Ding-Jeremy/Self-Balancing-Bot/A_Documentation/Rapport/acronyms.tex

\newacronym{pid}{PID}{Proportionnal Integral Derivative}
\newacronym{imu}{IMU}{Inertial Measurement Unit}
\newacronym{foc}{FOC}{Field Oriented Control}
\newacronym{pcb}{PCB}{Printed Circuit Board}
\newacronym{gpio}{GPIO}{General Purpose Input/Output}
\newacronym{ldo}{LDO}{Low Drop Out Regulator}
\newacronym{lipo}{LiPo}{Lithium Polymer}
\newacronym{http}{HTTP}{Hypertext Transfer Protocol}
\newacronym{https}{HTTPS}{Hypertext Transfer Protocol Secure}
\newacronym{ws}{WS}{WebSocket}
\newacronym{html}{HTML}{HyperText Markup Language}
\newacronym{css}{CSS}{Cascading Style Sheets}
\newacronym{js}{JS}{JavaScript}
\newacronym{json}{JSON}{JavaScript Object Notation}
\newacronym{api}{API}{Application Programming Interface}
\newacronym{pwa}{PWA}{Progressive Web App}
\newacronym{uri}{URI}{Uniform Resource Identifier}
\newacronym{url}{URL}{Uniform Resource Locator}
\newacronym{spa}{SPA}{Singe Page Application}
\newacronym{fdm}{FDM}{Fused Filament Fabrication}
\newacronym{lqr}{LQR}{Linear Quadratic Regulator}
