Ding-Jeremy/Self-Balancing-Bot/A_Documentation/Rapport/report.tex

\documentclass[
    iai, % Saisir le nom de l'institut rattaché
    eem, % Saisir le  nom de l'orientation
    %confidential, % Décommentez si le travail est confidentiel
]{heig-tb} 

\usepackage[nooldvoltagedirection,european,americaninductors]{circuitikz}
%% \signature{jding.svg} % Remplacer par votre propre signature vectorielle.
\usepackage{pdflscape}
\usepackage{pdfpages}
\usepackage{listings}
\usepackage{xcolor}
\usepackage{subcaption}
\raggedbottom

\lstset{
    language=C++,
    basicstyle=\ttfamily\small,
    keywordstyle=\color{blue},
    commentstyle=\color{gray},
    stringstyle=\color{red},
    numbers=left,
    breaklines=true,
    showstringspaces=false,
    inputencoding=utf8,
    extendedchars=true,
    literate=
        {é}{{\'e}}1
        {è}{{\`e}}1
        {ê}{{\^e}}1
        {à}{{\`a}}1
        {â}{{\^a}}1
        {ç}{{\c{c}}}1
        {°}{{\textdegree}}1
}
\makenomenclature
\makeglossaries
\makeindex
\addbibresource{bibliography.bib}   
  
\input{acronyms.tex}
\input{glossary.tex}
\input{meta.tex} 

\surroundwithmdframed{minted} 
 
%% Début du document
\begin{document}
\selectlanguage{french}
\maketitle
\frontmatter

%% Requis par les dispositions générales des travaux de Bachelor
\preamble
\authentification
%% Résumé / Résumé publiable / Version abrégée

%% Sommaire et tables
\tableofcontents
\listoffigures
\listoftables
\listoflistings

\input{nomenclature.tex}

\printglossary[type=\acronymtype]

\pagenumbering{arabic}

%% Contenu
\mainmatter
\chapter{Introduction}
\input{content/introduction.tex}
%\input{content/examples.tex}
\chapter{Principe physique}
\input{content/principe_physique.tex}
\label{chap:principe_physique}
\chapter{Choix composants}
\label{chap:choix_composants}
\input{content/choix_composants.tex}

\chapter{Mécanique}
\label{chap:mecanique}
\input{content/mecanique.tex}
\chapter{Modélisation}
\label{chap:modelisation}
\input{content/modelisation.tex}
\chapter{Electronique}
\label{chap:electronique}
\input{content/electronique.tex}
\chapter{Développement embarqué}
\label{chap:developpement_embarque}
\input{content/developpement_embarque.tex}
\chapter{Interface WEB}
\label{chap:interface_web}
\input{content/interface_web}
\chapter{Validation expérimentale} 
\input{content/validation.tex}
\chapter{Conclusion} 
\input{content/conclusion.tex}

\clearpage
\printbibliography
 
\appendix
\appendixpage
\addappheadtotoc
\chapter{Entretiens}
\input{content/entretiens.tex}

\chapter{Schéma, PCB}
\label{annexe:schema_electrique}

\includepdf[
    pages=-,
    fitpaper=true,
    pagecommand={\thispagestyle{plain}}
]{assets/annexes/Self_Balancing_Bot_V0.pdf}

\includepdf[
    pages=-,
    fitpaper=true,
    pagecommand={\thispagestyle{plain}}
]{assets/annexes/kicad_pcb_fcu.pdf}
\includepdf[
    pages=-,
    fitpaper=true,
    pagecommand={\thispagestyle{plain}}
]{assets/annexes/kicad_pcb_in1cu.pdf}
\includepdf[
    pages=-,
    fitpaper=true,
    pagecommand={\thispagestyle{plain}}
]{assets/annexes/kicad_pcb_in2cu.pdf}
\includepdf[
    pages=-,
    fitpaper=true,
    pagecommand={\thispagestyle{plain}}
]{assets/annexes/kicad_pcb_bcu.pdf}

\chapter{Bill Of Material}

\label{annexe:bom}
\includepdf[
    pages=-,
    fitpaper=true,
    pagecommand={\thispagestyle{plain}}
]{assets/annexes/bom.pdf}

\chapter{Dépôt Git}
\label{annexe:git}
L'ensemble du projet est versionné avec \textit{Git}. Le dépôt regroupe le firmware embarqué, l'interface Web, les schémas électroniques, le présent rapport ainsi que les différents documents administratifs relatifs au projet.

Le dépôt GitHub est accessible à l'adresse suivante :

\begin{center}
\href{https://github.com/Ding-Jeremy/Self-Balancing-Bot}{github.com/Ding-Jeremy/Self-Balancing-Bot}
\end{center}

\let\cleardoublepage\clearpage
\backmatter

\label{glossaire}
\glsaddall[types=main]
\printglossary
\label{index}
\printindex

\end{document}
