Ding-Jeremy/Self-Balancing-Bot/A_Documentation/Rapport/glossary.tex

\newglossaryentry{heig-vd}{
    name=HEIG-VD,
    description={Haute École d'Ingénierie et de Gestion du canton de Vaud}
}
\newglossaryentry{hes-so}{
    name=HES-SO,
    description={Haute École Supérieure de Suisse Occidentale}
}

\newglossaryentry{eth}{
    name=ETH,
    description={Haute École Supérieure de Suisse Occidentale}
}

\newglossaryentry{uart}{
    name=UART,
    description={Universal Asynchroneous Receive Transmit, serial protocol}
}
