Ding-Jeremy/Self-Balancing-Bot/A_Documentation/Rapport/content/electronique.tex

Cette partie présente la conception et la réalisation de l'architecture électronique développée pour le système. Elle décrit les différents choix effectués afin de répondre aux contraintes liées à l'alimentation, au traitement des informations, au pilotage des actionneurs et à l'intégration des différents composants électroniques.

Dans un premier temps, la méthode de conception ainsi que les outils utilisés sont introduits. L'architecture générale du système est ensuite présentée au travers d'un schéma bloc permettant d'identifier les principaux sous-ensembles électroniques et leurs interactions. Les solutions retenues pour l'alimentation sont détaillées, notamment le dimensionnement de la source d'énergie, les dispositifs de conversion de tension et la distribution des différentes alimentations nécessaires aux composants.

La conception de l'électronique de commande est ensuite abordée avec la présentation du microcontrôleur ESP32, des circuits de pilotage des moteurs pas à pas ainsi que du module de mesure inertielle. Les choix de composants sont justifiés en fonction des besoins du système et des contraintes de fonctionnement.

Enfin, cette partie décrit la réalisation du schéma électrique complet, l'assemblage des premiers prototypes sur breadboard ainsi que la conception du circuit imprimé \gls{pcb}
\section{Méthode et outils}

Dans un premier temps, il est important de présenter les différents outils utilisés dans la conception et la réalisation de la partie électronique du projet.

\begin{table}[H]
\centering
\begin{tabular}{|l|l|}
\hline
\textbf{Tâche} & \textbf{Outil utilisé} \\
\hline
Conception des schémas électriques et architecture bloc & draw.io (diagrams.net) \\
\hline
Conception et routage du PCB & KiCad 9.0 \\
\hline
\end{tabular}
\caption{Outils utilisés dans la réalisation de la partie électronique du projet}
\label{tab:outils_utilises_electronique}
\end{table}

\section{Alimentation}
\label{section:alimentation}
Afin de designer correctement le système électrique, il est important de définir les prérequis en terme d'alimentation. Plus précisemment, le but est ici de déterminer les tensions et courants de fonctionnement nécessaires pour les
différents modules.
\subsection{ESP32}
L'ESP32 Devkit V1 \cite{ESP32-Devkit-V1} peut être alimenté de deux manière différentes. Soit alimenté en 5 V soit en 3.3 V. En effet ce dernier possède un réglateur linéaire,  \gls{ldo} offrant une tension de 3.3 V.
Ce régulateur sert à générer la tension nécessaire au fonctionnement du chip ESP32 présent sur la carte de développement mais peut également être utilisé pour alimenter des modules externes pour autant que ces derniers ne consomment pas trop d'énérgie.
Le \acrshort{ldo} est de type \cite{AMS1117} et offre un courant de 1 A pour une chute de tension de 1.2 V.
Comme indiqué dans le chapitre \ref{chap:choix_composants}, le courant consommé par l'ESP32 dépend de son utilisation, dans le pire cas de figure, ce dernier consomme un courant maximale de:
$$I_{ESP,max} = 0.4 \si\ampere$$
Cela veut dire que le LDO présent sur la carte de développement peut fournir un courant aux autres modules valant:
$$I_{LDO,max} = 0.6 \si\ampere$$

\subsection{TMC2226}
Le driver moteur nécessite deux alimentations distinctes, une alimentation pour la logique, $V_{IO}$, ainsi qu'une alimentation pour les moteurs, $V_{mot}$. Les valeurs de tensions nécessaires ont déjà étées indiquées dans le chapitre \ref{chap:choix_composants}. 
\begin{itemize}
    \item Tension moteur : $V_{\mathrm{mot}} \in [5.5, 29]\,\mathrm{V}$
    \item Tension logique : $V_{\mathrm{DD}} \in [3.3, 5]\,\mathrm{V}$
\end{itemize}

En ce qui concerne le courant consommé par le module sur son entrée \SI{3.3}{V}, la valeur indiquée dans le datasheet \cite{TMC2226_datasheet} est présentée à la figure \ref{fig:tmc_2226_consumption}.

\begin{figure}[H]
    \centering
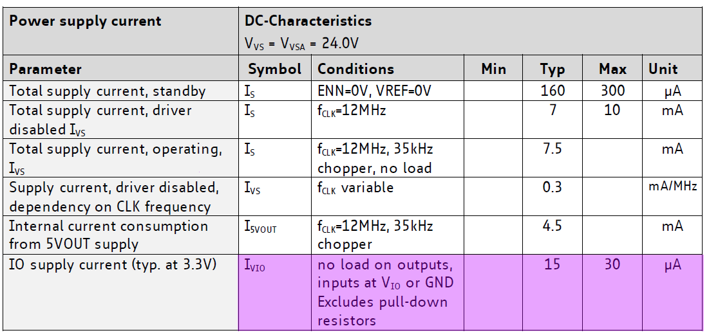
[picture p11: A_Documentation/Rapport/assets/figures/tmc2226_consumption.png]
    
    \caption{Consommation du TMC2226}
    \label{fig:tmc_2226_consumption}
\end{figure}

Le datasheet précise que cette valeur correspond au courant consommé lorsque les sorties ne fournissent aucune charge (\textit{no loads on output}). Aucune autre information concernant la consommation propre de la logique interne du composant n'est fournie.

Afin de conserver une marge de sécurité lors du dimensionnement de l'alimentation et d'éviter tout sous-dimensionnement, un courant de \SI{10}{mA} est retenu pour l'alimentation logique du module.

\subsection{MPU6050}
Le datasheet du module \acrshort{imu} \cite{MPU6050_Datasheet} indique les informations suivantes concernant la consommation d'énergie.
\begin{figure}[H]
    \centering
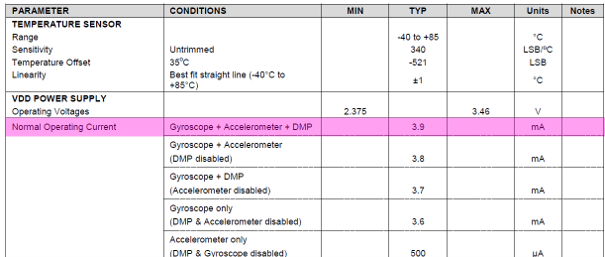
[picture p12: A_Documentation/Rapport/assets/figures/mpu_6050_consumption.png]
    
    \caption{Consommation MPU6050}
    \label{fig:mpu_6050_consumption}
\end{figure}

\subsection{Moteurs}
La puissance consommée par le moteur dépend de son point de fonctionnement.
À l'arrêt, l'énergie électrique est essentiellement dissipée sous forme de
pertes Joule dans les enroulements. En revanche, lorsque le moteur fournit un
couple et entraîne une charge, une partie de cette énergie est convertie en
puissance mécanique.
\subsubsection{Courant max}
\label{subsubsection:courant_max}
Le courant efficace fourni par le driver est réglé via un potentiomètre qui fixe la tension de référence $V_{\mathrm{ref}}$. Il est donné par :

\begin{equation}
    \begin{split}
        I_{\mathrm{RMS}} =
        \frac{0.325\,\mathrm{V}}{R_{\mathrm{sense}} + 0.02\,\Omega}
        \cdot \frac{1}{\sqrt{2}}
        \cdot \frac{V_{\mathrm{ref}}}{2.5\,\mathrm{V}}
    \end{split}
\end{equation}

La résistance de mesure $R_{\mathrm{sense}}$ est donnée par le constructeur du module \cite{BigTechTree_TMC2226}. Elle est également vérifiable physiquement sur le PCB et vaut :
\begin{equation}
R_{\mathrm{sense}} = 150\,\mathrm{m\Omega} = 0.150\,\Omega.
\end{equation}

Le moteur \cite{42SHD0217_datasheet} supporte un courant maximal de
$1.5\,\mathrm{A_{RMS}}$, ce qui conduit à

\begin{equation}
V_{\mathrm{ref,max}}
\approx
\frac{1.5}{0.540}
\approx
2.8\,\mathrm{V}.
\end{equation}

La plage théorique de fonctionnement est donc

\begin{equation}
0 \leq V_{\mathrm{ref}} \leq 2.8\,\mathrm{V}.
\end{equation}

Cependant, après essais du module BigTechTree \cite{BigTechTree_TMC2226}, il a été constaté que le potentiomètre ne permet de régler la tension
$V_{\mathrm{ref}}$ que dans une plage comprise entre environ
$0\,\mathrm{V}$ et $1.75\,\mathrm{V}$, bien que cette limitation ne soit pas explicitement mentionnée dans la documentation.

Une tension de référence de

\begin{equation}
V_{\mathrm{ref}} = 1.5\,\mathrm{V}
\end{equation}

est donc retenue. Elle correspond à un courant efficace dans les enroulements de

\begin{equation}
I_{\mathrm{RMS}}
\approx
0.540 \times 1.5
=
0.81\,\mathrm{A}.
\end{equation}

\begin{figure}[H]
    \centering
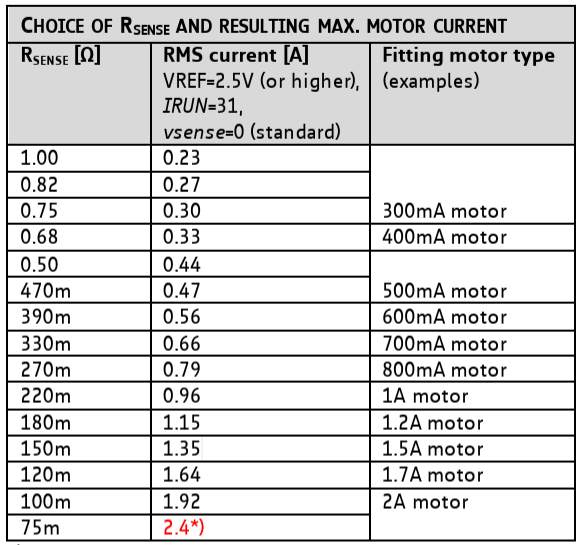
[picture p13: A_Documentation/Rapport/assets/figures/tmc_datasheet_rsense.png]
    
    \caption{Extrait de la documentation du TMC2226 présentant les différentes valeurs de résistance de mesure ($R_{\mathrm{sense}}$).}
    \label{fig:tmc2226_datasheet_rsense}
\end{figure}

La figure~\ref{fig:tmc2226_datasheet_rsense} présente les valeurs recommandées de $R_{\mathrm{sense}}$ en fonction du courant nominal du moteur. Dans le cas présent, le moteur possède un courant nominal de $1.5\,\mathrm{A}$, ce qui correspond bien à la résistance de mesure retenue \cite{42SHD0217_datasheet}.

\subsubsection{Puissance électrique}

La puissance électrique absorbée par le moteur peut être estimée par

\begin{equation}
P_{\mathrm{elec}}
\approx
2I_{\mathrm{RMS}}^{2}R_c
+
T_m\omega,
\end{equation}

où $I_{\mathrm{RMS}}$ est le courant efficace dans chaque enroulement,
$R_c$ la résistance d'une bobine,
$T_m$ le couple développé par le moteur et
$\omega$ sa vitesse angulaire.

Afin d'obtenir un ordre de grandeur, on considère un couple correspondant à la moitié du couple maximal du moteur ainsi qu'une vitesse de rotation de
1 tour/s.

La vitesse angulaire vaut alors

\begin{equation}
\omega
=
2\pi\times1
=
6.28\,\si{\radian\per\second}.
\end{equation}

La puissance mécanique développée est donc

\begin{equation}
P_{\mathrm{meca}}
=
T_m\omega
=
0.2\times6.28
=
1.26\,\si{\watt}.
\end{equation}

En prenant la valeur de résistance donnée par le datasheet du moteur pas à pas, 
$R_c=2.2\,\Omega$ et le courant efficace précédemment calculé, les pertes Joule valent

\begin{equation}
P_{\mathrm{Joule}}
=
2I_{\mathrm{RMS}}^2R_c
=
2\times0.81^2\times2.2
\approx
2.9\,\si{\watt}.
\end{equation}

La puissance électrique totale est alors estimée à

\begin{equation}
P_{\mathrm{elec}}
=
P_{\mathrm{Joule}}
+
P_{\mathrm{meca}}
=
2.9
+
1.26
\approx
4.16\,\si{\watt}.
\end{equation}

Afin de conserver une marge de sécurité pour le dimensionnement de la batterie, la puissance maximale consommée par un moteur est fixée à

\begin{equation}
P_{\mathrm{max}} = 5\,\si{\watt}.
\end{equation}
\subsection{Ensemble}
Voici ci-dessous un récapitulatif des différents modules ainsi que leurs caractéristiques électriques.

\begin{table}[H]
\centering
\begin{tabular}{|c|p{4.2cm}|c|c|c|}
\hline
\textbf{Module} & \textbf{Description} & \textbf{Tension} & \textbf{Courant} & \textbf{Puissance} \\
\hline
ESP32 DevKit V1 & Microcontrôleur & $5\,\si{\volt}$ & $400\,\si{\milli\ampere}$ (max.) & $2.0\,\si{\watt}$ \\
\hline
TMC2226 & Driver moteur (logique) & $3.3\,\si{\volt}$ & $\approx 30\,\si{\micro\ampere}$ & $\approx 99\,\si{\micro\watt}$ \\
\hline
MPU6050 & IMU (accéléromètre + gyroscope) & $3.3\,\si{\volt}$ & $\approx 4\,\si{\milli\ampere}$ & $\approx 13.2\,\si{\milli\watt}$ \\
\hline
42SHD0217 & Moteurs pas à pas & - & - & $\approx 10\,\si{\watt}$ \\
\hline
\end{tabular}
\caption{Caractéristiques électriques des différents modules.}
\label{tab:tensions_alimentations}
\end{table}
\subsection{Convertisseur / Régulateur}

Les modules alimentés en \SI{3.3}{\volt}, à savoir le MPU6050 et les entrées logiques des drivers TMC2226, présentent une consommation très faible. Leur courant total est inférieur à \SI{10}{\milli\ampere}. Cette consommation reste largement inférieure au courant maximal pouvant être fourni par le régulateur linéaire intégré à la carte ESP32 DevKit V1.

Il est donc possible d'utiliser directement la sortie \SI{3.3}{\volt} de la carte de développement pour alimenter l'ensemble de la partie logique du système, sans qu'un régulateur supplémentaire ne soit nécessaire. Cette solution permet de réduire le nombre de composants, de simplifier le schéma électrique et de limiter les coûts.

En revanche, le système est alimenté par une batterie dont la tension est supérieure à \SI{5}{\volt}. Une conversion de tension est donc nécessaire afin d'alimenter correctement la carte ESP32 DevKit V1. Pour cette fonction, un convertisseur DC/DC abaisseur (\emph{buck converter}) est retenu plutôt qu'un régulateur linéaire. En effet, un convertisseur à découpage présente un rendement élevé, généralement supérieur à 90\,\%, ce qui limite les pertes d'énergie et l'échauffement du système.

Le convertisseur retenu est le module TSR~1-2450E \cite{TSR1-2450E}. Celui-ci est disponible chez Distrelec et présente les caractéristiques principales suivantes :

\begin{itemize}
    \item tension d'entrée : $V_{\mathrm{in}} \in [7,36]\,\si{\volt}$ ;
    \item tension de sortie : $V_{\mathrm{out}} = \SI{5.0}{\volt}$ ;
    \item courant de sortie maximal : $I_{\mathrm{out,max}} = \SI{1}{\ampere}$ ;
    \item rendement typique : supérieur à 90\,\%.
\end{itemize}

Le courant maximal consommé par l'ensemble de l'électronique alimentée en \SI{5}{\volt} est estimé à environ \SI{0.4}{\ampere}. Le convertisseur dispose donc d'une marge de fonctionnement confortable, garantissant un fonctionnement fiable tout en laissant la possibilité d'ajouter de futurs périphériques.

\subsection{Batterie}
\subsubsection{Technologie}
\label{subsubsection:technologie}

Au regard des besoins du système, une batterie \gls{lipo} constitue la solution la plus adaptée. Ce type de batterie offre une densité énergétique élevée, un poids réduit ainsi qu'une capacité à fournir des courants importants, outre l'important courant, ces caractéristiques sont intéressantes pour ce cas d'application.

Par ailleurs, la documentation du driver moteur TMC2226 indique que les performances du moteur, notamment à vitesse élevée, sont améliorées lorsque la tension d'alimentation $V_{\mathrm{mot}}$ est importante. Une tension élevée permet en effet au courant de s'établir plus rapidement dans les enroulements malgré leur inductance, ce qui améliore le maintien du couple à vitesse élevée.

Pour cette raison, une batterie LiPo à quatre cellules (4S) est retenue. Une telle batterie présente une tension nominale de $\SI{14.8}{\volt}$, une tension maximale de $\SI{16.8}{\volt}$ lorsqu'elle est entièrement chargée et une tension minimale d'environ $\SI{12}{\volt}$ avant recharge. Cette plage de fonctionnement est compatible avec la tension d'alimentation admissible du TMC2226.

Le cahier des charges impose une autonomie minimale de

\begin{equation}
t_{\mathrm{life}}=\SI{30}{\minute}=0.5\,\si{\hour}.
\end{equation}
À partir de la consommation électrique estimée de l'ensemble du système, il est alors possible de déterminer la capacité énergétique minimale de la batterie.

\subsubsection{Capacité}

La capacité de la batterie est déterminée à partir de la puissance maximale consommée par le système ainsi que de l'autonomie imposée par le cahier des charges.

En notant $P_{\mathrm{tot}}$ la puissance totale consommée par le système, l'énergie minimale à fournir est donnée par

\begin{equation}
E_{\mathrm{bat}}
=
P_{\mathrm{tot}}\times t_{\mathrm{life}}
=
15\,\si{\watt}
\times
0.5\,\si{\hour}
=
7.5\,\si{\watt\hour}.
\end{equation}

La batterie devra donc être capable de fournir au minimum une énergie de
$\SI{7.5}{\watt\hour}$.

\subsubsection{Choix}

Parmi les batteries disponibles répondant aux critères précédents, le modèle
SWAY FPV LiPo 4S \cite{SWAY-FPV_LiPo-4S} a été retenu. Ses principales caractéristiques sont résumées dans le tableau~\ref{tab:batterie}.

\begin{table}[H]
\centering
\begin{tabular}{|l|c|}
\hline
\textbf{Caractéristique} & \textbf{Valeur} \\
\hline
Technologie & LiPo 4S \\
\hline
Tension nominale & $\SI{14.8}{\volt}$ \\
\hline
Capacité & $\SI{1.3}{\ampere\hour}$ \\
\hline
Énergie stockée & $\SI{19.24}{\watt\hour}$ \\
\hline
Courant de décharge maximal & $60C$ ($\SI{78}{\ampere}$) \\
\hline
Connecteur & XT60 \\
\hline
\end{tabular}
\caption{Caractéristiques de la batterie retenue.}
\label{tab:batterie}
\end{table}

L'énergie disponible dans cette batterie est donnée par

\begin{equation}
E_{\mathrm{bat}}
=
V_{\mathrm{nom}}
\times
C
=
14.8\times1.3
=
19.24\,\si{\watt\hour}.
\end{equation}

En supposant une consommation moyenne de
$P_{\mathrm{tot}}=\SI{15}{\watt}$, l'autonomie théorique vaut

\begin{equation}
t_{\mathrm{autonomie}}
=
\frac{E_{\mathrm{bat}}}{P_{\mathrm{tot}}}
=
\frac{19.24}{15}
=
1.28\,\si{\hour}
\approx
77\,\si{\minute}.
\end{equation}

Cette autonomie est largement supérieure à l'exigence minimale de
30 minutes définie dans le cahier des charges. La batterie retenue offre ainsi une marge confortable permettant de compenser les pertes du convertisseur DC/DC, les variations de consommation des moteurs ainsi que le vieillissement naturel de la batterie.

\section{Schéma Bloc}
Une fois les informations relatives aux composants, à la batterie et à l'architecture générale d'alimentation établies, il est possible d'esquisser un schéma bloc permettant de représenter de manière synthétique les différents modules du système ainsi que leurs interconnexions fonctionnelles.

\begin{figure}[H]
    \centering
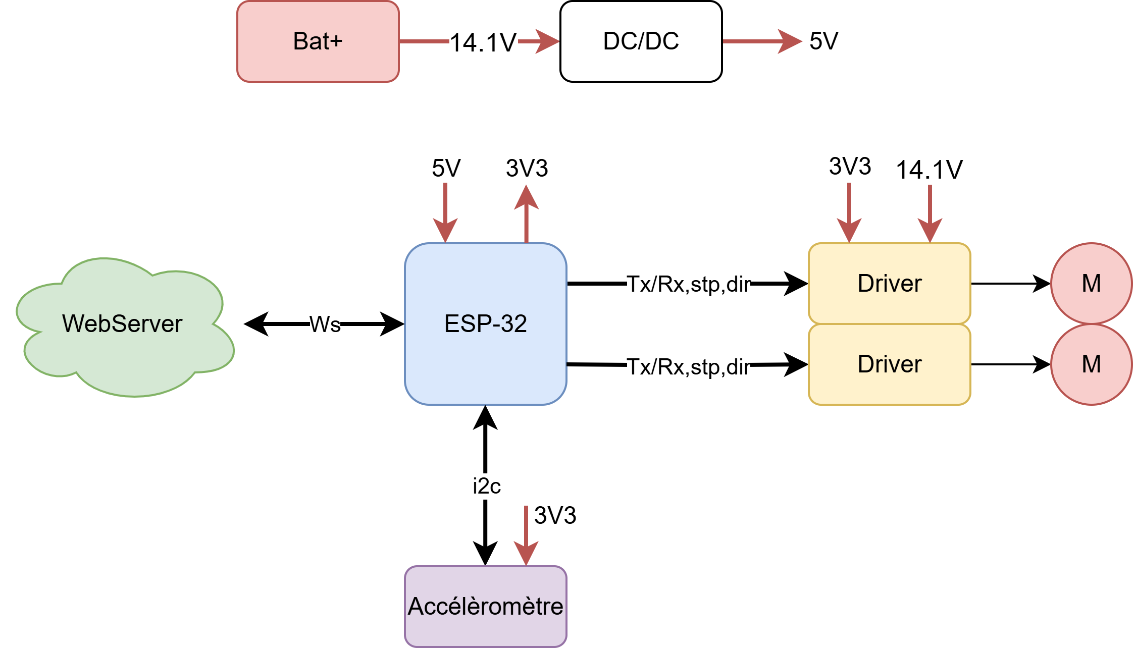
[picture p14: A_Documentation/Rapport/assets/schemas/Schema_electronique.drawio.png]
    
    \caption{Schéma bloc électrique du système}
    \label{fig:schema_bloc_electrique}
\end{figure}

Comme illustré sur la figure~\ref{fig:schema_bloc_electrique}, l'ESP32 constitue l'élément central du système. Il assure à la fois les fonctions de calcul, de communication et de supervision globale. L'ensemble de l'architecture logicielle, incluant l'algorithme de contrôle et le serveur web embarqué, s'exécute directement sur ce microcontrôleur.

L'ESP32 interagit avec les différents sous-systèmes selon plusieurs protocoles de communication adaptés à leurs contraintes respectives.

\paragraph{Commande des moteurs}
Les moteurs pas à pas sont pilotés via des drivers TMC2226. La communication entre l'ESP32 et ces derniers repose sur une interface UART, utilisée principalement pour la configuration dynamique des registres internes du driver.

En complément, deux lignes \acrshort{gpio} sont utilisées pour la génération des signaux de commande temporelle (notamment STEP et DIR). Ces signaux déterminent respectivement l'avancement des pas moteurs et le sens de rotation.

\paragraph{Acquisition inertielle}
L'unité de mesure inertielle (IMU) MPU6050 est connectée à l'ESP32 via le bus I2C, un protocole série synchrone particulièrement adapté aux capteurs embarqués à faible débit. Ce choix permet une communication avec câblage réduit (deux lignes de données uniquement : SDA et SCL).

L'IMU fournit des mesures d'accélération et de vitesse angulaire utilisées pour l'estimation de l'état du système (orientation, stabilité et dynamique du mouvement). Ces données sont ensuite exploitées par l'algorithme de contrôle exécuté sur l'ESP32.

\paragraph{Supervision et interface utilisateur}
Le système est supervisé par un serveur web embarqué directement sur l'ESP32. Ce serveur permet la visualisation des données en temps réel ainsi que l'envoi de commandes utilisateur. Cette solution présente l'avantage de ne nécessiter aucun matériel externe dédié à l'interface homme-machine, tout en permettant une interaction sans fil avec le système via Wi-Fi.

\paragraph{Actionnement}
Les moteurs (représentés en rouge sur le schéma) constituent les éléments d'action du système. Ils sont contrôlés par les drivers TMC2226.

\section{Schéma Electrique}
Le schéma électrique complet ainsi que le circuit imprimé se trouvent en annexe \ref{annexe:schema_electrique}. Ici, les différentes parties du schéma sont décomposées afin d'êtres décrites.
De plus, la liste de pièce complète est également disponible en annexe \ref{annexe:bom}.

\subsection{ESP32 Devkit V1}

\begin{figure}[H]
    \centering
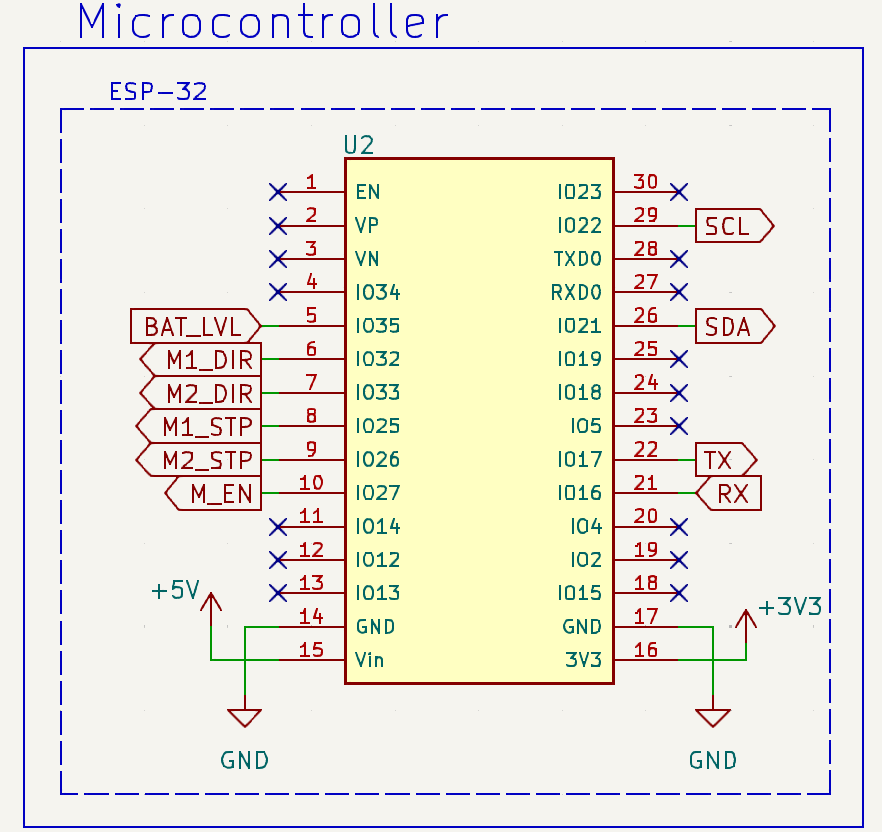
[picture p15: A_Documentation/Rapport/assets/figures/schema_ESP32.png]
    
    \caption{Schema: ESP32}
    \label{fig:ESP32}
\end{figure}

\begin{figure}[H] 
    \centering 
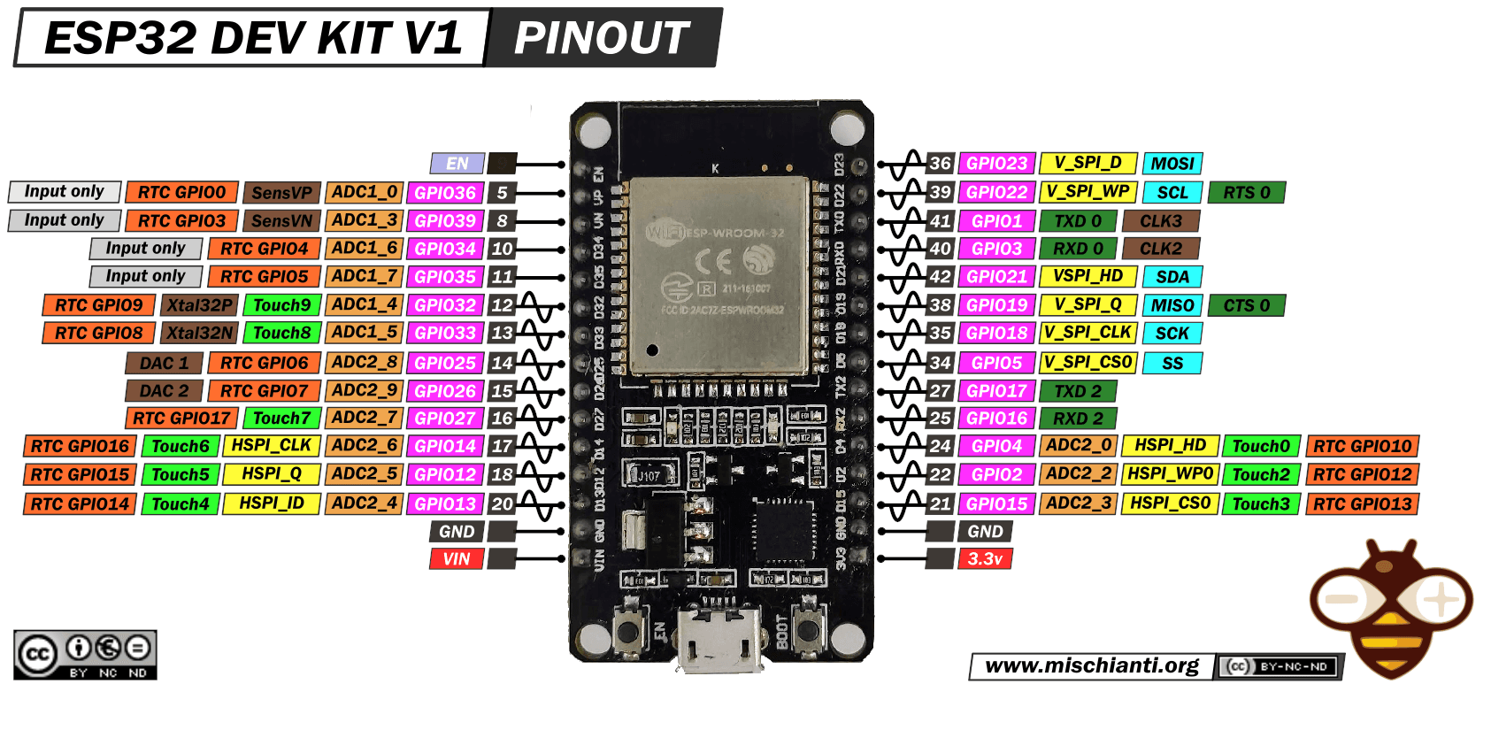
[picture p16: A_Documentation/Rapport/assets/figures/esp32_pinout.png]
     
    \caption{Pinout ESP32} 
    \label{fig:pinout ESP32} 
\end{figure}

Le choix des pins utilisées repose principalement sur le Pinout présenté à la figure \ref{fig:pinout ESP32}. Celui-ci permet d'identifier les différentes fonctionnalités disponibles sur chaque broche ainsi que leurs éventuelles limitations.

Cette carte de développement ne nécessite aucun composant externe supplémentaire indispensable à son fonctionnement. En effet, elle intègre déjà les éléments nécessaires tels que le régulateur de tension, le convertisseur USB-UART ainsi que les circuits permettant sa programmation.

Les pins utilisées afin de contrôler l'ensemble des modules sont des broches \acrshort{gpio} ainsi que des broches séries I2C, UART. 

La pin n°35 constitue une exception. Celle-ci est une broche dite "Input Only", c'est-à-dire qu'elle ne peut être utilisée qu'en entrée. Cependant, elle possède également une entrée analogique reliée au convertisseur analogique-numérique (ADC) de l'ESP32.

Elle est donc utilisée pour effectuer la mesure de la tension de la batterie comme décrit plus bas.

Les broches utilisées pour RX et TX correspondent à l'interface UART2, l'ESP32 possède en effet plusieurs interfaces UART.

Les broches utilsées pour SCL et SDA (protocle I2C) sont les broches indiquées par le pinout.

\subsection{TMC2226}

\begin{figure}[H]
    \centering
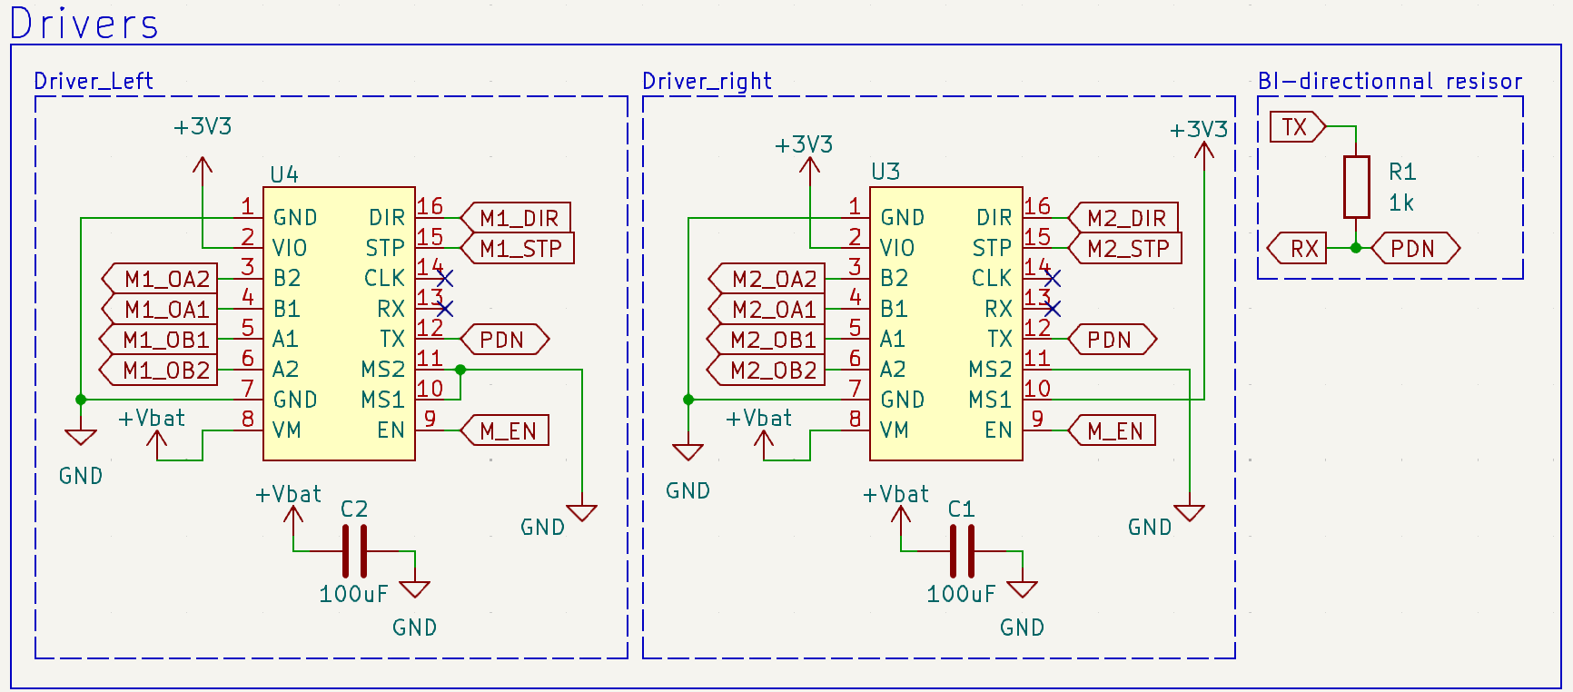
[picture p17: A_Documentation/Rapport/assets/figures/schema_drivers.png]
    
    \caption{Schema: TMC2226}
    \label{fig:tmc_2226}
\end{figure}

Le câblage des modules TMC2226 est réalisé conformément aux recommandations fournies dans le datasheet du composant \cite{TMC2226_datasheet}. Ce driver permet de commander des moteurs pas à pas tout en offrant des fonctionnalités avancées telles que la configuration du courant moteur, la sélection du mode de microstepping ainsi que la communication avec un microcontrôleur via une interface UART.

Afin de permettre l'utilisation d'une communication UART bidirectionnelle, une résistance doit être ajoutée entre les lignes RX et TX du microcontrôleur. Cette résistance permet de réaliser une communication sur une seule ligne de données en partageant le même canal pour l'émission et la réception.

fLes pins MS1 et MS2 permettent normalement de sélectionner le mode de microstepping du moteur. Cependant, dans le cas d'une communication UART bidirectionnelle, ces mêmes broches permettent également de définir l'adresse du driver. Cette adresse est nécessaire afin d'identifier individuellement chaque module lorsqu'ils sont connectés sur un même bus de communication.

Le réglage du microstepping est donc réalisé directement par logiciel via l'écriture des registres internes du TMC2226. Cette méthode offre davantage de flexibilité puisqu'il est possible de modifier la résolution du mouvement sans modifier le câblage électrique.

La broche M EN (\textit{Motor Enable}) permet l'activation ou la désactivation du moteur. Plus précisément, elle contrôle l'alimentation des bobines du moteur. Lorsque cette entrée est désactivée, le courant dans les bobines est coupé, ce qui permet de réduire la consommation électrique et l'échauffement du moteur lorsque celui-ci n'a pas besoin de maintenir sa position.

Les quatre sorties de puissance OA1, OA2, OB1 et OB2 sont connectées aux deux bobines du moteur pas à pas. Les sorties OA commandent une première bobine tandis que les sorties OB commandent la seconde. Le driver génère ensuite automatiquement les signaux de courant nécessaires au déplacement du moteur en fonction des signaux de commande reçus.

Le datasheet recommande également l'ajout d'une capacité de découplage de valeur $100 \si{\micro\farad}$ à l'entrée de l'alimentation de moteurs $V_{mot}$.
\subsection{IMU}

\begin{figure}[H]
    \centering
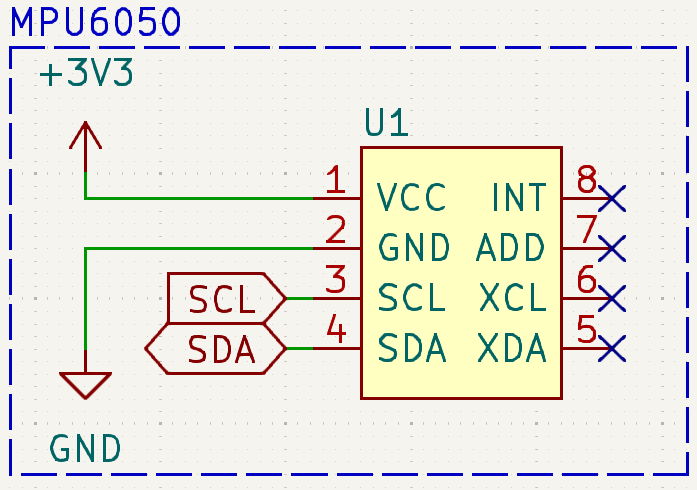
[picture p18: A_Documentation/Rapport/assets/figures/schema_imu.png]
    
    \caption{Schema: IMU}
    \label{fig:imu}
\end{figure}

Le câblage de l'\acrshort{imu} dépend du pinout présenté à la figure \ref{fig:pinout MPU6050}.

\begin{figure}[H]
    \centering
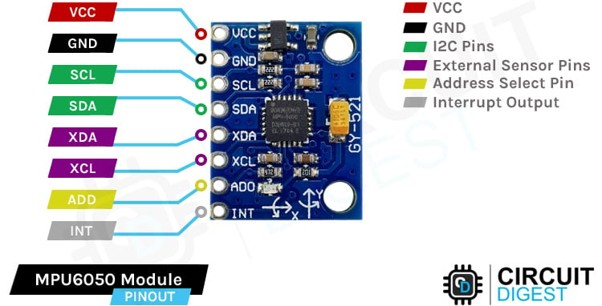
[picture p19: A_Documentation/Rapport/assets/figures/mpu6050_pinout.jpg]
    
    \caption{Pinout MPU6050}
    \label{fig:pinout MPU6050}
\end{figure}

Seules les pins SCL et SDA sont connectées étant donné qu'elles sont les seules nécessaires à la communication avec le capteur. Ces deux lignes permettent l'échange de données entre l'ESP32 et le MPU6050 via le protocole de communication I2C.

Les autres broches disponibles sur le module, telles que INT, XDA ou XCL, ne sont pas utilisées dans cette application car leurs fonctionnalités ne sont pas nécessaires.

Le protocole I2C nécessite la présence de résistances de type \textit{pull-up} sur les lignes SDA et SCL afin de garantir un fonctionnement correct du bus. Le module MPU6050 utilisé intégrant déjà ces résistances directement sur son circuit imprimé, il n'est donc pas nécessaire d'en ajouter dans le schéma électrique.

\subsection{Pont diviseur}
\label{subsectin:pont_diviseur}
\begin{figure}[H]
    \centering
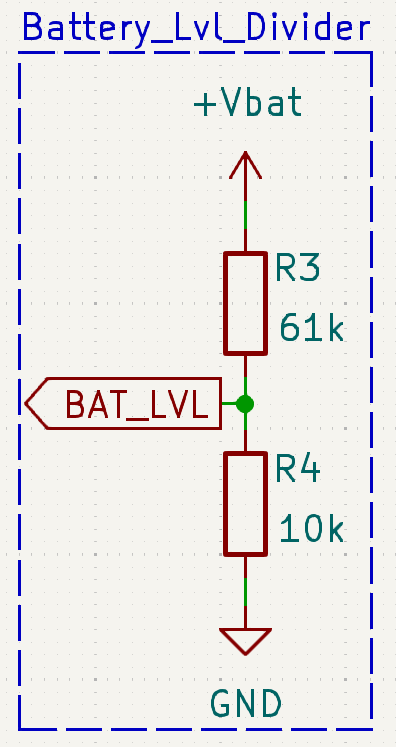
[picture p20: A_Documentation/Rapport/assets/figures/pont_diviseur.png]
    
    \caption{Schema: Pont diviseur}
    \label{fig:pont_diviseur}
\end{figure}
Afin de pouvoir mesurer le niveau de charge de la batterie avec l'ESP32, un pont diviseur de tension est utilisé. Celui-ci permet de ramener la tension de la batterie dans la plage de mesure admissible par l'entrée analogique (ADC) du microcontrôleur.

Il faut d'abord déterminer la tension maximale susceptible d'être appliquée au pont diviseur. Une batterie LiPo 4S possède une tension nominale de 14,8 V et une tension maximale de 16,8 V lorsqu'elle est complètement chargée \cite{SWAY-FPV_LiPo-4S}. Comme indiqué à la section \ref{subsubsection:technologie} sa tension varie généralement entre 12 V et 16,8 V.

Par mesure de sécurité, une tension maximale de 20 V est retenue pour le dimensionnement du pont diviseur.

Le pont diviseur est constitué des résistances suivantes :

$$
R_4 = 10~\mathrm{k}\Omega
$$

$$
R_3 = 51~\mathrm{k}\Omega
$$

La tension appliquée à l'entrée de l'ESP32 est donnée par :

\begin{equation}
    V_{ESP}=V_{BAT}\times\frac{R_4}{R_3+R_4}  
\end{equation}

En remplaçant par les valeurs choisies :

$$
V_{ESP}=V_{BAT}\times\frac{10}{51+10}
$$

$$
V_{ESP}=V_{BAT}\times\frac{10}{61}
$$

$$
V_{ESP}=V_{BAT}\times0.1639
$$

Pour la tension nominale de la batterie (\SI{14.8}{V}), la tension mesurée par l'entrée analogique de l'ESP32 est donnée par le pont diviseur de tension :

\[
V_{ESP}=V_{BAT}\times\frac{R_4}{R_3+R_4}
\]

avec \(R_3=\SI{51}{k\Omega}\) et \(R_4=\SI{10}{k\Omega}\).

Ainsi, pour la tension nominale de la batterie :

\[
V_{ESP}=14.8\times\frac{10\,000}{51\,000+10\,000}
\]

\[
V_{ESP}=14.8\times0.1639
\]

\[
V_{ESP}=2.43~\mathrm{V}
\]

Cette valeur est compatible avec la plage d'entrée analogique de l'ESP32. À la tension maximale considérée de la batterie (\SI{20}{V}), la tension appliquée à l'entrée ADC vaut :

\[
V_{ESP,max}=20\times0.1639
\]

\[
V_{ESP,max}=3.28~\mathrm{V}
\]

Cette valeur reste inférieure à la tension maximale admissible sur l'entrée analogique de l'ESP32 (\SI{3.3}{V}), ce qui garantit un fonctionnement sûr tout en exploitant une grande partie de la plage de mesure de l'ADC.

Le courant circulant dans le pont diviseur est donné par :

\[
I=\frac{V_{BAT}}{R_3+R_4}
\]

À la tension nominale de la batterie (\SI{14.8}{V}), le courant circulant dans le pont diviseur est donné par :

\[
I=\frac{V_{BAT}}{R_3+R_4}
\]

\[
I=\frac{14.8}{51\,000+10\,000}
\]

\[
I=2.43\times10^{-4}~\mathrm{A}
\]

\[
I=0.243~\mathrm{mA}
\]

La puissance totale dissipée par le pont diviseur est alors :

\[
P_{tot}=V_{BAT}\times I
\]

\[
P_{tot}=14.8\times0.243~\mathrm{mA}
\]

\[
P_{tot}=3.60~\mathrm{mW}
\]

Cette puissance reste très faible devant la capacité énergétique de la batterie et n'a donc qu'un impact négligeable sur l'autonomie du système.
\section{Connecteurs}

Les connecteurs utilisés sur la carte sont principalement des pin headers au pas de 2,54~mm. Ce choix est motivé par leur faible coût et leur grande disponibilité.

Les connecteurs destinés aux moteurs peuvent être branchés dans les deux sens. Une inversion ne modifie que le sens de rotation du moteur, lequel peut également être corrigé par logiciel. Il n'est donc pas nécessaire d'utiliser un connecteur détrompé.

Le raccordement de la batterie est réalisé à l'aide d'un bornier à vis. Ce type de connecteur offre une bonne tenue mécanique et permet de connecter ou déconnecter facilement l'alimentation tout en garantissant un bon contact électrique. 
\begin{figure}[H]
    \centering
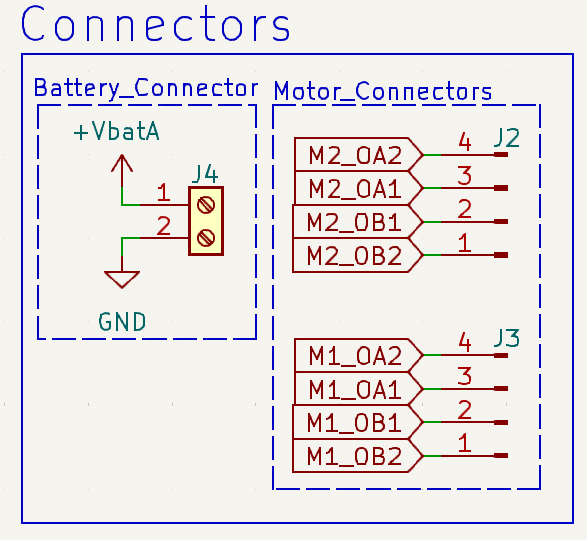
[picture p21: A_Documentation/Rapport/assets/figures/schema_connecteurs.png]
    
    \caption{Schema: Connecteurs}
    \label{fig:connecteurs}
\end{figure}

\section{Alimentation et interrupteur}

L'alimentation des composants fonctionnant sous $5~V$ est assurée par un convertisseur abaisseur TSR1-2450E \cite{TSR1-2450E}. Ce convertisseur accepte directement la tension fournie par la batterie et délivre une tension régulée de $5~V$.

Conformément aux recommandations du constructeur, ce convertisseur ne nécessite aucun composant externe pour fonctionner, ce qui simplifie le schéma électrique et réduit le nombre de composants.

La mise sous tension du système est assurée par un interrupteur coulissant (\textit{slider switch}) placé directement sur la carte électronique. Celui-ci permet de connecter ou de couper l'alimentation principale du système.
\section{Validation sur breadboard}

Avant la réalisation du circuit imprimé, l'ensemble du système est assemblé sur une breadboard afin de valider le schéma électrique ainsi que les différents branchements.

Cette étape permet de vérifier le bon fonctionnement des communications entre les modules, la commande des moteurs ainsi que la mesure des différents capteurs. Elle permet également d'identifier et de corriger d'éventuelles erreurs de câblage avant la fabrication du PCB.

Les essais réalisés montrent que le système fonctionne conformément aux attentes. Le schéma électrique est donc validé et la conception du circuit imprimé peut être entreprise.
\section{PCB}
\begin{figure}[H]
    \centering
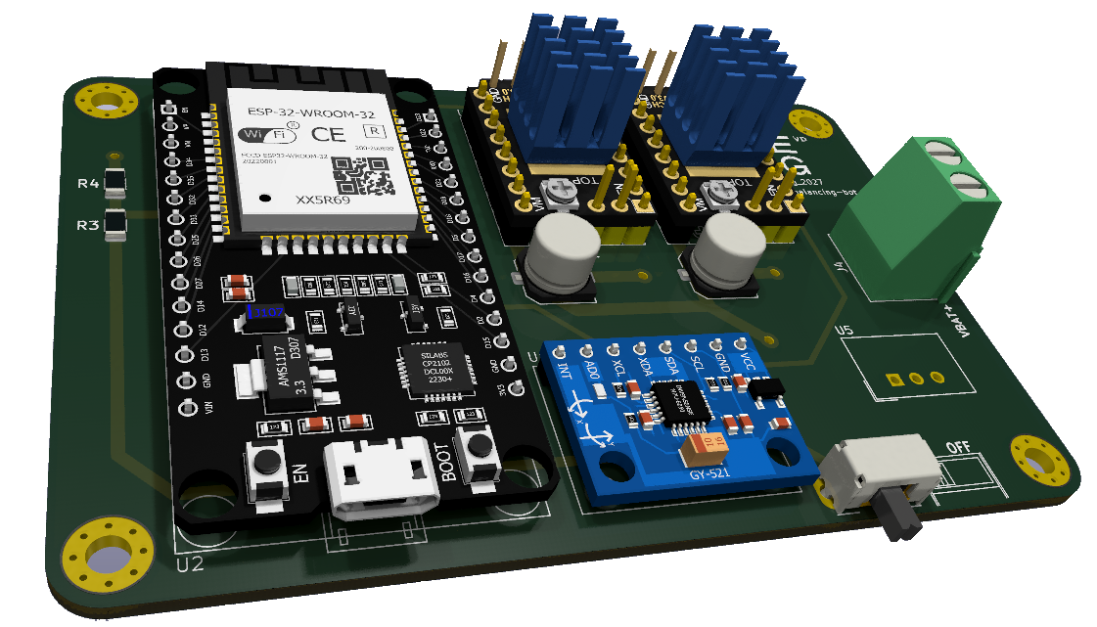
[picture p22: A_Documentation/Rapport/assets/figures/pcb.png]
    
    \caption{Circuit imprimé}
    \label{fig:pcb}
\end{figure}

Le circuit imprimé (\acrshort{pcb}) a été conçu avec KiCad 9.0. Il s'agit d'un PCB 4 couches dont voici la constitution:
\begin{itemize}
    \item F: Signaux
    \item IN1: Masse
    \item IN2: Alim
    \item B: Signaux
\end{itemize}

Les différents modules sont disposés de manière à limiter les longueurs de pistes tout en facilitant le routage. Une attention particulière est portée à la séparation des pistes de puissance et des pistes de communication afin de limiter les perturbations électromagnétiques.

Certains symboles et empreintes n'étant pas disponibles dans les bibliothèques standard de KiCad, ils ont été créés manuellement afin de correspondre aux composants utilisés.
\begin{table}[H]
\centering
\begin{tabular}{|l|l|}
\hline
\textbf{N° Référence} & \textbf{Module} \\
\hline
U2 & ESP32 Devkit V1\\
\hline
U3 & BigTechTree TMC2226\\
\hline 
U1 & GY521 (MPU6055 devboard)\\
\hline
\end{tabular}
\caption{Symboles et empreintes manuellement designées}
\label{tab:symbole_empreinte}
\end{table}

Les caractéristiques du PCB, telles que les différentes couches, les dimensions ainsi que les règles de conception retenues, sont détaillées en annexe \ref{annexe:schema_electrique}.
