Ding-Jeremy/Self-Balancing-Bot/A_Documentation/Rapport/content/mesures.tex

\section{Conditions de mesures}
Pour les mesures de tension et de courants, les roues ont été retirées de la maquette. De cette manière, le \Gls{pcb} était facilement accessible.

\subsection{Appareils de mesure}

\begin{table}[H]
    \centering
    \begin{tabular}{|l|l|l|}
        \hline
        \textbf{Type} & \textbf{Marque} & \textbf{Modèle} \\
        \hline
        Multimètre numérique & UNI-T & UT61E \\
        \hline
    \end{tabular}
    \caption{Appareils de mesure}
    \label{tab:appareils_mesure}
\end{table}

\section{Modèle physique}
\subsubsection{Régulation}
\subsubsection{Déplacement trapezoïdal}

\section{Electriques}
\subsection{Batterie}
Afin de mesurer correctement le niveau de la batterie, un pont diviseur est utilisé, comme expliqué dans le chapitre consacré à la maquette.

Il est important de s'assurer que les résistances utilisées dans le pont diviseur sont correctement reportées dans le code afin de garantir une lecture fidèle de la tension de la batterie.

\begin{table}[H]
    \centering
    \begin{tabular}{|l|c|c|}
        \hline
        \textbf{Symbole} & \textbf{Valeur théorique} & \textbf{Valeur mesurée} \\
        \hline
        R4 & 10 k$\Omega$ & 10.12 k$\Omega$ \\
        \hline
        R3 & 51 k$\Omega$ & 49.50 k$\Omega$ \\
        \hline
    \end{tabular}
    \caption{Mesure du pont diviseur}
    \label{tab:mesure_pont_diviseur}
\end{table}

 À l'aide des valeurs mesurées, le nouveau rapport du pont diviseur peut être calculé puis introduit dans le code afin d'affiner la mesure de la tension de la batterie.

Le rapport théorique du pont diviseur est donné par :

$$
\frac{R_3+R_4}{R_4}
$$

En utilisant les valeurs mesurées, on obtient :

$$
\frac{50.82 + 10.12}{10.12}=6.022
$$

Le rapport théorique valait :

$$
\frac{51+10}{10}=6.10
$$

On constate donc un écart d'environ (1\%) entre le rapport théorique et le rapport réel.

Il est alors possible de corriger les constantes utilisées dans le programme en remplaçant les valeurs nominales des résistances par les valeurs mesurées :

Le facteur de conversion utilisé pour reconstruire la tension de la batterie devient alors :

$$
\frac{50820+10120}{10120}=6.022
$$

Cette correction permet d'améliorer la précision de la mesure de la tension et de réduire l'erreur introduite par les tolérances des résistances du pont diviseur.

\subsection{Tensions, Courants}
Afin de mesurer la consommation énergétique de la maquette, l'idée est de réaliser une mesure du courant total dans le système.
Pour ce faire, le multimètre est placé en mode ampèremètre entre le connecteur de la batterie et celui du PCB.
La notion de moteurs "allumées" indiquent qu'ils tournent à vitesse maximale. (Référence à la partie programmation traitant des micropas...)

\begin{table}[H]
    \centering
    \begin{tabular}{|l|c|c|}
        \hline
        \textbf{Grandeur mesurée} & \textbf{Valeur théorique} & \textbf{Valeur mesurée} \\
        \hline
        $V_{bat}$ & - & 16.20 V \\
        \hline
        $V_{5V}$ & 5.0 V & 5.00 V \\
        \hline
        $V_{IO}$ & 3.3 V & 3.28 V \\
        \hline
        $I_{tot}$ & - & 0.065 A \\
        \hline
    \end{tabular}
    \caption{Mesures électriques - Moteurs éteints}
    \label{tab:moteurs_eteints}
\end{table}

\begin{table}[H]
    \centering
    \begin{tabular}{|l|c|c|}
        \hline
        \textbf{Grandeur mesurée} & \textbf{Valeur théorique} & \textbf{Valeur mesurée} \\
        \hline
        $V_{bat}$ & - & 16.17 V \\
        \hline
        $V_{5V}$ & 5.0 V & 5.00 V \\
        \hline
        $V_{IO}$ & 3.3 V & 3.28 V \\
        \hline
        $I_{tot}$ & - & 0.195 A \\
        \hline
    \end{tabular}
    \caption{Mesures électriques - Moteurs allumés, vitesse nulle}
    \label{tab:moteurs_allumes}
\end{table}

\begin{table}[H]
    \centering
    \begin{tabular}{|l|c|c|}
        \hline
        \textbf{Grandeur mesurée} & \textbf{Valeur théorique} & \textbf{Valeur mesurée} \\
        \hline
        $V_{bat}$ & - & 16.14 V \\
        \hline
        $V_{5V}$ & 5.0 V & 5.00 V \\
        \hline
        $V_{IO}$ & 3.3 V & 3.28 V \\
        \hline
        $I_{tot}$ & - & 0.551 A \\
        \hline
    \end{tabular}
    \caption{Mesures électriques - Moteurs allumés vitesse max}
    \label{tab:moteurs_allumes_maxspeed}
\end{table}

\subsection{Autonomie}
Afin de réaliser cette mesure d'autonomie, la maquette est enclenchée puis laissée en situation de régulation d'angle $\theta$ jusqu'à ce que la batterie atteigne un seuil critique de 5\%.

Le niveau de la batterie est mesuré toute les 5 min en utilisant l'interface Web.
