Ding-Jeremy/Self-Balancing-Bot/A_Documentation/Defense.pptx

## Self-Balancing-Bot

Travail de Bachelor 2026
GE TIN EEM
Ding Jérémy

## Sommaire

Introduction
Cahier des charges
Principe physique
Régulation

Simulation
Mesures
Conclusion

1

Mécanique
Electronique
Programmation
Interface de contrôle

2

3

## Introduction

- Application notions théoriques
- Multiple domaines
- Projet complet
- Validation modèle théorique

## Cahier des charges

- Conception
- Analyse Théorique
- Réalisation
- Programmation
- 30’ d’autonomie
- Hauteur maximale de 30 cm

## Principe physique

- Pendule inverse
- Naturellement instable
- Equations différentielles ETH

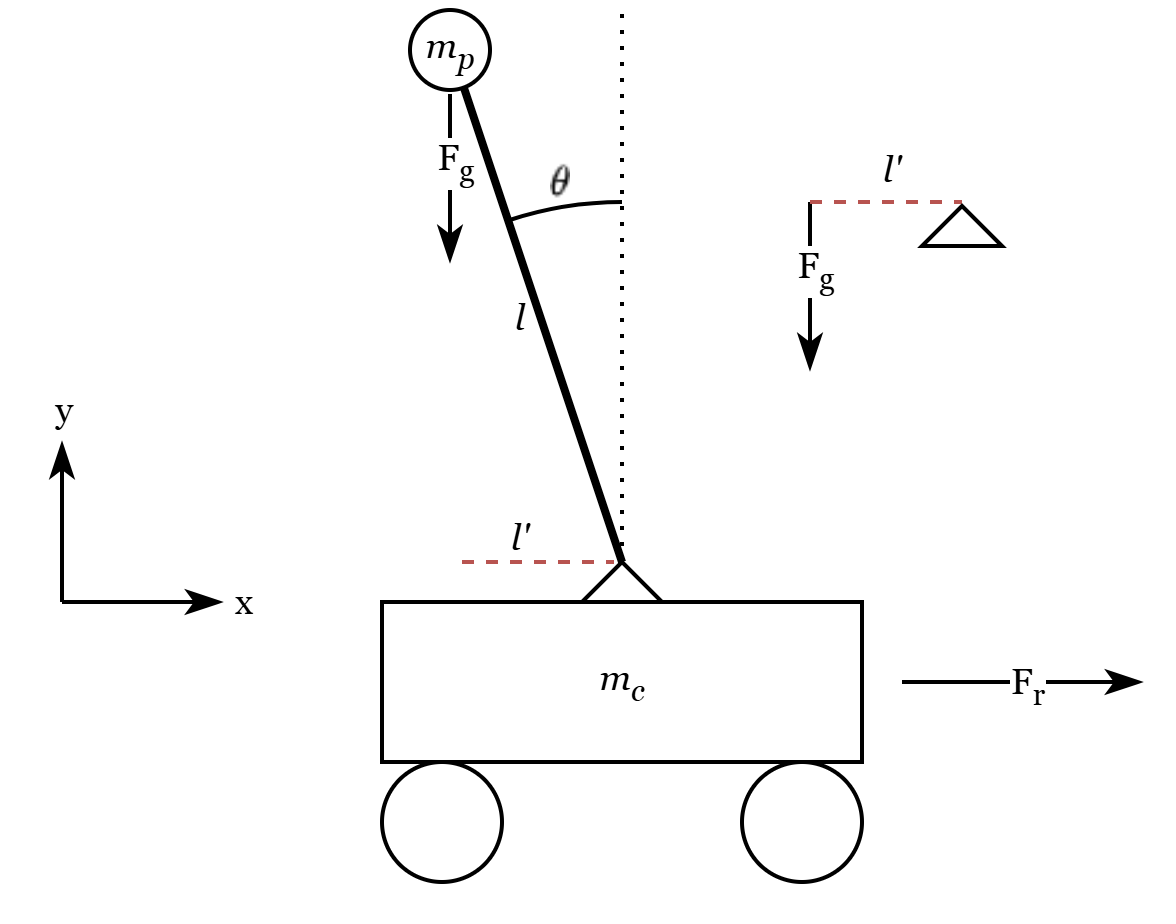
[picture p23: figure]

## Régulation

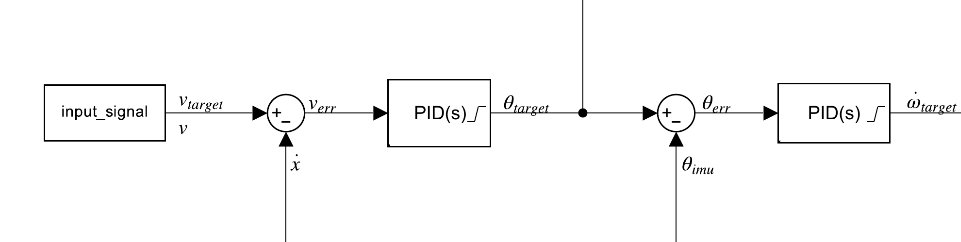
[picture p24: figure]

## Mécanique

- Fusion360
- FDM, CNC Laser
- PLA, TPU

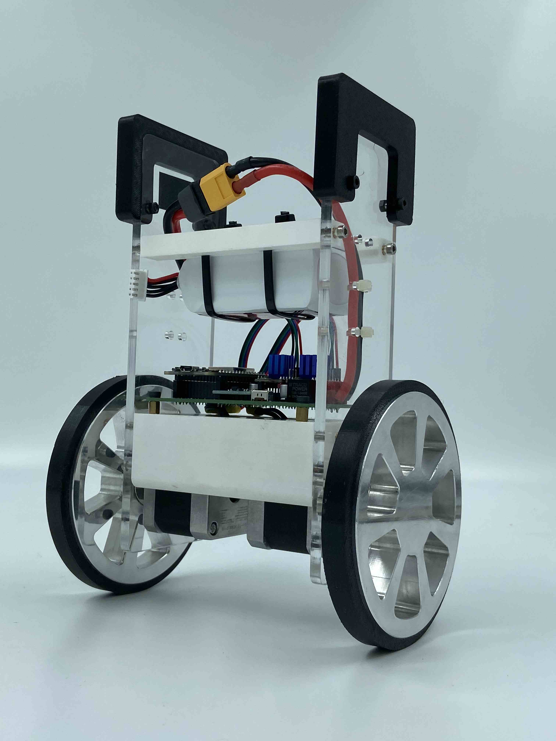
[picture p25: figure]

## Electronique Schéma bloc


## Electronique PCB

- KiCad 9.0
- JLCPCB
- 4 Couches


## Programmation

- Librairie TMC2226
- main.cpp
- + 1000 lignes

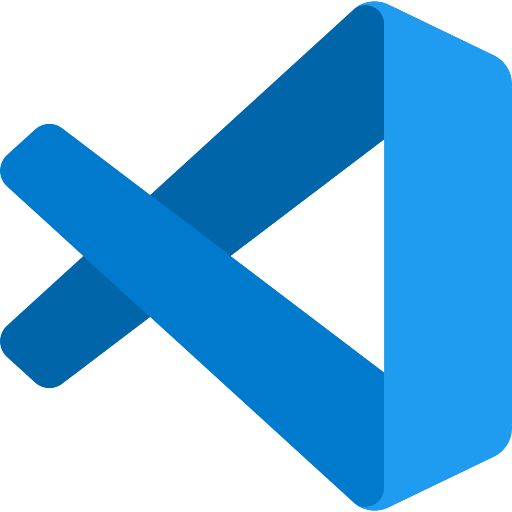
[picture p26: figure]
Visual Studio Code Icon SVG Vector & PNG Free Download | UXWing
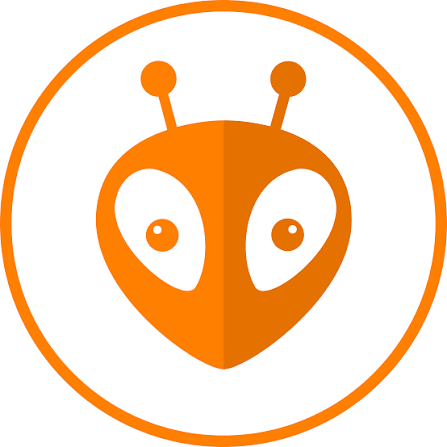
[picture p27: figure]
File:PlatformIO logo.svg - Wikimedia Commons
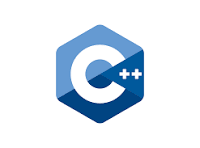
[picture p28: figure]
Download C++ Logo in SVG Vector or PNG File Format - Logo.wine
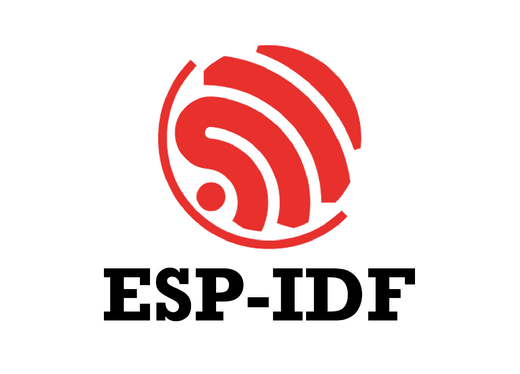
[picture p29: figure]
Getting Started With ESP-IDF | Set Up Espressif IDE – RoboticWorx

## Programmation Ordinogramme

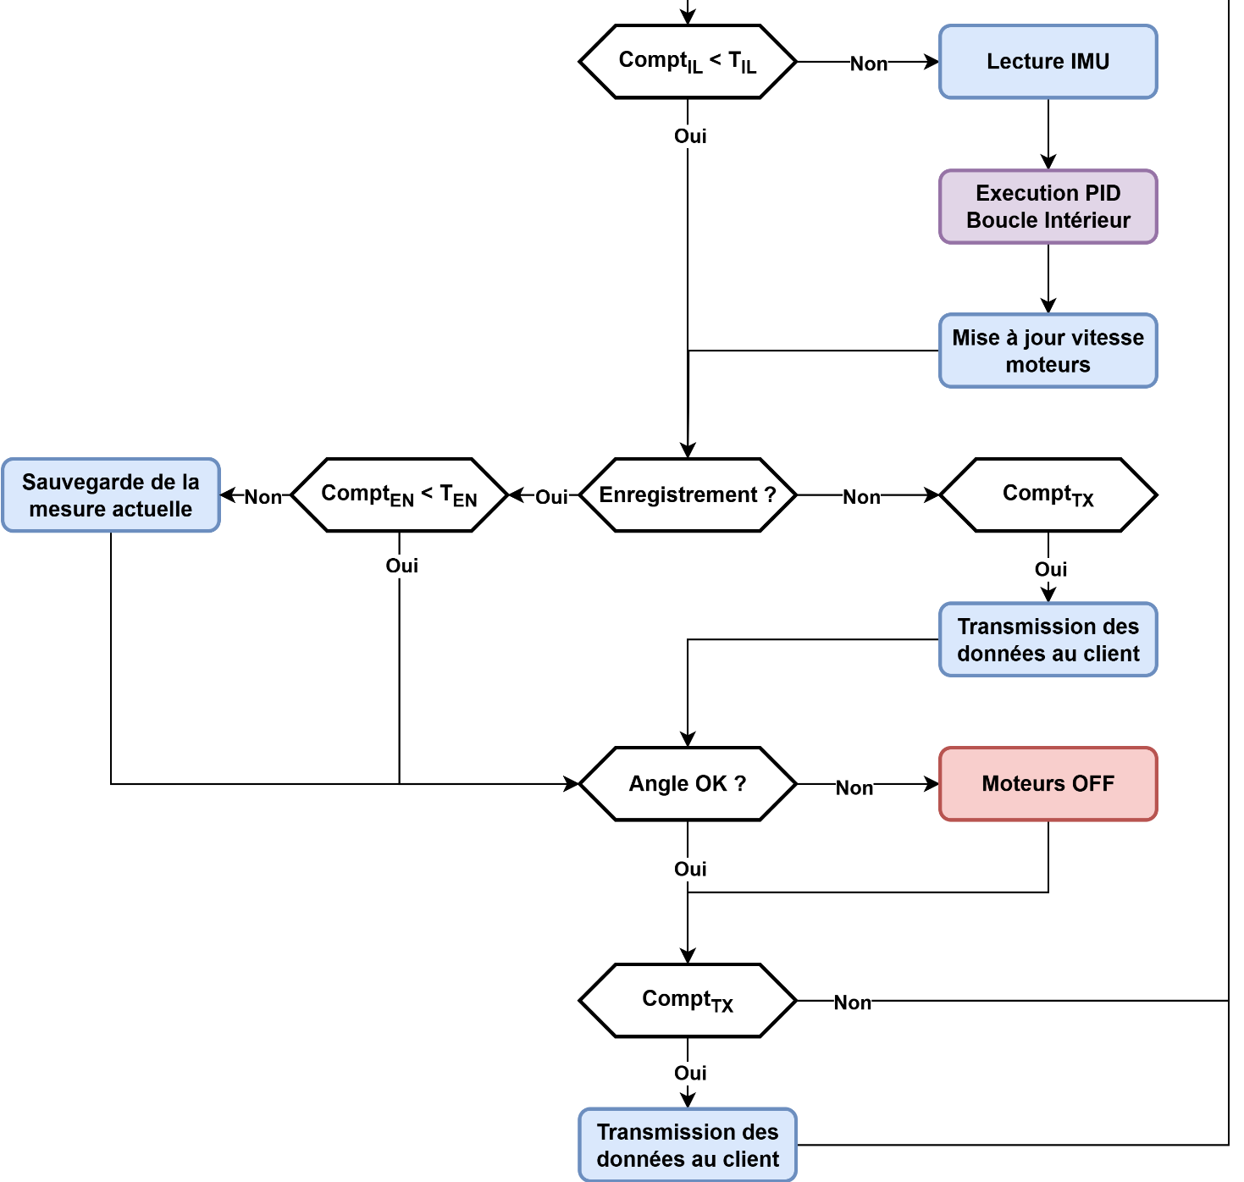
[picture p30: figure]
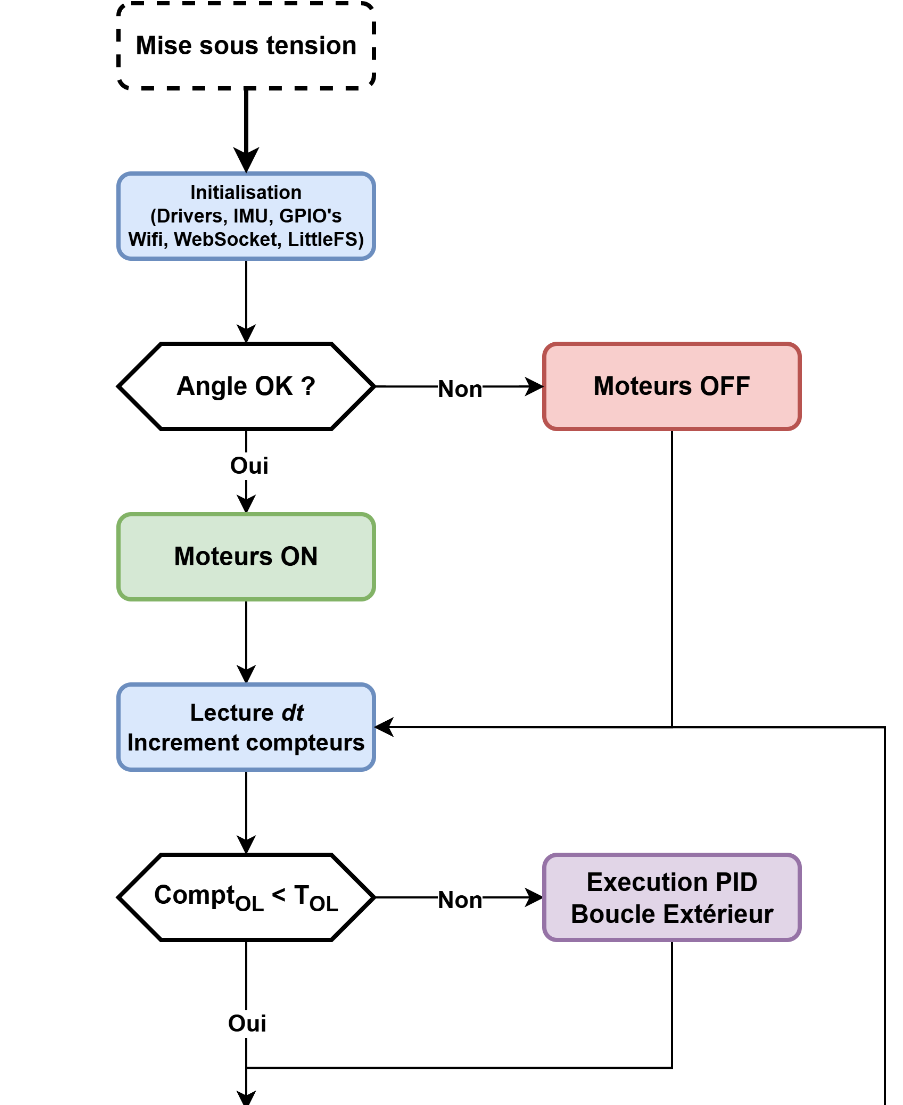
[picture p31: figure]

## Programmation Commandes

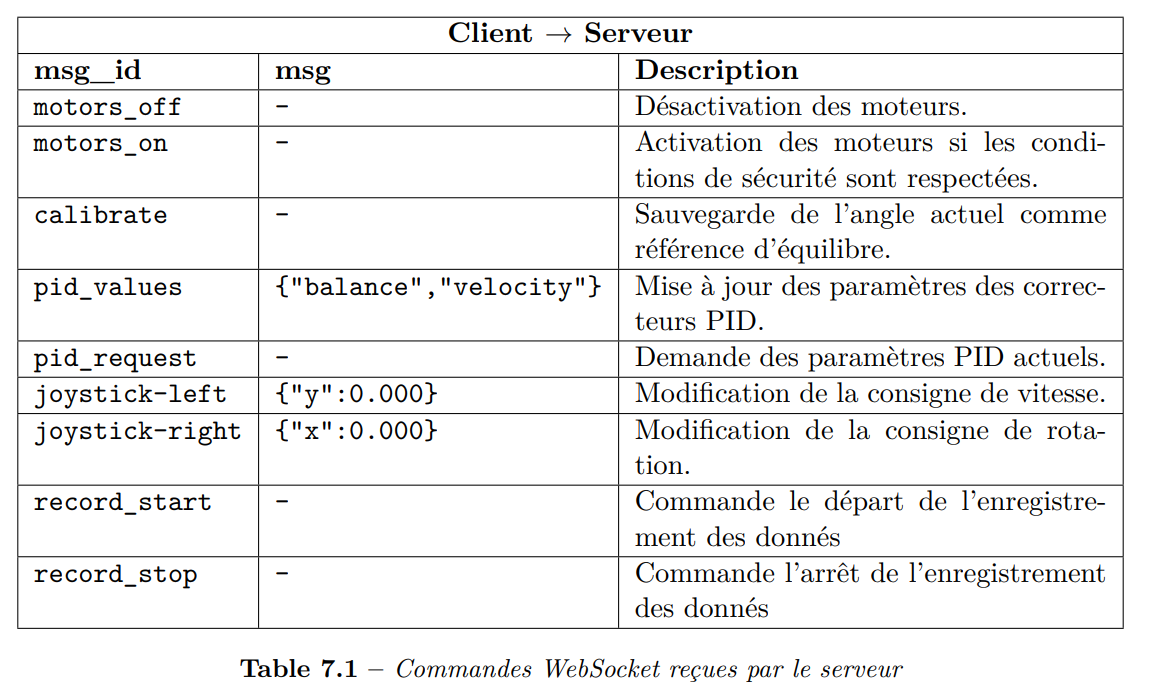
[picture p32: figure]

## Programmation Commandes

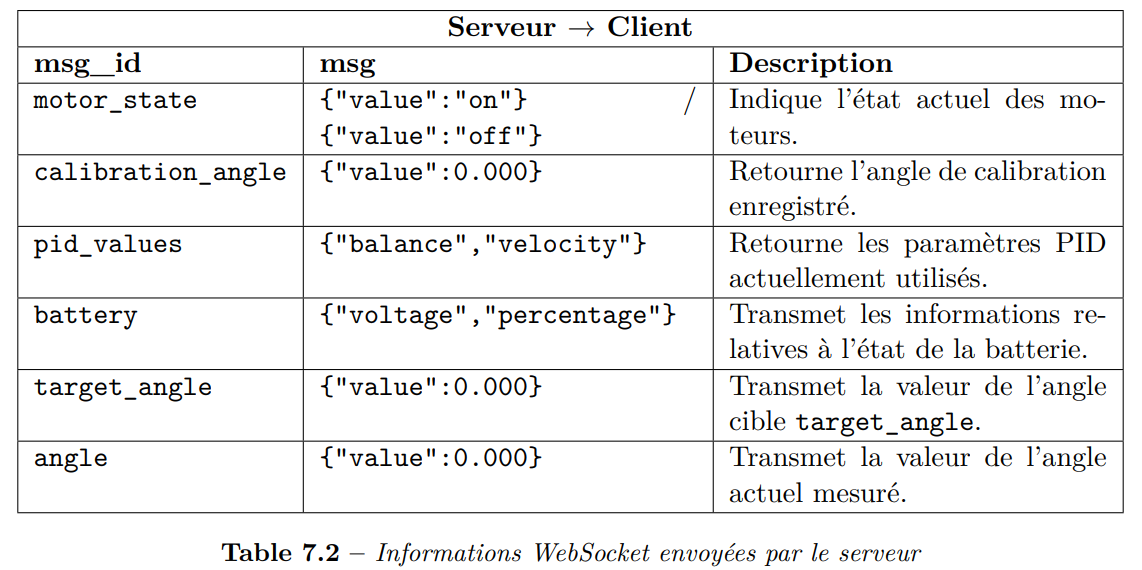
[picture p33: figure]

## Interface de contrôle

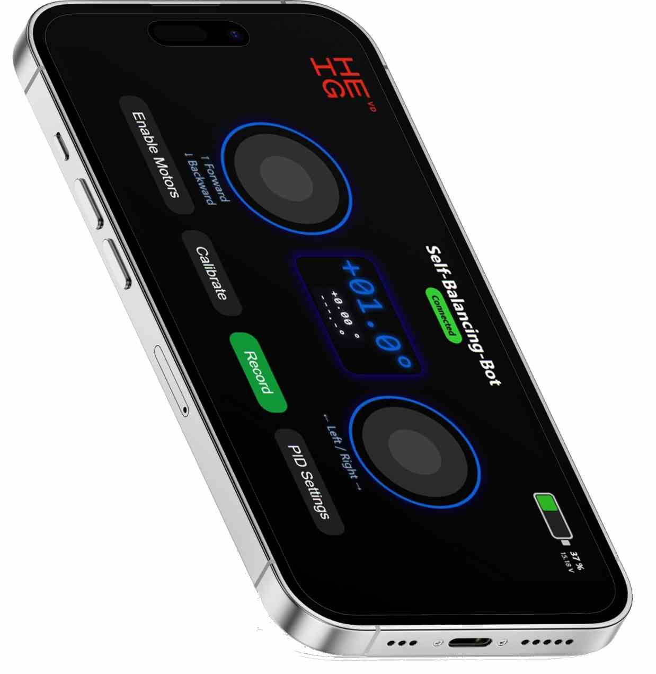
[picture p34: figure]

Progressive Web App
JS, HTML, CSS
WebSocket

## Interface de contrôle Joysticks

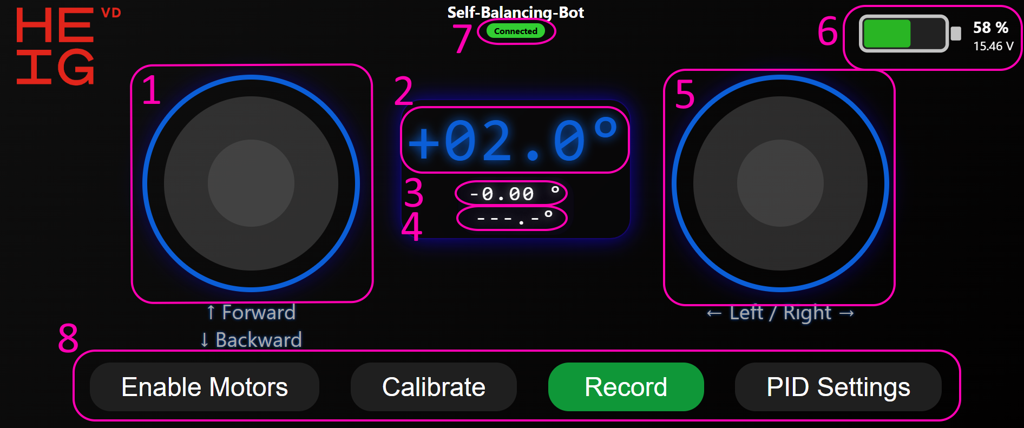
[picture p35: figure]

## Interface de contrôle Réglages PID

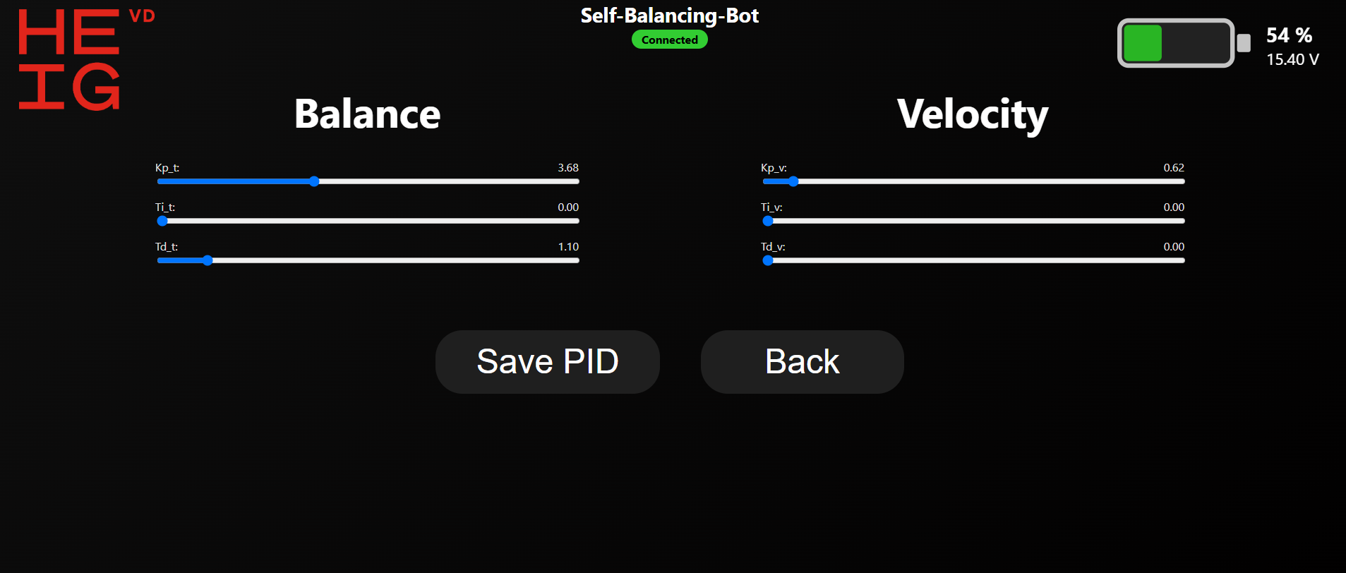
[picture p36: figure]

## Simulation Hypothèses

- Couple continu
- Aucun frottement
- Rigidité parfaite du chassis
- Adhérence parfaite au sol

## Simulation Complet

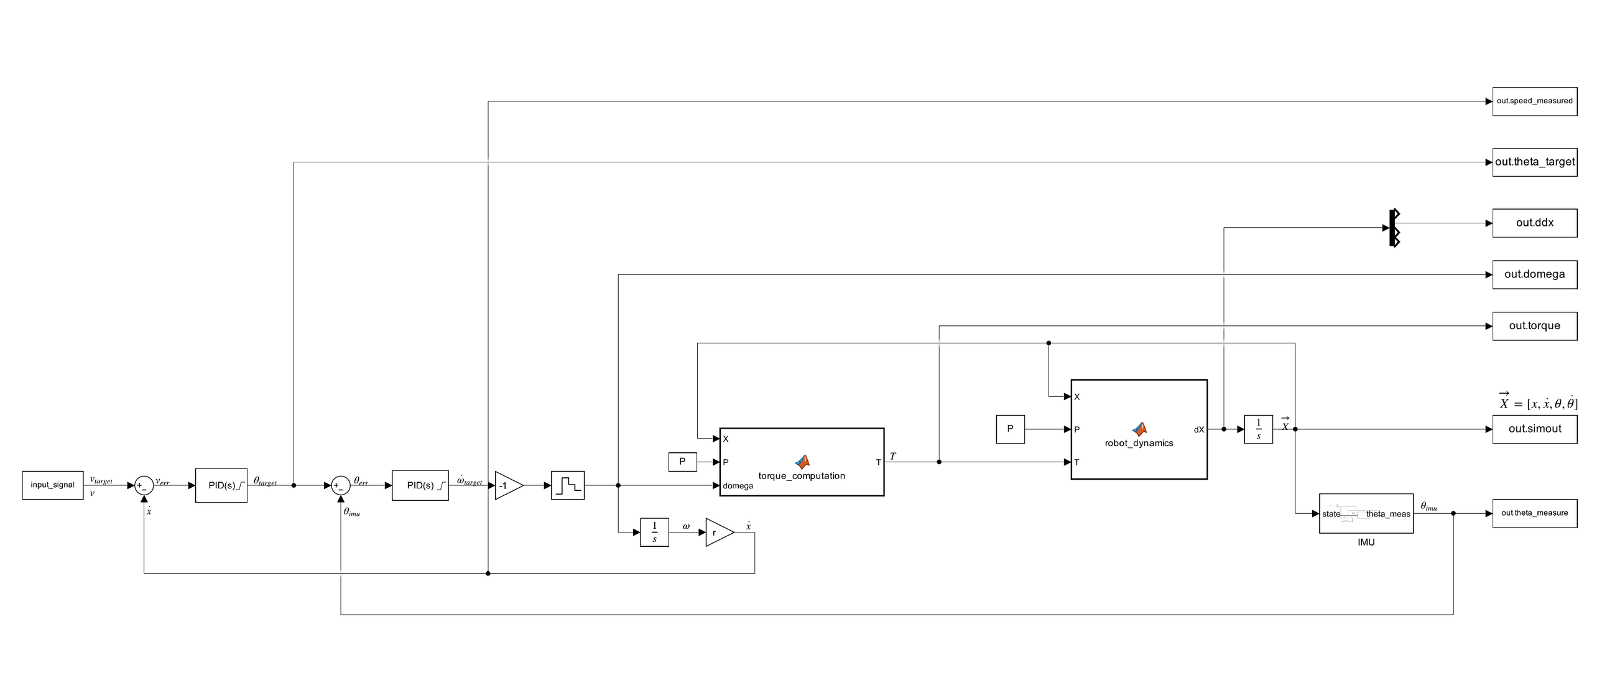
[picture p37: figure]

## Simulation Consigne

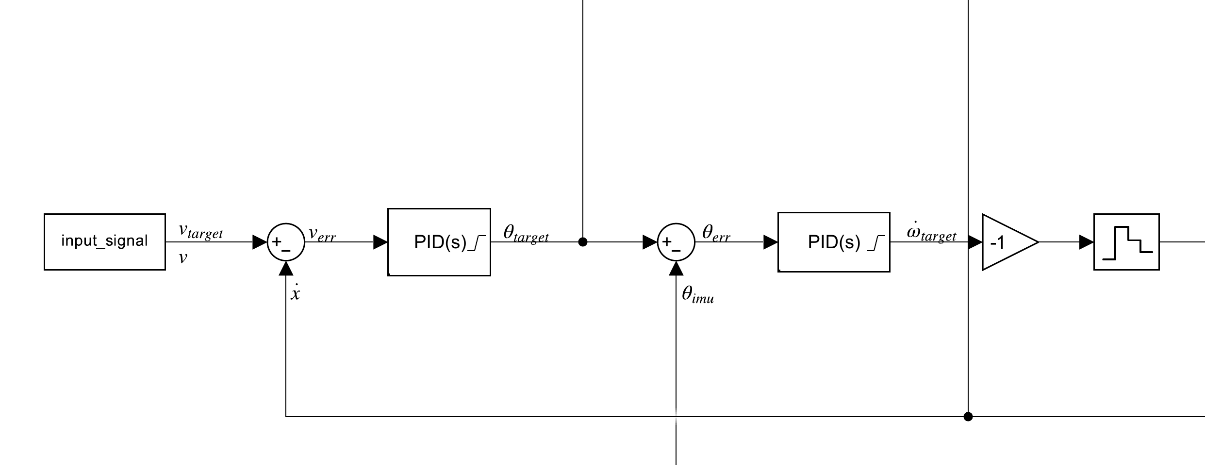
[picture p38: figure]

## Simulation Complet

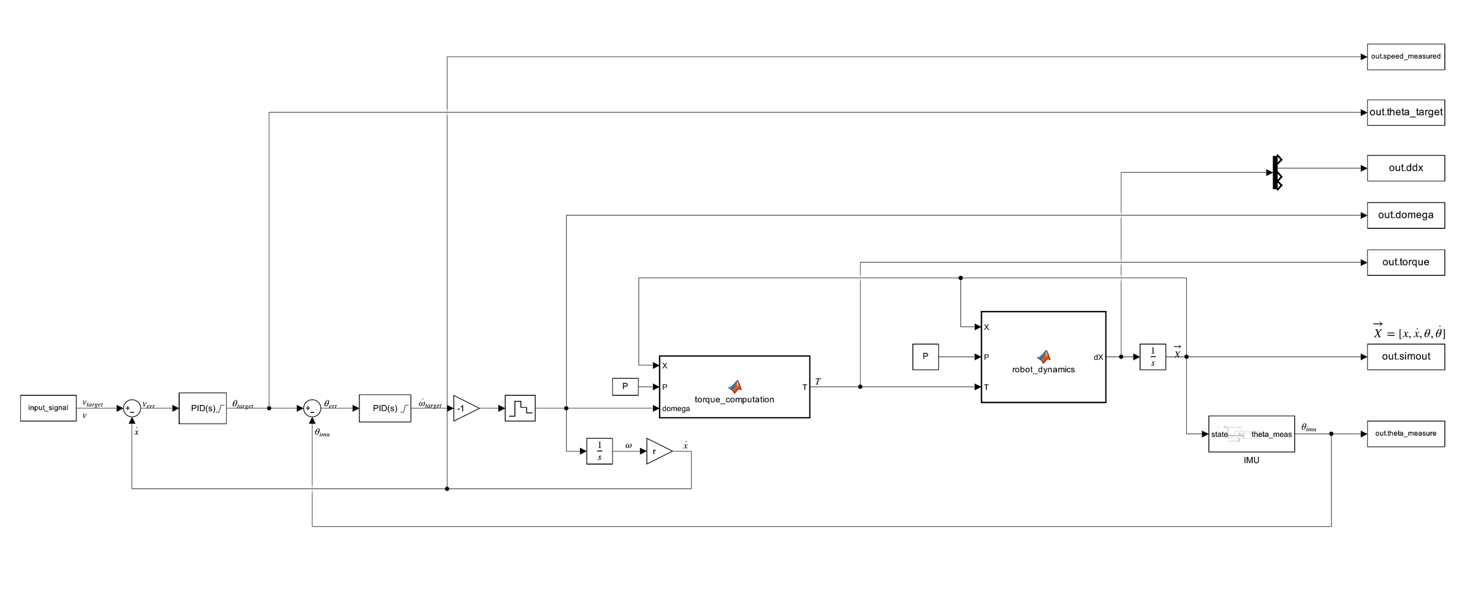
[picture p39: figure]

## Simulation Couple + Système à régler

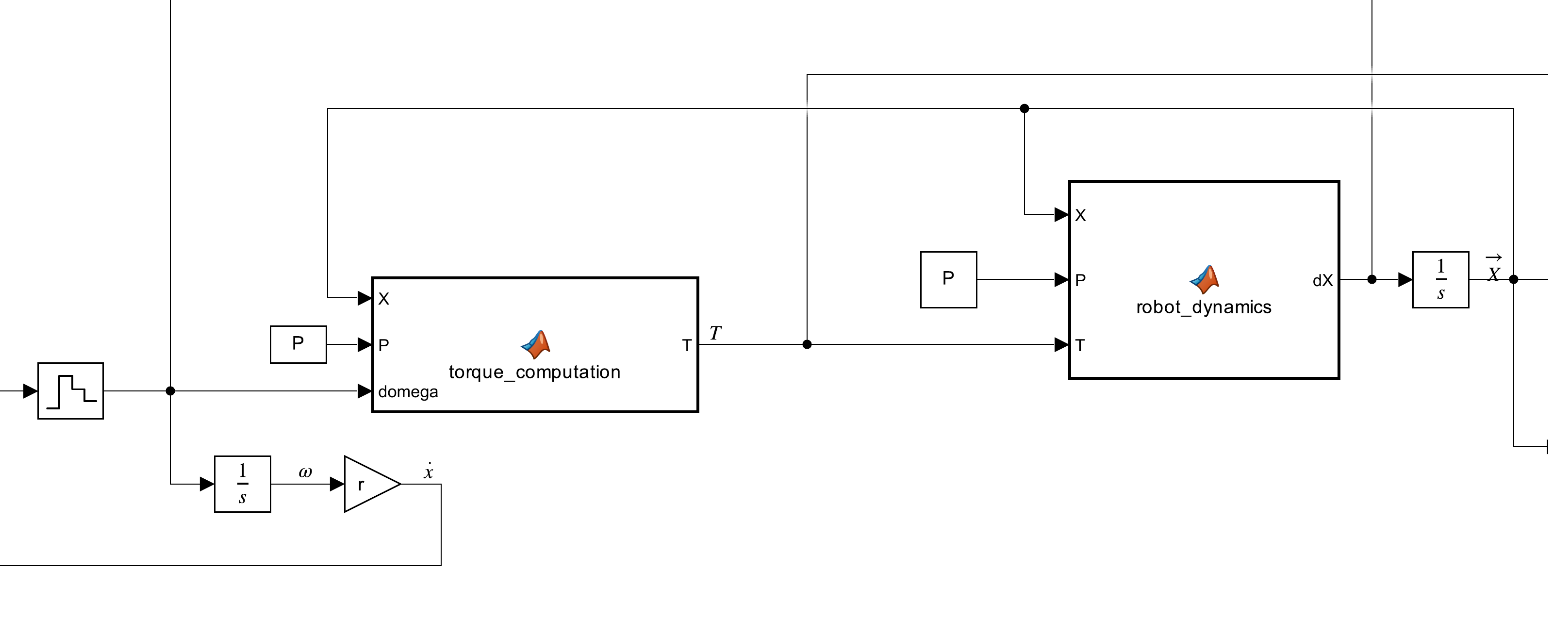
[picture p40: figure]

## Simulation Complet

## Simulation Modélisation IMU

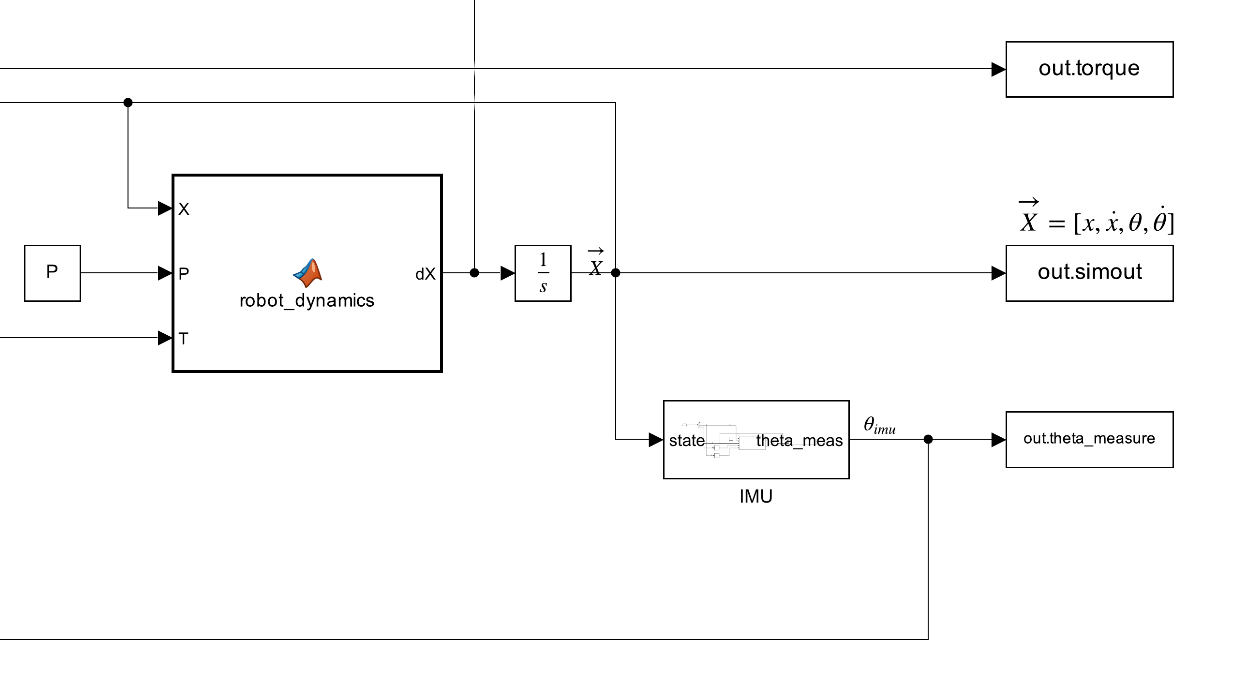
[picture p41: figure]

## Simulation Modélisation IMU

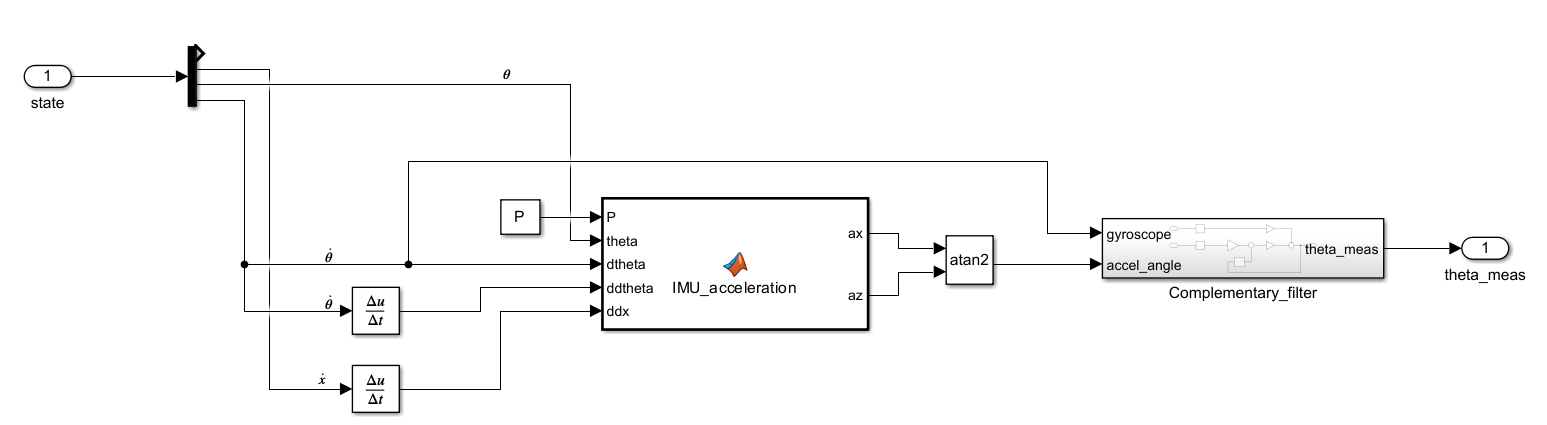
[picture p42: figure]

## Mesures Maintient

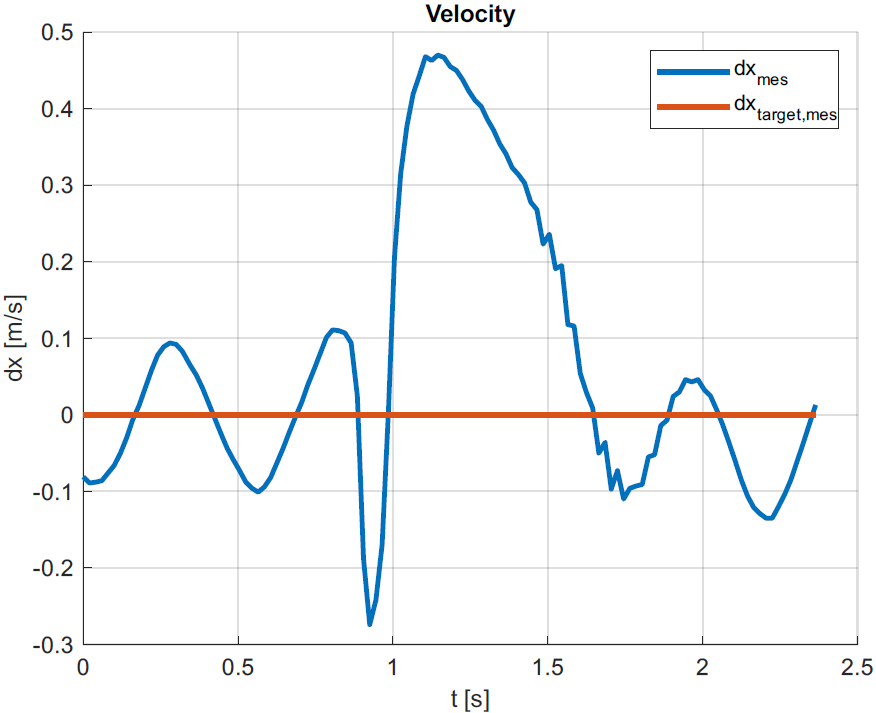
[picture p43: figure]
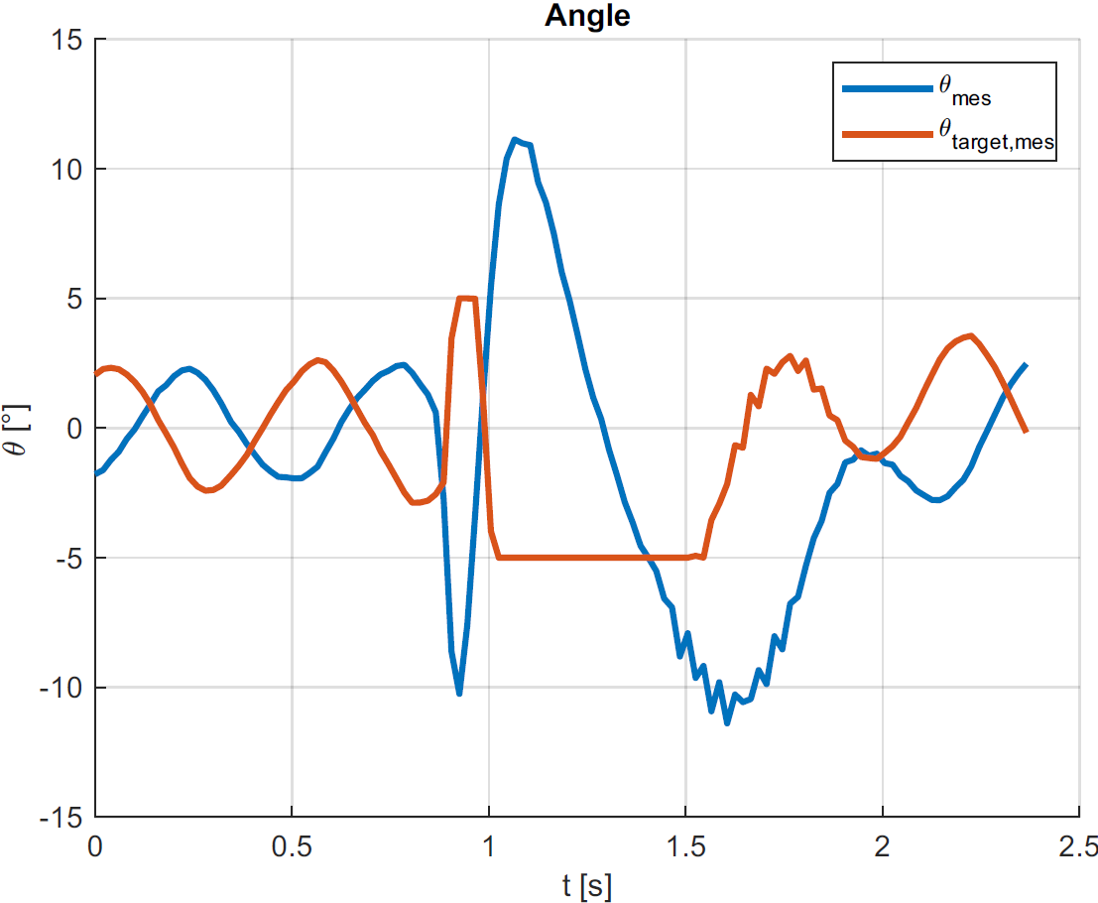
[picture p44: figure]

## Mesures Types de roues

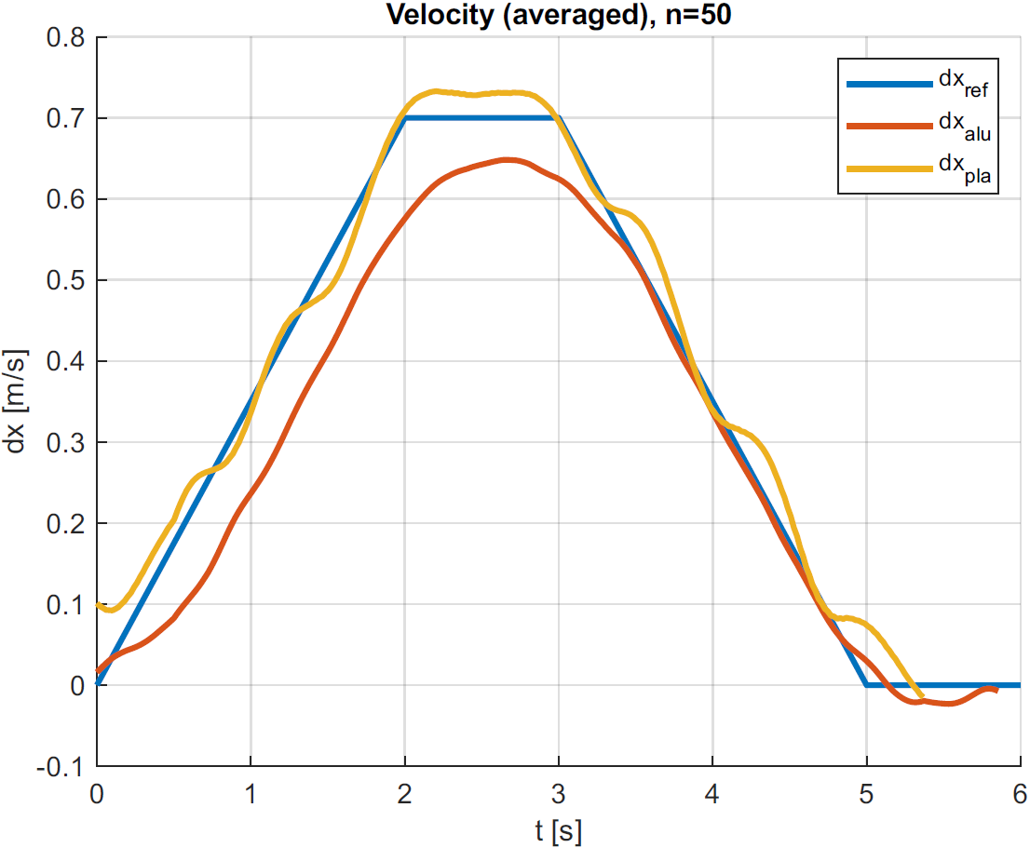
[picture p45: figure]
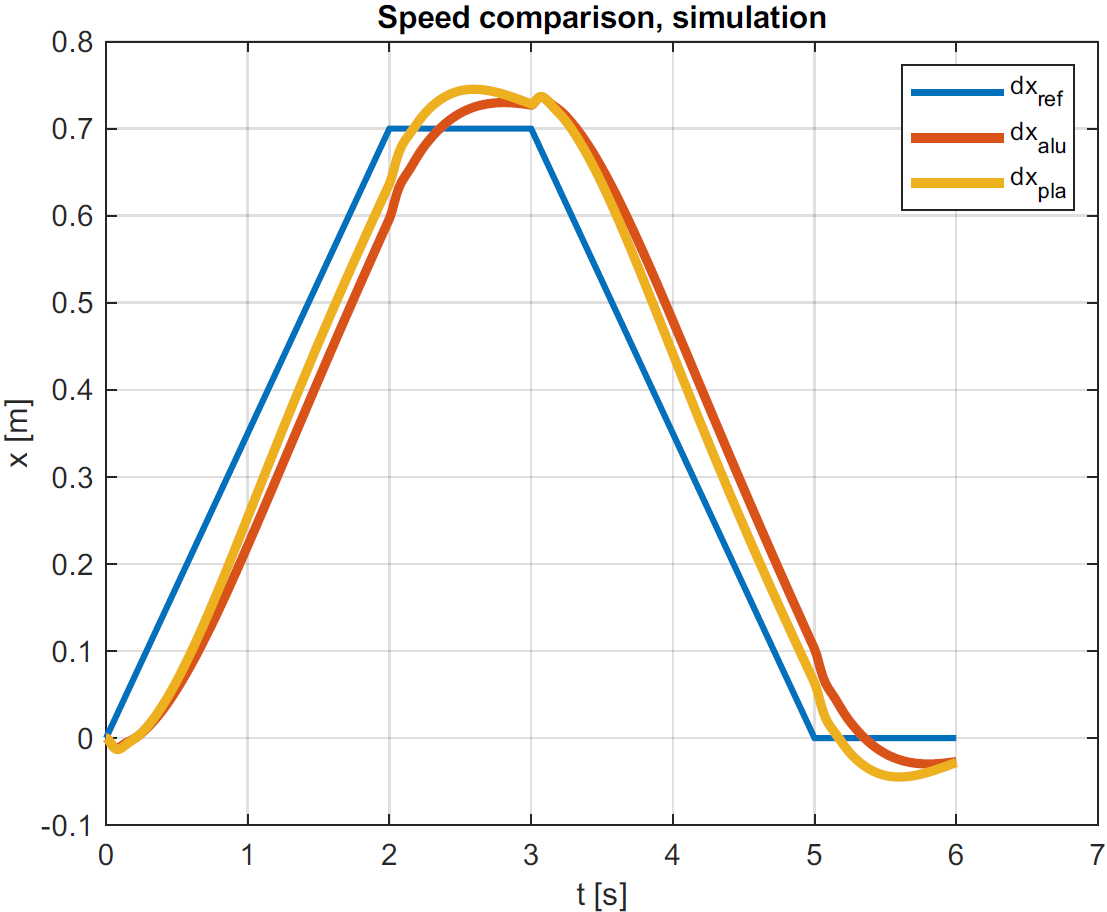
[picture p46: figure]

## Mesures Valeurs limites

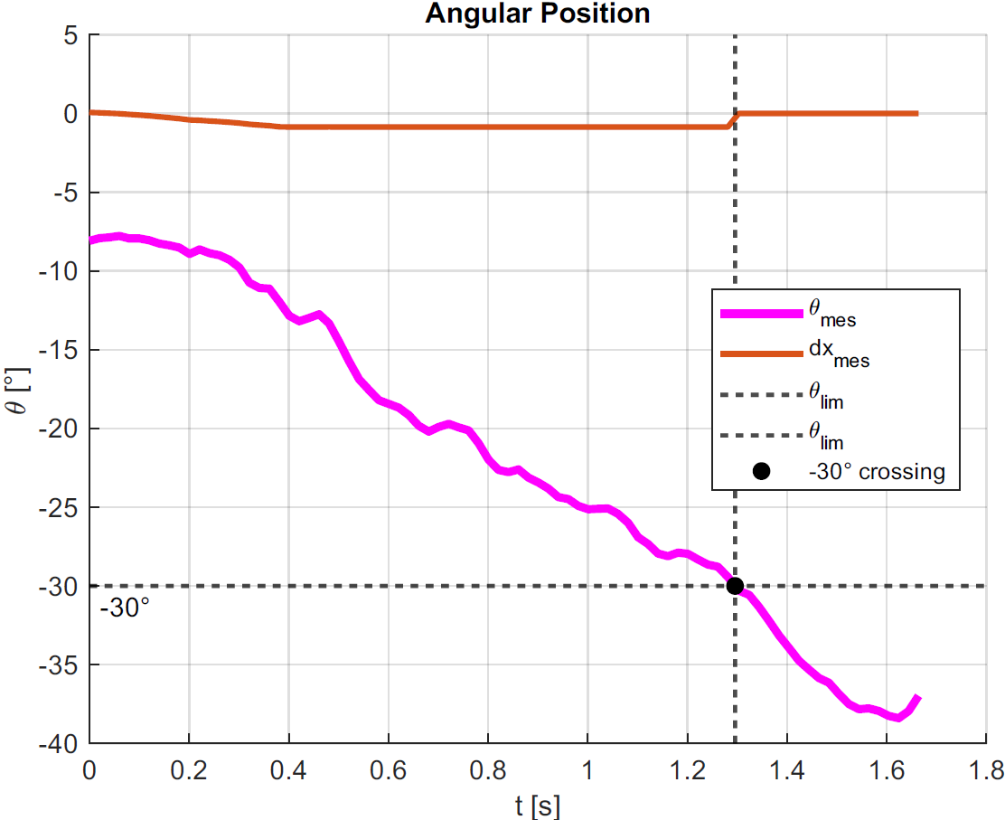
[picture p47: figure]
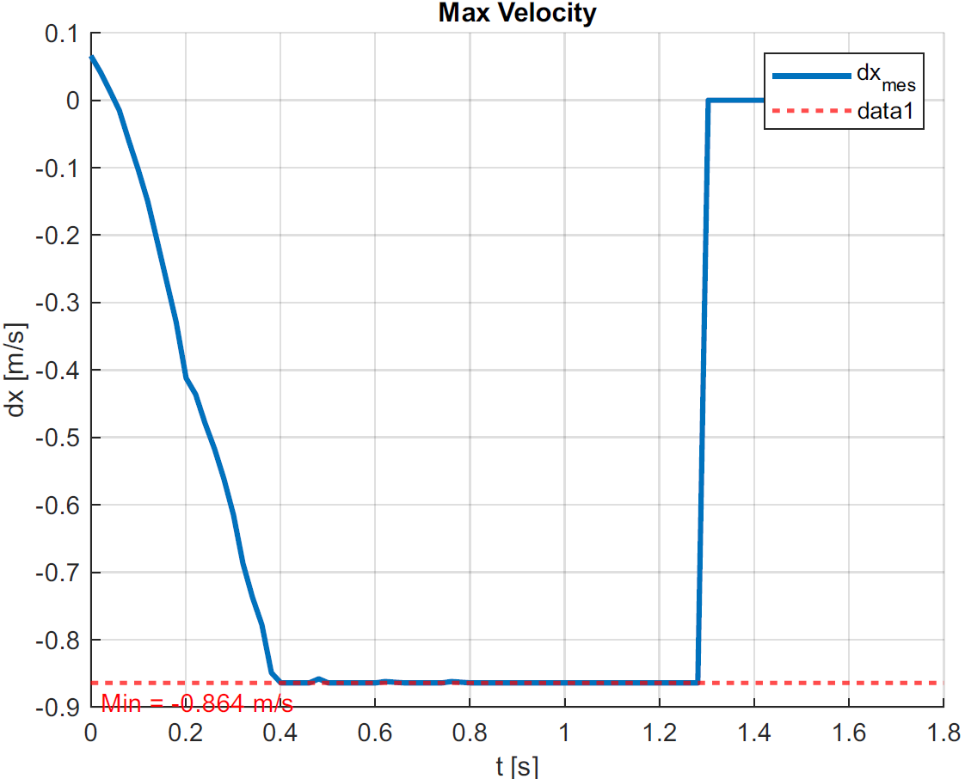
[picture p48: figure]

## Conclusion Résultats justifiés

- Vitesse maximale
- Roues PLA, ALU
- Valeurs limites
- Chute libre
- Impact de l’IMU

## Conclusion Améliorations possibles

- Déplacement autonome (capteurs)
- Couple adaptif des moteurs pas à pas
- Régulation LQR
