Ding-Jeremy/Self-Balancing-Bot/A_Documentation/Rapport/assets/figures/graphs/hold_negative_speed.pdf

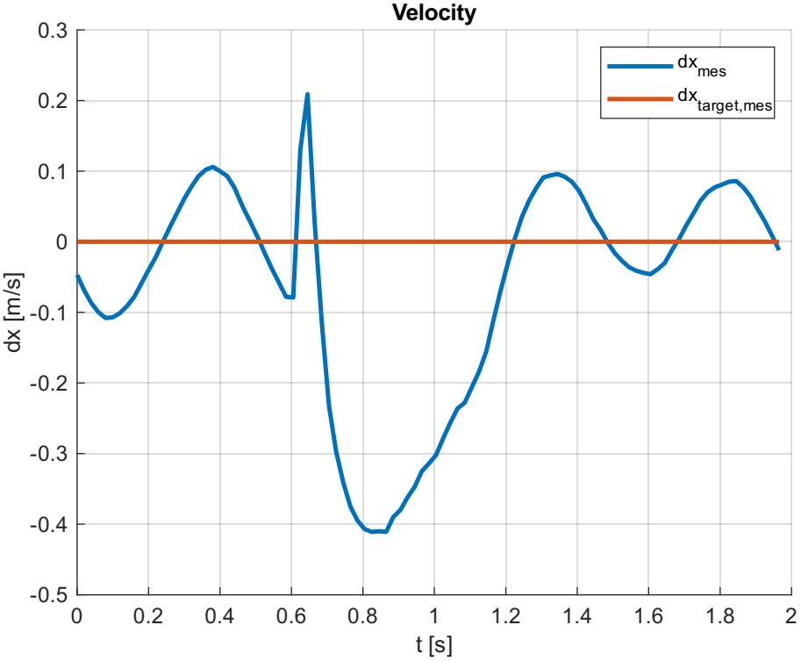
[picture p49: figure]
Velocity; dxmes dx; target,mes
