Ding-Jeremy/Self-Balancing-Bot/A_Documentation/Rapport/assets/figures/graphs/max_speed.pdf

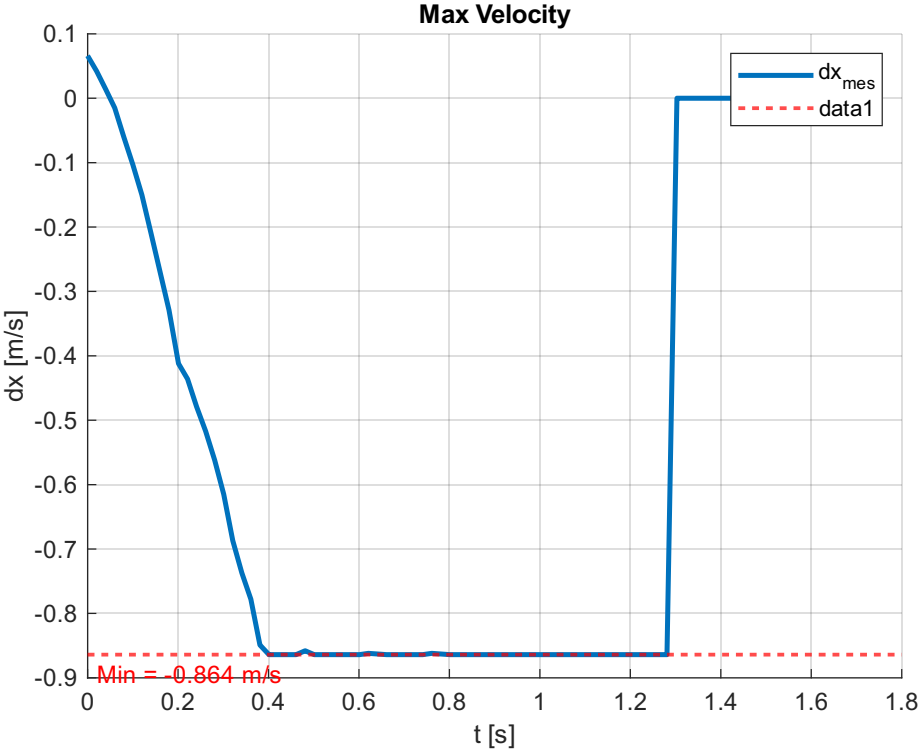
[picture p50: figure]
Max Velocity; Min = -0.864 m/s; dxmes data1
