Ding-Jeremy/Self-Balancing-Bot/A_Documentation/Rapport/meta.tex

% Auteur du document (étudiant-e) en projet de Bachelor
\author{Ding Jérémy}

% Activer l'option pour l'accord du féminin dans le texte
\genre{male}

% Titre de votre travail de Bachelor
\title{Self-Balancing-Bot}

% Le sous titre est optionnel
\subtitle{Travail de Bachelor}

% Nom du professeur responsable
\teacher {Prof. Girardin Michel(HEIG-VD)}

% Mettre à jour avec la date de rendu du travail
\date{\today}

% Numéro de TB
\thesis{1234}
