Ding-Jeremy/Self-Balancing-Bot/A_Documentation/Rapport/content/introduction.tex

\section{Introduction}

\begin{figure}[H]
    \centering
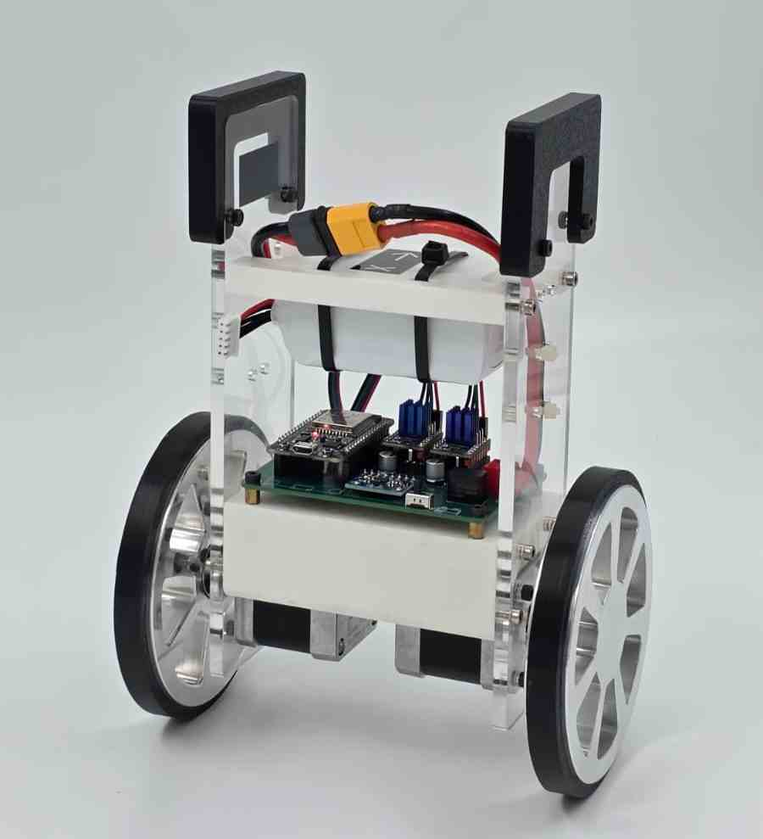
[picture p51: A_Documentation/Rapport/assets/figures/maquette_reelle_2.jpg]
    
    \caption{Maquette réelle}
    \label{fig:maquette}
\end{figure}

Les robots mobiles auto-équilibrés constituent une catégorie de systèmes robotiques particulièrement intéressante en raison de leur comportement intrinsèquement instable. Leur fonctionnement nécessite une interaction étroite entre plusieurs domaines de l'ingénierie, notamment la mécanique, l'électronique embarquée, l'informatique et la théorie du contrôle. Le robot à deux roues auto-balancé représente ainsi un cas d'étude pertinent pour l'application de concepts fondamentaux liés aux systèmes dynamiques et aux techniques de régulation.

Ce travail de Bachelor porte sur la conception, la réalisation et la validation expérimentale d'un prototype de robot à deux roues capable de maintenir son équilibre de manière autonome. L'objectif principal est de développer un système embarqué complet intégrant une structure mécanique, une architecture électronique, des capteurs, des actionneurs et une stratégie de commande permettant de stabiliser le robot en temps réel.

La problématique centrale de ce projet repose sur la stabilisation d'un système assimilable à un pendule inversé, dont l'équilibre doit être assuré par une action corrective permanente des moteurs. Afin de répondre à cette contrainte, une architecture matérielle basée sur des moteurs pas à pas, une unité inertielle de mesure et un microcontrôleur embarqué a été conçue. Le système de commande exploite les informations d'inclinaison mesurées par le capteurs afin d'ajuster dynamiquement l'actionnement des moteurs.

Ce rapport présente les différentes étapes de développement du robot, allant de la conception mécanique et du choix des composants jusqu'à la modélisation du système, l'implémentation de la régulation et la validation expérimentale. Une attention particulière est portée à la comparaison entre les résultats théoriques, issus des modèles développés, et les performances réellement obtenues avec le prototype.

Au travers de ce projet, les principaux défis liés au développement d'un système robotique autonome sont étudiés, notamment les compromis entre performances, complexité, consommation énergétique et robustesse de la régulation.

\section{Contexte}

Dans le cadre de leur formation en ingénierie, les étudiants sont amenés à réaliser un travail de Bachelor permettant de mettre en pratique les connaissances acquises durant leur cursus. Ce projet constitue une démarche complète de développement, comprenant l'identification d'un besoin, l'analyse des contraintes, la conception d'une solution, ainsi que sa réalisation et son évaluation expérimentale.

Dans ce contexte, le choix d'un robot mobile auto-équilibré comme sujet d'étude permet d'aborder plusieurs problématiques représentatives de l'ingénierie moderne. En effet, un tel système impose de combiner la conception mécanique d'une plateforme mobile, l'intégration d'une électronique embarquée, l'acquisition de données issues de capteurs et le développement d'algorithmes de commande capables de gérer un comportement instable.

Ce projet s'inscrit donc dans une démarche d'apprentissage appliqué visant à développer une vision globale de la conception d'un système mécatronique. Il offre l'occasion d'étudier les interactions entre les différents sous-systèmes et de mettre en évidence l'importance des choix techniques réalisés lors des différentes phases de développement.

La réalisation de ce prototype permet ainsi de mobiliser et de synthétiser plusieurs domaines abordés durant la formation, tout en confrontant les modèles théoriques aux contraintes pratiques rencontrées lors de la mise en œuvre d'un système réel.
\section{Enoncé}
Enoncé tel qu'inscrit sur GAPS.
\begin{itemize}
    \item Élaboration du cahier des charges et définition des spécifications.
    \item Conception et réalisation du robot.
    \item Fabrication d'un circuit imprimé intégrant l'interface de commande ainsi que les différents capteurs nécessaires à la régulation.
    \item Développement et programmation des régulateurs.
    \item Développement d'une télécommande pour la gestion des trajectoires.
    \item Ajustement des paramètres de contrôle afin d'optimiser les performances lors des déplacements.
\end{itemize}

\section{Cahier des charges}
Cahier des charges tel qu'inscrit sur GAPS.

\textbf{Conception}
\begin{itemize}
    \item Conception générale du robot.
    \item Définition des dimensions du système et choix des caractéristiques des roues.
    \item Sélection des composants principaux : moteurs, drivers, microcontrôleur, batterie, capteurs et moyens de communication.
\end{itemize}

\textbf{Analyse théorique}
\begin{itemize}
    \item Modélisation du comportement dynamique du système.
    \item Simulation du comportement du robot.
    \item Définition de l'architecture de commande et synthèse des régulateurs.
\end{itemize}

\textbf{Réalisation}
\begin{itemize}
    \item Conception et fabrication d'un circuit imprimé (PCB).
    \item Assemblage mécanique et intégration des composants électroniques.
\end{itemize}

\textbf{Programmation}
\begin{itemize}
    \item Interfaçage des capteurs et des drivers moteurs.
    \item Développement d'une interface embarquée pour la télécommande.
    \item Implémentation des algorithmes de régulation.
    \item Réalisation des essais, ajustement des paramètres et amélioration des performances.
\end{itemize}

Des critères supplémentaires ont été ajoutés au cahier des charges initial afin de préciser les contraintes de fonctionnement du système. Ces exigences concernent principalement l'autonomie énergétique et l'encombrement maximal du robot :

\begin{itemize}
    \item Une autonomie minimale de \SI{30}{min} en fonctionnement normal ;
    \item Une hauteur maximale du robot limitée à \SI{30}{cm}.
\end{itemize}
