Ding-Jeremy/Self-Balancing-Bot/A_Documentation/Rapport/content/modelisation.tex

Les caractéristiques mécaniques du châssis connus, il est à présent possible de modéliser le système en utilisant les équations vues dans le chapitre \ref{chap:principe_physique}.
La totalité des fichiers Matlab se trouvent également en annexe \ref{annexe:git} ainsi que sur le git \ref{annexe:git}.

\section{Méthode et outils}
Les outils principaux utilisés dans le but de créer, de simuler ce système sont: Matlab, Simulink.
\section{Système à régler}

Cette section a pour objectif de définir le système à régler ainsi que les éléments influençant son comportement dynamique.
Comme présenté au chapitre \ref{chap:principe_physique}, les équations \ref{eq:ddtheta} et \ref{eq:ddx} décrivent le comportement physique du système.

Il existe cependant des différence avec la réalité qu'il est important d'expliquer.

\subsection{Moteur pas à pas}

Les équations de mouvement régissant le système utilisent comme paramètre d'entrée le couple moteur. Or, le système réel étant équipé de moteurs pas à pas, le couple produit n'est pas naturellement continu. Toutefois, l'utilisation d'un réglage en micro-pas fin ainsi que d'un lissage (voir \ref{subsection:drivers_moteurs}) permet d'obtenir un comportement proche d'un actionneur continu. Le moteur est donc modélisé par un couple continu afin de simplifier l'étude et la synthèse du régulateur.
\subsection{Modélisation de l'\acrshort{imu}}

Afin de reproduire fidèlement le comportement du robot réel, le modèle intègre une représentation simplifiée de l'\acrshort{imu}. Celle-ci ne se limite pas à la mesure de l'angle d'inclinaison, mais prend également en compte les caractéristiques physiques du capteur ainsi que son traitement numérique interne.

La modélisation repose sur trois éléments principaux :
\begin{itemize}
\item la position de l'\acrshort{imu} par rapport à l'axe de rotation des roues ;
\item la modélisation des mesures de l'accéléromètre et du gyroscope ;
\item le filtrage numérique permettant l'estimation de l'angle.
\end{itemize}

\subsubsection{Position de l'\acrshort{imu}}
\label{subsubsection:position_imu}

L'\acrshort{imu} est située à une distance $\rho$ de l'axe de rotation des roues. Sa position dans le repère du robot est définie par

\begin{equation}
\mathbf{r}=
\begin{bmatrix}
r_x\\
r_z
\end{bmatrix}
=
\begin{bmatrix}
\rho\sin\phi\\
\rho\cos\phi
\end{bmatrix}.
\end{equation}

L'accélération d'un point appartenant à un solide en rotation est donnée par

\begin{equation}
\mathbf{a}_{\mathrm{rot}}
=
\dot{\boldsymbol{\omega}}\times\mathbf{r}
+
\boldsymbol{\omega}\times
(\boldsymbol{\omega}\times\mathbf{r}),
\end{equation}

où

\begin{equation}
\boldsymbol{\omega}
=
\begin{bmatrix}
0\\
\dot{\theta}\\
0
\end{bmatrix},
\qquad
\dot{\boldsymbol{\omega}}
=
\begin{bmatrix}
0\\
\ddot{\theta}\\
0
\end{bmatrix}.
\end{equation}

Les deux termes correspondent respectivement à l'accélération tangentielle et à l'accélération centripète.

L'accélération tangentielle vaut

\begin{equation}
\mathbf{a}_{\mathrm{tan}}
=
\begin{bmatrix}
\ddot{\theta}\,r_z\\
-\ddot{\theta}\,r_x
\end{bmatrix},
\end{equation}

tandis que l'accélération centripète est

\begin{equation}
\mathbf{a}_{\mathrm{cen}}
=
\begin{bmatrix}
-\dot{\theta}^{2}r_x\\
-\dot{\theta}^{2}r_z
\end{bmatrix}.
\end{equation}

L'accélération de rotation appliquée à l'\acrshort{imu} est donc

\begin{equation}
\mathbf{a}_{\mathrm{rot}}
=
\mathbf{a}_{\mathrm{tan}}
+
\mathbf{a}_{\mathrm{cen}}.
\end{equation}

Le robot possède également une accélération longitudinale $\ddot{x}$. Cette accélération est exprimée dans le repère du capteur par

\begin{equation}
\mathbf{a}_{\mathrm{trans}}
=
\begin{bmatrix}
\ddot{x}\cos\theta\\
-\ddot{x}\sin\theta
\end{bmatrix}.
\end{equation}

Enfin, la gravité projetée dans le repère du capteur s'écrit

\begin{equation}
\mathbf{g}
=
\begin{bmatrix}
g\sin\theta\\
g\cos\theta
\end{bmatrix}.
\end{equation}

L'accélération mesurée par l'accéléromètre est alors

\begin{equation}
\mathbf{a}_{\mathrm{imu}}
=
\mathbf{a}_{\mathrm{trans}}
+
\mathbf{a}_{\mathrm{rot}}
+
\mathbf{g},
\end{equation}

ce qui conduit aux expressions suivantes :

\begin{align}
a_x &=
\ddot{x}\cos\theta
+\ddot{\theta}\,r_z
-\dot{\theta}^{2}r_x
+g\sin\theta,\\
a_z &=
-\ddot{x}\sin\theta
-\ddot{\theta}\,r_x
-\dot{\theta}^{2}r_z
+g\cos\theta.
\end{align}

\subsubsection{Modélisation du gyroscope}

Le gyroscope mesure directement la vitesse angulaire du robot autour de l'axe d'équilibrage. Dans le modèle, la mesure est supposée idéale et correspond directement à la vitesse angulaire issue du modèle dynamique :

$$
\omega = \dot{\theta}
$$

Les effets tels que le bruit de mesure ou la dérive du gyroscope ne sont pas pris en compte.

\subsubsection{Filtre complémentaire}

L'angle utilisé par le régulateur n'est pas directement issu de l'accéléromètre ou du gyroscope. Comme sur le robot réel, ces deux mesures sont fusionnées à l'aide d'un filtre complémentaire exécuté à une fréquence de 500~Hz, soit une période d'échantillonnage de $T_s = 2~\mathrm{ms}$.

À chaque période d'échantillonnage, la vitesse angulaire mesurée par le gyroscope est intégrée afin de prédire la nouvelle orientation du robot. Cette estimation est ensuite corrigée à l'aide de l'angle obtenu par l'accéléromètre selon la relation :
$$
\theta_{\mathrm{mes}}(k)
=
\alpha
\left(
\theta_{\mathrm{mes}}(k-1)
+
\omega(k)T_s
\right)
+
(1-\alpha)\theta_{\mathrm{acc}}(k)
$$

où $\alpha = 0.9$.

Ce filtre permet de combiner les avantages des deux capteurs : le gyroscope fournit une bonne estimation des variations rapides de l'orientation, tandis que l'accéléromètre permet de corriger la dérive du gyroscope à basse fréquence grâce à la mesure de la direction de la gravité.

\subsubsection{Intégration Matlab}

Le modèle de l'\acrshort{imu} ainsi que le filtre complémentaire sont ensuite implémentés dans Matlab/Simulink afin d'intégrer cette chaîne de mesure dans la simulation complète du robot.
\begin{figure}[H]
    \centering
    
    \caption{Modèle de l'\acrshort{imu} dans Simulink}
    \label{fig:imu_simulink}
\end{figure}

\begin{figure}[H]
    \centering
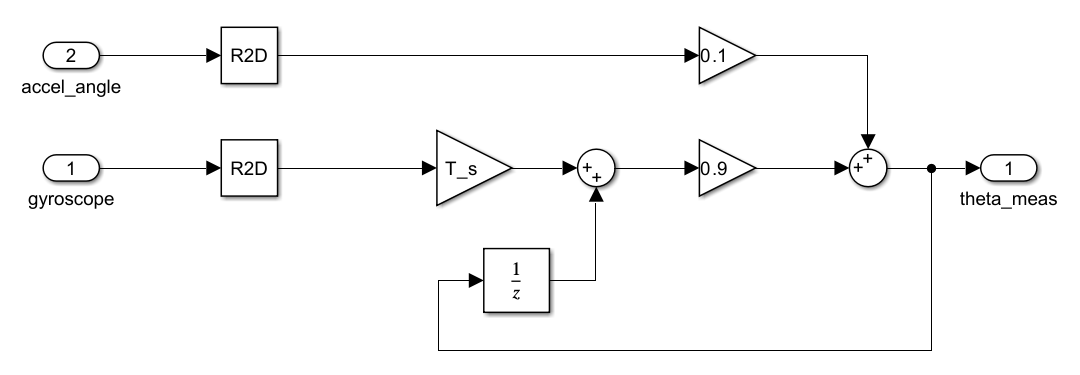
[picture p52: A_Documentation/Rapport/assets/figures/simulink_schematic/complementary_filter.png]
    
    \caption{Implémentation du filtre complémentaire dans Simulink}
    \label{fig:complementary_filter}
\end{figure}

\section{Régulation}
Le but ici est de déterminer la méthode de régulation la plus adaptée au système.

\subsection{Structure de régulation retenue}

Une structure de régulation en boucle imbriquée est retenue. En effet, comme le montre la figure \ref{fig:com}, la position du centre de masse influence directement l'angle d'équilibre de la maquette.

\begin{figure}[H]
    \centering
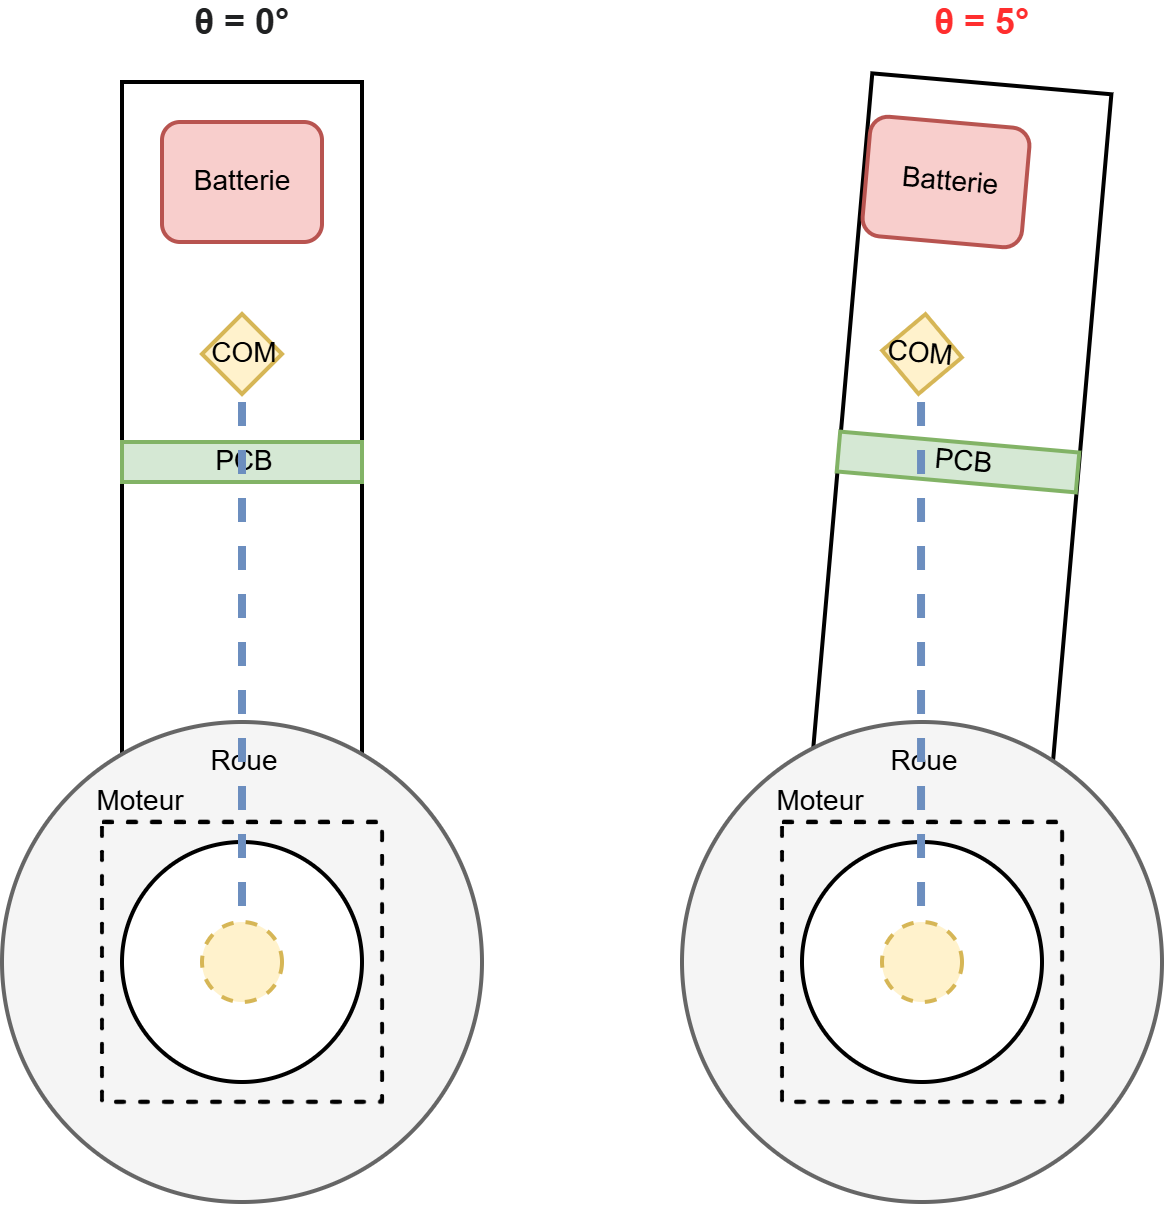
[picture p53: A_Documentation/Rapport/assets/schemas/center_of_mass.png]
    
    \caption{Influence du centre de masse sur l'angle d'équilibre.}
    \label{fig:com}
\end{figure}

En pratique, il est impossible de connaître avec précision cet angle d'équilibre. Supposons que celui-ci soit décalé de $5^\circ$ par rapport à la verticale.

Afin de maintenir cette inclinaison permanente, le régulateur d'angle doit générer un couple constant. Or, pour un robot de type pendule inversé, ce couple ne peut être obtenu qu'en déplaçant continuellement la base sous le centre de masse. Le système produit donc une accélération non nulle qui est maintenue tant que l'erreur d'angle subsiste. Cette accélération entraîne une augmentation continue de la vitesse, puis de la position, comme l'illustrent les figures \ref{fig:a_com_misalign} à \ref{fig:pos_com_misalign}. En d'autres termes, le robot accélère continuellement afin de conserver son équilibre autour d'un angle erroné, ce qui conduit inévitablement à une dérive de sa position.

\begin{figure}[H]
    \centering
    
    \caption{Accélération}
    \label{fig:a_com_misalign}
\end{figure}

\begin{figure}[H]
    \centering
    
    \caption{Vitesse}
    \label{fig:v_com_misalign}
\end{figure}

\begin{figure}[H]
    \centering
    
    \caption{Position}
    \label{fig:pos_com_misalign}
\end{figure}

Sur la base de la notion discutée ci-dessus, la stratégie de régulation retenue est une structure en cascade composée de deux boucles :

\begin{itemize}
    \item une boucle externe de régulation de vitesse, dont l'objectif est de contrôler la vitesse linéaire du châssis ;
    \item une boucle interne de régulation d'angle, dont l'objectif est de maintenir l'inclinaison du robot à la valeur demandée.
\end{itemize}

La boucle externe compare la vitesse linéaire mesurée du robot avec la consigne de vitesse :

$$
e_v = v_{\mathrm{ref}} - v
$$

Cette erreur est appliquée à un régulateur permettant de déterminer l'angle d'inclinaison souhaité :

$$
\theta_{\mathrm{ref}} = C_v(e_v)
$$

L'inclinaison demandée représente alors une consigne d'accélération indirecte. En effet, pour accélérer dans une direction donnée, le robot doit volontairement s'incliner afin de créer une composante du poids permettant de générer le mouvement.

La boucle interne compare ensuite l'angle désiré avec l'angle mesuré par l'\acrshort{imu} :

$$
e_{\theta} = \theta_{\mathrm{ref}}-\theta
$$

Le régulateur d'angle calcule l'accélération nécessaire des roues :

$$
a_{\mathrm{roues}} = C_{\theta}(e_{\theta})
$$

Cette accélération est ensuite intégrée et transmise sous forme de vitesse aux drivers moteurs.

La structure complète de commande est donc :

$$
v_{\mathrm{ref}}
\rightarrow
(v_{\mathrm{ref}}-v)
\rightarrow
\theta_{\mathrm{ref}}
\rightarrow
(\theta_{\mathrm{ref}}-\theta)
\rightarrow
a_{\mathrm{roues}}
\rightarrow
\text{moteurs pas à pas}
$$

Cette architecture présente l'avantage de découpler la dynamique de déplacement et la dynamique d'équilibrage. La boucle interne, plus rapide, garantit la stabilité du robot tandis que la boucle externe impose le comportement global en vitesse.
\subsection{Calcul du couple moteur équivalent}

Le modèle dynamique obtenu précédemment permet d'établir la relation entre le couple moteur appliqué aux roues et l'accélération du châssis. Bien que la commande réelle du robot soit réalisée en accélération par l'intermédiaire des moteurs pas à pas, le calcul du couple équivalent permet de vérifier la cohérence physique de la commande.

L'équation dynamique selon l'axe horizontal est donnée par :

\[
\ddot{x} =
\frac{1}{d_1}
\left(
aI_O\dot{\theta}^2\sin(\theta)
-
a^2g\sin(\theta)\cos(\theta)
+
T
\left(
\frac{I_O}{r}+a\cos(\theta)
\right)
\right)
\]

avec :

\[
d_1=I_Om_O-a^2\cos^2(\theta)
\]

Le couple moteur peut être obtenu en isolant le terme associé à l'actionneur :

\[
T=
\frac{
d_1\ddot{x}
-
aI_O\dot{\theta}^2\sin(\theta)
+
a^2g\sin(\theta)\cos(\theta)
}
{
\frac{I_O}{r}+a\cos(\theta)
}
\]

\subsection{Intégration Matlab}

La figure \ref{fig:input_simulink} montre l'intégration des deux régulateurs imbriqués. Il s'agit ici de régulateurs analogique saturés. Les valeurs de saturations
restent à définir.
Ces derniers sont également paramétrés avec un anti-windup.
On y voit également l'intégration du signal d'entré principal, ici $v_{target}$ soit la consigne de vitesse.

A la sortie de cette image, un bloc ZOH, (Zero Order Hold), permet de cadancer le système à la fréquene souhaitée (permettant un représentation fidèle de la réalité.)
Le signe négatif appliqué à la sortie du régulateur d'angle permet d'adapter la commande à la dynamique du pendule inversé. En effet, une correction de l'inclinaison nécessite un déplacement des roues dans la direction opposée au mouvement angulaire souhaité. Cette inversion assure donc la cohérence entre la consigne d'accélération des roues et le sens de réaction mécanique du robot.
\begin{figure}[H]
    \centering
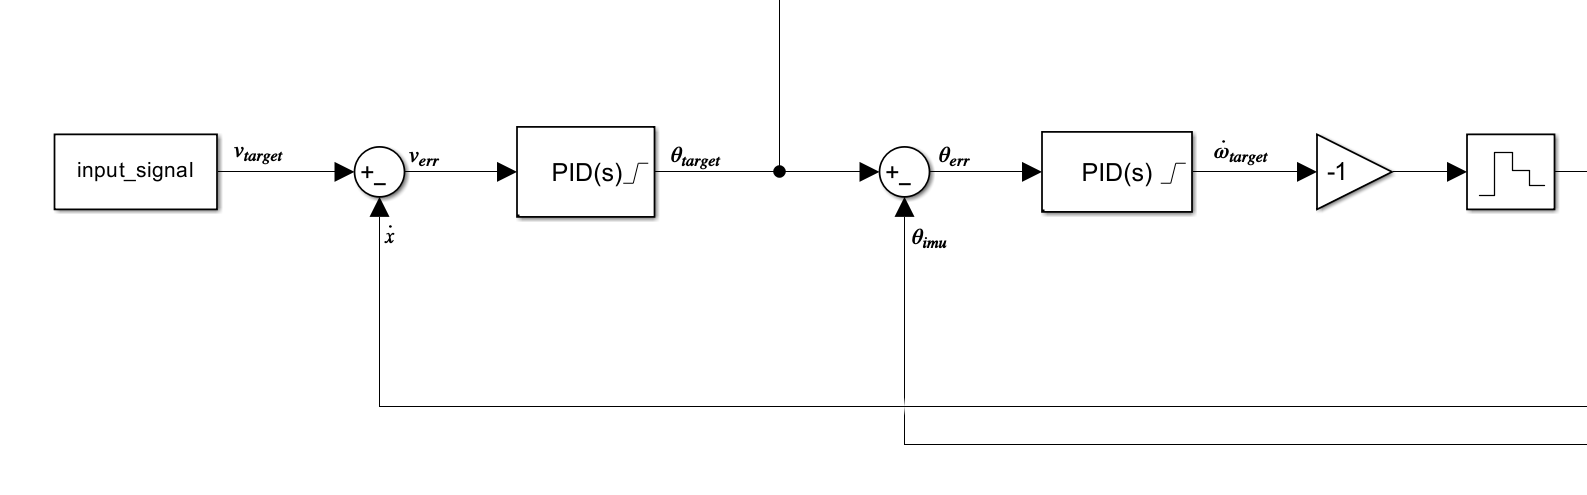
[picture p54: A_Documentation/Rapport/assets/figures/simulink_schematic/input.png]
    
    \caption{Modèle régulateurs PID}
    \label{fig:input_simulink}
\end{figure}

La figure \ref{fig:linear_speed} présente la lecture de la vitesse linéaire. Cette dernière est entièrement déterminée par la consigne de vitesse appliquée aux moteurs pas à pas. 
Il s'agit également d'une adaptation permettant de modéliser plus fidèlement le comportement du système réel.

Les valeurs obtenues par l'intégration de la consigne d'accélération sont identiques à celles obtenues à partir du modèle physique \texttt{robot\_dynamics}.
\begin{figure}[H]
    \centering
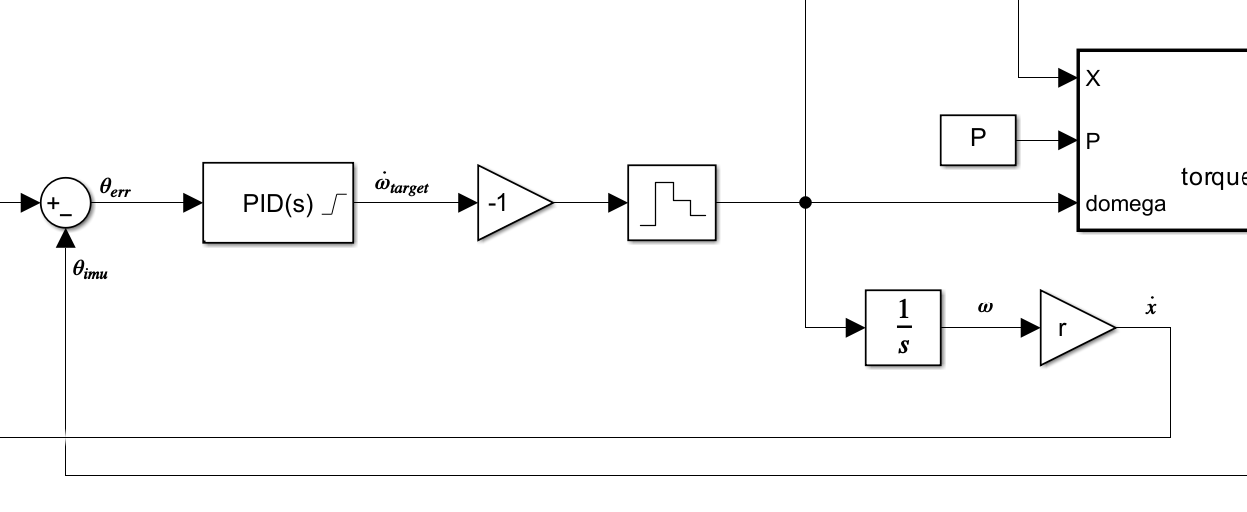
[picture p55: A_Documentation/Rapport/assets/figures/simulink_schematic/omega_reading.png]
    
    \caption{Lecture de vitesse linéaire}
    \label{fig:linear_speed}
\end{figure}

La figure \ref{fig:torque_physics} présente l'intégration des deux principaux blocs de calcul. Le premier, \texttt{torque\_computation}, permet de déterminer le couple à partir de l'accélération, tandis que le second, \texttt{robot\_dynamics}, intègre les équations du modèle physique présentées dans la section \ref{chap:principe_physique}.

Cette figure illustre également l'implémentation du bloc \acrshort{imu}, placé en sortie du calcul dynamique afin de simuler les mesures fournies par le capteur inertiel.
\begin{figure}[H]
    \centering
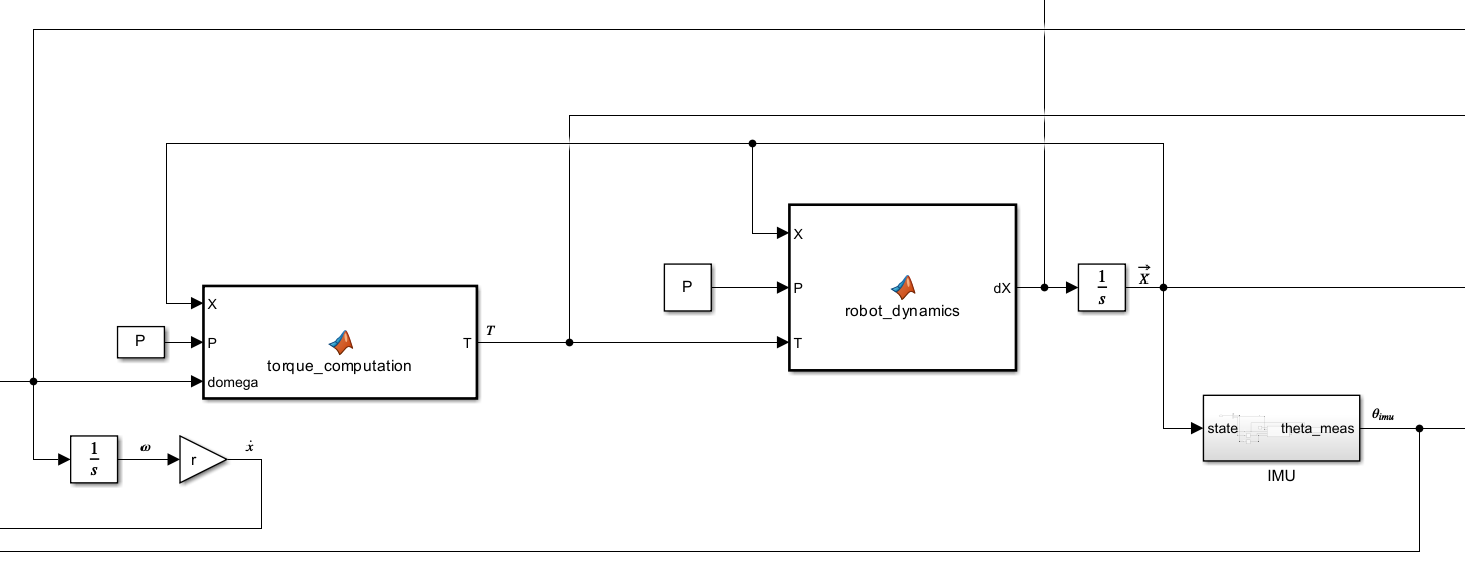
[picture p56: A_Documentation/Rapport/assets/figures/simulink_schematic/torque_physics.png]
    
    \caption{Blocs principaux de calcul}
    \label{fig:torque_physics}
\end{figure}

La constante \(P\) présente dans les figures ci-dessus représente un vecteur de paramètres. 
L'intégralité de ces paramètres se trouve dans le fichier \texttt{complete\_parameters.m}. 
Le vecteur \(\vec{X}\) correspond au vecteur d'état du système, défini par :

$$
\vec{X} =
\begin{bmatrix}
x \\
\dot{x} \\
\theta \\
\dot{\theta}
\end{bmatrix}
$$ 

où \(x\) représente la position linéaire, \(\dot{x}\) sa dérivée temporelle, \(\theta\) la position angulaire et \(\dot{\theta}\) la vitesse angulaire.

\subsection{Synthèse des paramètres des régulateurs}

L'objectif de cette section est de déterminer un ensemble de paramètres permettant d'assurer une régulation stable de l'angle tout en garantissant une bonne régulation de la vitesse.

La synthèse est réalisée de manière séquentielle. La boucle interne, dédiée à la régulation de l'angle, est dimensionnée en premier car elle doit être significativement plus rapide que la boucle externe de vitesse. Une fois cette boucle stabilisée, la boucle externe est ajustée afin d'obtenir la dynamique souhaitée.

Les simulations sont réalisées à partir des conditions initiales suivantes : le robot est immobile, mais présente une inclinaison initiale de $5^\circ$. Ce scénario permet d'évaluer la capacité du régulateur à rétablir rapidement l'équilibre.

$$
\vec{X}_0=(0,0,5^\circ,0)
$$

Dans un premier temps, seul le gain proportionnel de la boucle d'angle, $K_{pt}$, est utilisé. Sa valeur est progressivement augmentée jusqu'à obtenir un retour à la position d'équilibre. Lorsque ce gain devient suffisamment élevé, le système parvient à maintenir le robot debout, mais au prix d'une réponse sous-amortie caractérisée par des oscillations importantes. Cette étape permet de vérifier que le gain proportionnel apporte la rigidité nécessaire à la stabilisation du système, sans toutefois garantir un comportement satisfaisant.

\begin{figure}[H]
    \centering
    
    \caption{Accélération du système avec uniquement le gain proportionnel $K_{pt}$.}
    \label{fig:reg_P_accel}
\end{figure}

\begin{figure}[H]
    \centering
    
    \caption{Vitesse du système avec uniquement le gain proportionnel $K_{pt}$.}
    \label{fig:reg_P_velocity}
\end{figure}

\begin{figure}[H]
    \centering
    
    \caption{Angle du système avec uniquement le gain proportionnel $K_{pt}$.}
    \label{fig:reg_P_angle}
\end{figure}

Afin de réduire ces oscillations, une action dérivée est ensuite ajoutée. Le paramètre $T_{dt}$ est ajusté de manière à augmenter l'amortissement du système sans ralentir excessivement sa réponse. L'action dérivée agit principalement lors des variations rapides de l'angle et limite le dépassement tout en accélérant la convergence vers l'équilibre. La dynamique obtenue est nettement plus stable que celle observée avec un simple régulateur proportionnel.

\begin{figure}[H]
    \centering
    
    \caption{Accélération du système après ajout de l'action dérivée ($K_{pt}$, $T_{dt}$).}
    \label{fig:reg_PD_accel}
\end{figure}

\begin{figure}[H]
    \centering
    
    \caption{Vitesse du système après ajout de l'action dérivée ($K_{pt}$, $T_{dt}$).}
    \label{fig:reg_PD_velocity}
\end{figure}

\begin{figure}[H]
    \centering
    
    \caption{Angle du système après ajout de l'action dérivée ($K_{pt}$, $T_{dt}$).}
    \label{fig:reg_PD_angle}
\end{figure}
Une fois la boucle interne validée, la boucle externe de vitesse est synthétisée. Les gains de cette boucle sont choisis de manière à obtenir une réponse plus lente que celle de la régulation d'angle, afin d'éviter toute interaction défavorable entre les deux niveaux de commande.

La réponse finale montre que le robot retrouve rapidement sa position verticale tout en annulant progressivement sa vitesse. L'accélération est limitée à la phase transitoire, ce qui traduit un fonctionnement stable des deux boucles de régulation.

\begin{figure}[H]
    \centering
    
    \caption{Accélération du système avec les deux boucles de régulation synthétisées.}
    \label{fig:reg_ALL_accel}
\end{figure}

\begin{figure}[H]
    \centering
    
    \caption{Vitesse du système avec les deux boucles de régulation synthétisées.}
    \label{fig:reg_ALL_velocity}
\end{figure}

\begin{figure}[H]
    \centering
    
    \caption{Angle du système avec les deux boucles de régulation synthétisées.}
    \label{fig:reg_ALL_angle}
\end{figure}
Par souci de faisabilité, le couple mécanique requis par cette stratégie de régulation est également évalué afin de vérifier sa compatibilité avec les capacités des actionneurs.

\begin{figure}[H]
    \centering
    
    \caption{Couple nécessaire à la régulation obtenu à partir du modèle théorique.}
    \label{fig:required_torque}
\end{figure}

La figure \ref{fig:required_torque} montre que le couple maximal demandé au système est d'environ
$$
T_{\mathrm{max,\,req}} = 0.5~\si{\newton\meter}.
$$
Ce pic apparaît au tout début du mouvement, lorsque le régulateur doit rapidement corriger l'inclinaison initiale de $5^\circ$. Une fois cette phase transitoire passée, le couple diminue rapidement et oscille autour de zéro afin de maintenir l'équilibre.

Chaque moteur est capable de fournir un couple maximal de
$$
T_{\mathrm{max,\,mot}} = 0.45~\si{\newton\meter}.
$$
La maquette étant entraînée par deux moteurs, le couple maximal théorique disponible est donc
$$
T_{\mathrm{max,\,disp}} = 2 \times 0.45 = 0.9~\si{\newton\meter}.
$$

Le couple requis par la régulation reste ainsi largement inférieur au couple disponible, avec une marge de près de 45\,\%. Les actionneurs sont donc correctement dimensionnés et les paramètres de régulation retenus sont compatibles avec les capacités mécaniques du système. Cette réserve de couple permettra également d'absorber les incertitudes du modèle ainsi que les perturbations pouvant apparaître lors des essais expérimentaux.

Les paramètres finaux utilisés sont les suivants :

\begin{itemize}
    \item \textbf{Boucle de vitesse :}
    \[
    K_{pv}=26,\qquad
    K_{iv}=0,\qquad
    T_{dv}=0.
    \]

    \item \textbf{Boucle d'angle ($\theta$) :}
    \[
    K_{pt}=1.53,\qquad
    K_{it}=0,\qquad
    T_{dt}=0.38.
    \]
\end{itemize}
