Ding-Jeremy/Self-Balancing-Bot/A_Documentation/Rapport/assets/figures/graphs/hold_positive_speed.pdf

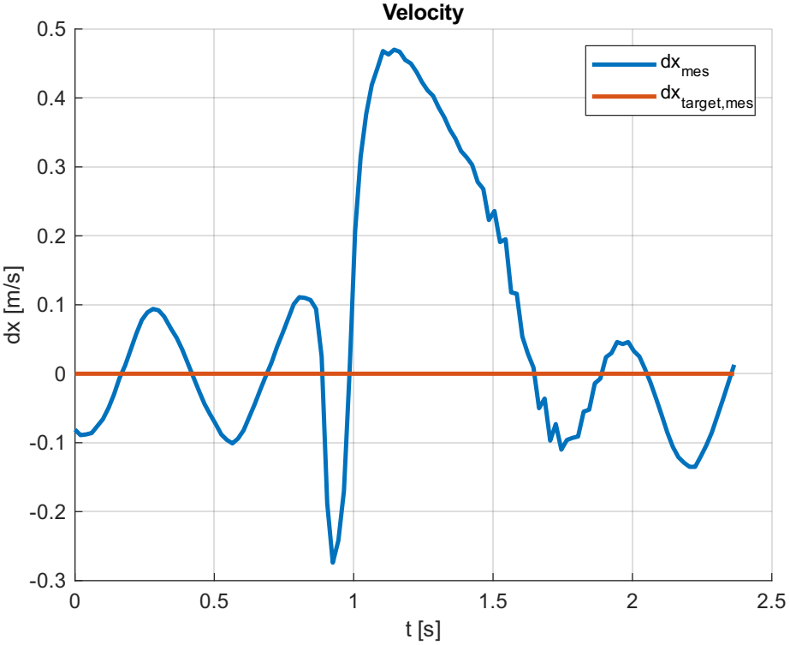
[picture p59: figure]
Velo; cit
