Ding-Jeremy/Self-Balancing-Bot/A_Documentation/Factures/Facture_SwayTronic.png

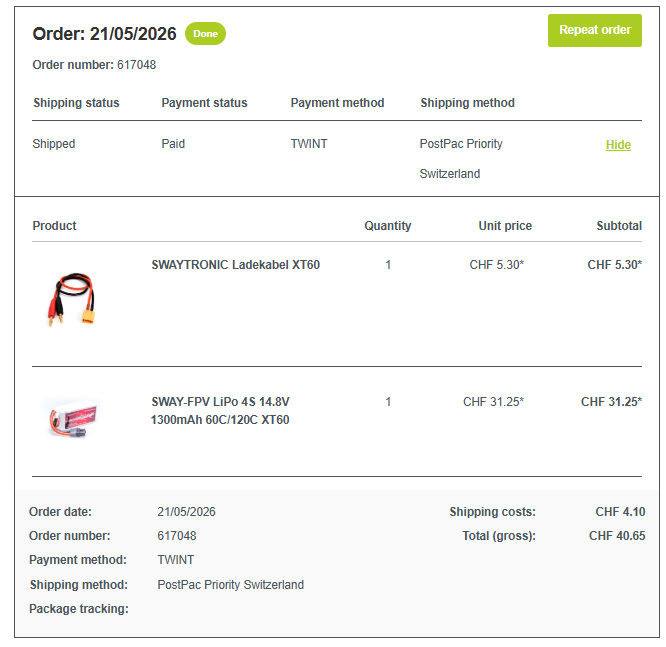
A_Documentation/Factures/Facture_SwayTronic.png
