Ding-Jeremy/Self-Balancing-Bot/A_Documentation/Rapport/assets/figures/breadboard.jpg

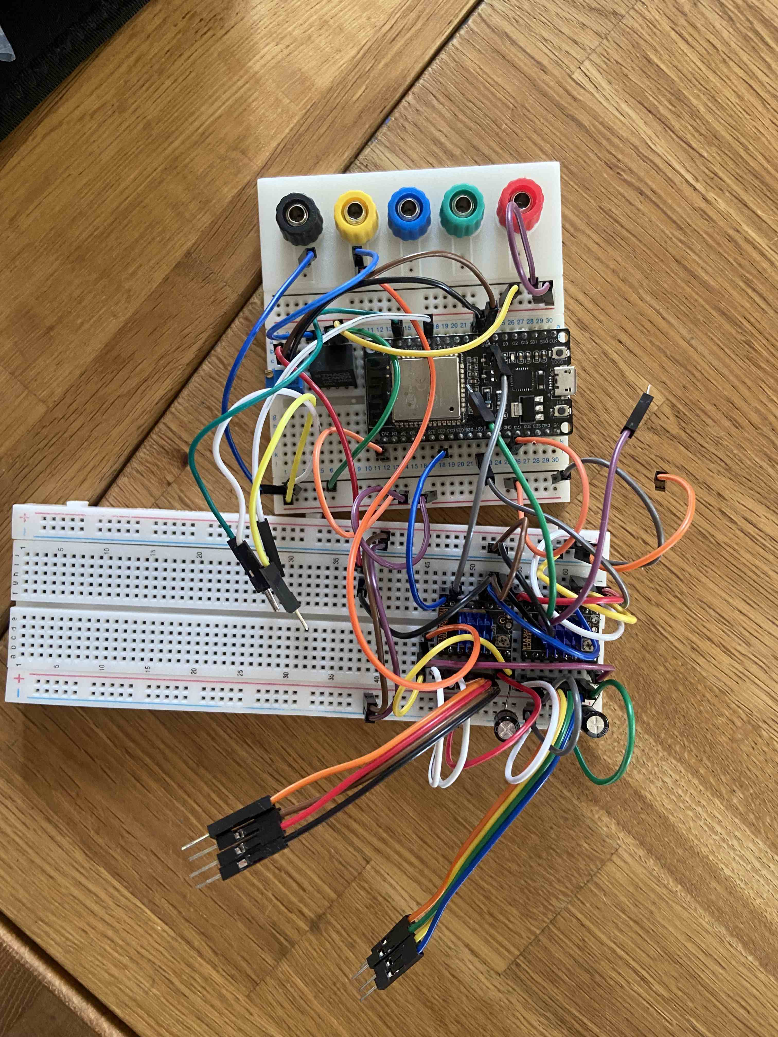
A_Documentation/Rapport/assets/figures/breadboard.jpg
