Ding-Jeremy/Self-Balancing-Bot/A_Documentation/Rapport/assets/figures/pieces.jpg

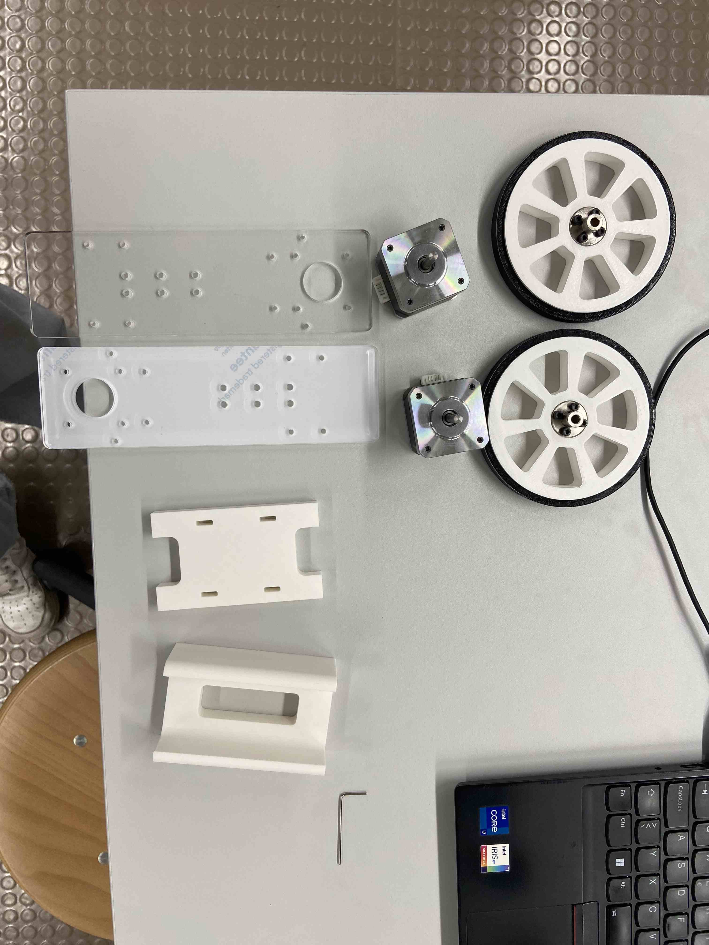
A_Documentation/Rapport/assets/figures/pieces.jpg
