Ding-Jeremy/Self-Balancing-Bot/A_Documentation/Rapport/assets/figures/schema_power.png

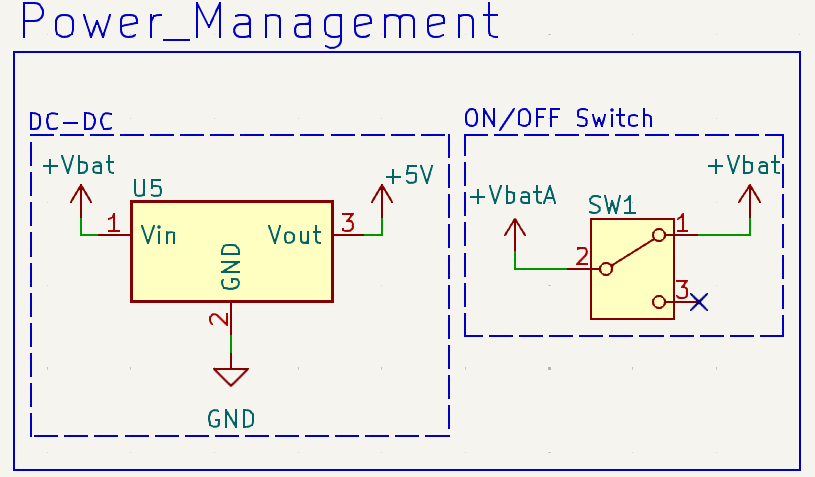
A_Documentation/Rapport/assets/figures/schema_power.png
