Ding-Jeremy/Self-Balancing-Bot/A_Documentation/Rapport/assets/annexes/BOM.pdf

Reference | Value | Footprint | Manufacturer | MPN | Supplier | SPN | Qty | Price/Pce | Price | Type/Total
C1,C2 | 100uF | SMD 6.3 | Nichicon | UWT1V101MCL1GS | Digikey | 493-2203-1-ND | 2 | CHF 0.34 | CHF 0.68 | P C B
J2,J3 | Conn_01x04_Pin | Pin Header 2.54mm | Samtec Inc. | TS-108-G-A | Digikey | 612-TS-108-G-A-ND | 2 | CHF 2.46 | CHF 4.92
J4 | Screw_Terminal_01x02 | Screw Terminal 5mm | Same Sky (Formerly CUI Devices) | TB002-500-02BE | Digikey | 102-6145-ND | 1 | CHF 0.26 | CHF 0.26
R1 | 1k | 1206 YAGEO | | RC1206FR-071KL | Digikey | 311-1.00KFRCT-ND | 1 | CHF 0.08 | CHF 0.08
R3 | 51k | 1206 YAGEO | | RC1206JR-0751KL | Digikey | 311-51KERCT-ND | 1 | CHF 0.08 | CHF 0.08
R4 | 10k | 1206 YAGEO | | RC1206FR-0710KL | Digikey | 311-10.0KFRCT-ND | 1 | CHF 0.08 | CHF 0.08
SW1 | SW_SPDT | - | C&K | OS102011MS2QN1 | Digikey | CKN9565-ND | 1 | CHF 0.65 | CHF 0.65
U1 | ~ | - | Joy-It | MPU6050 | Conrad | 2136256 - UP | 1 | CHF 4.53 | CHF 4.53
U2 | ~ | - | Espressif | ESP32-DEV-30P | Distrelec | 304-89-812 | 1 | CHF 16.93 | CHF 16.93
U3,U4 | ~ | - | BigTechTree | TMC2226 | 3D Jake | BIQU-1020000203 | 2 | CHF 7.70 | CHF 15.40
U5 | TSR1-2450E | - | Traco Power | TSR 1-2450E | Distrelec | 302-25-003 | 1 | CHF 4.20 | CHF 4.20
- | PCB | - | JLCPCB | - | JLCPCB | - | 5 | CHF 1.40 | CHF 7.00 | CHF 52.35
3 | Vis tête cylindrique | M3x10mm | - | - | (MakeLab) | - | 12 | | CHF 0.00 | M E C A
5 | Vis tête cylindrique | M3x12mm | - | - | (MakeLab) | - | 4 | | CHF 0.00
- | Colonnette | M3x6mm | - | - | Atelier Mécanique | - | 4 | | CHF 0.00
2 | Vis tête cylindrique | M3x8mm | - | - | (MakeLab) | - | 16 | | CHF 0.00
1 | Vis tête cylindrique | M3x5mm | - | - | (MakeLab) | - | 4 | | CHF 0.00
10 | Coupleur | - | Wenzhou Wancheng Machinery Store | - | Aliexpress | - | 2 | CHF 2.57 | CHF 5.14
4 | Ecrou M3 | - | - | - | Atelier Mécanique | - | 4 | | CHF 0.00 | CHF 5.14
- | Batterie LiPo 4s | - | SwayTronic | - | SwayTronic | 7640182620691 | 1 | CHF 31.25 | CHF 31.25 | ALIM+MOT
- | Câble XT60 | - | SwayTronic | - | SwayTronic | 7640159361831 | 1 | CHF 5.30 | CHF 5.30
- | Moteur pas à pas | NEMA17-04 | - | - | Brack | 126042 | 1 | CHF 15.95 | CHF 15.95 | CHF 52.50
Total | | | | | | | | | | CHF 109.99
