Ding-Jeremy/Self-Balancing-Bot/C_Fabrication/V0/BOM.xlsx

Description | N° Fabricant | Fournisseur | N° Fournisseur | Qty | Prix/Pce | Prix/tot
Microcontrôleur | ESP32-DEV-30P | Distrelec | 304-89-812 | 1 | CHF 16.93 | CHF 16.93
Driver Moteur | Bigtechtree TMC2226 | 3d Jake | BIQU-1020000203 | 2 | CHF 7.70 | CHF 15.40
Cable XT60, Batterie | - | SwayTronic | 7640159361831 | 1 | CHF 5.30 | CHF 5.30
Batterie LiPo 4S | - | SwayTronic | 7640182620691 | 1 | CHF 31.25 | CHF 31.25
Moteur pas à pas | NEMA17-04 | Brack | 1260462 | 2 | CHF 15.95 | CHF 31.90
Step Down | TSR 1-2450E | Distrelec | 302-25-003 | 1 | CHF 4.20 | CHF 4.20
 |  |  |  |  |  | CHF 104.98
