Ding-Jeremy/Self-Balancing-Bot/C_Fabrication/V0/B_Mecanique/3D/Main_plate.stl

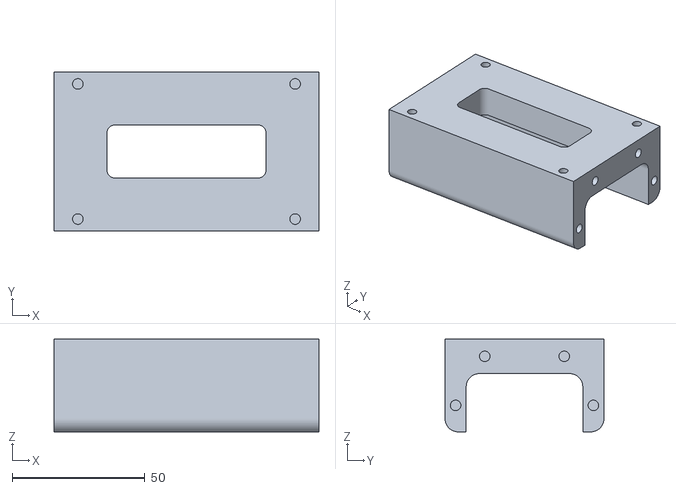
[picture p64: CAD file, 2026-06-29]
C_Fabrication/V0/B_Mecanique/3D/Main_plate.stl
100.0 x 60.0 x 35.0
