Ding-Jeremy/Self-Balancing-Bot/C_Fabrication/V0/A_Circuit/Librairies/3D/Adafruit_BNO055_AP214.STEP

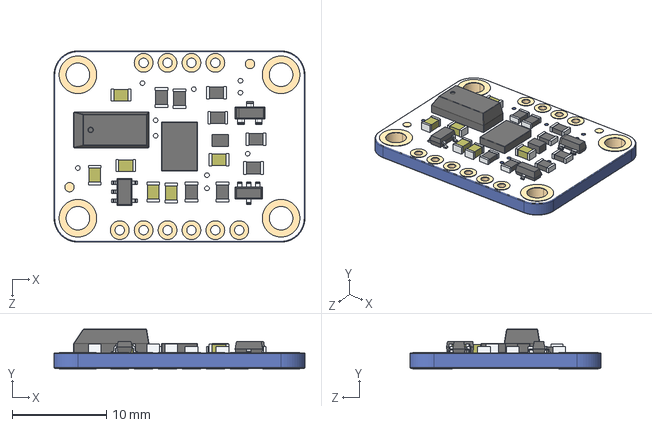
[picture p65: CAD file, 2026-06-29]
C_Fabrication/V0/A_Circuit/Librairies/3D/Adafruit_BNO055_AP214.STEP
26.7 x 4.20 x 20.3 mm
