Ding-Jeremy/Self-Balancing-Bot/C_Fabrication/V0/B_Mecanique/3D/Battery_Support.stl

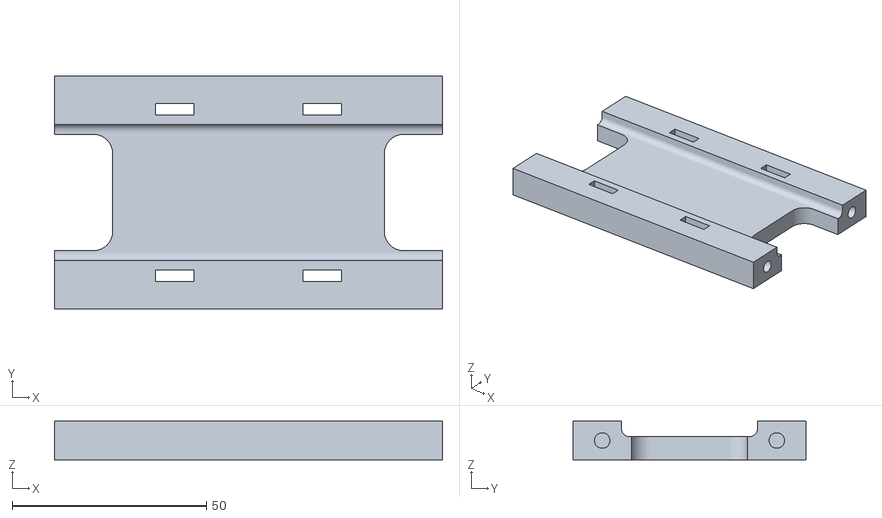
[picture p66: CAD file, 2026-07-01]
C_Fabrication/V0/B_Mecanique/3D/Battery_Support.stl
100.0 x 60.0 x 10.0
