Ding-Jeremy/Self-Balancing-Bot/C_Fabrication/V0/A_Circuit/Librairies/3D/TMC2130-V3.0.step

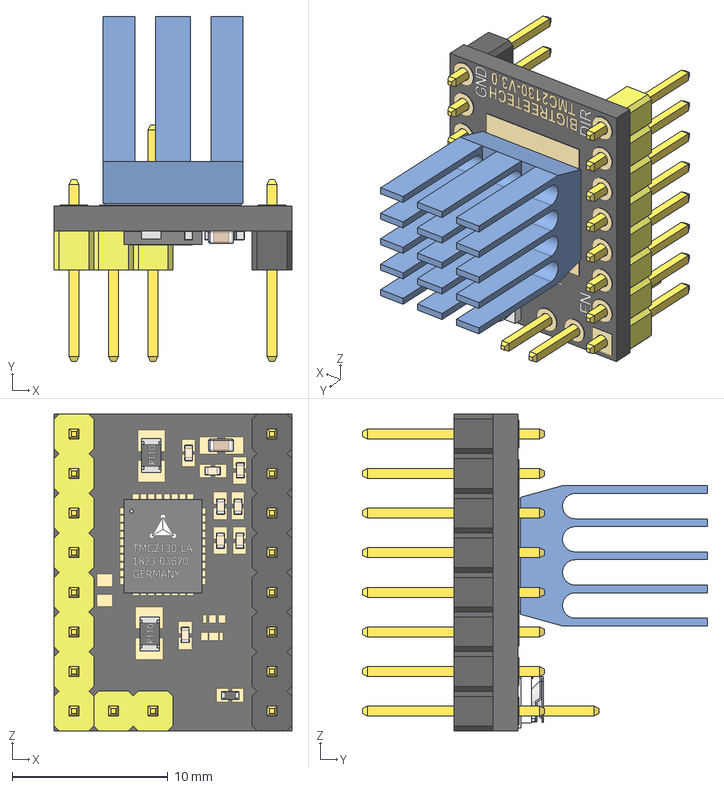
[picture p67: CAD file, 2026-06-29]
C_Fabrication/V0/A_Circuit/Librairies/3D/TMC2130-V3.0.step
15.2 x 22.1 x 20.3 mm
Pin_Header_1x2_red
Pin_Header_1x8_red
Pin_Header_1x8_black
EVM-3E
TMC2209_heatsink
TMC2209_board
TMC 2130 LA
Resistor 0805 x 2
Capacitor 0402 x 8
Resistor 0402
