Ding-Jeremy/Self-Balancing-Bot/C_Fabrication/V0/B_Mecanique/3D/Fall_Protectoin.stl

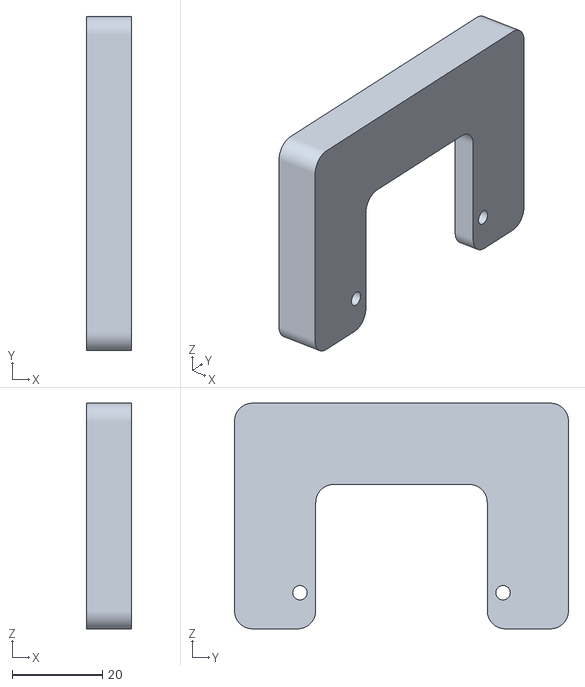
[picture p68: CAD file, 2026-07-01]
C_Fabrication/V0/B_Mecanique/3D/Fall_Protectoin.stl
10.0 x 74.0 x 50.0
