Ding-Jeremy/Self-Balancing-Bot/C_Fabrication/V0/A_Circuit/Librairies/3D/A4988.STEP

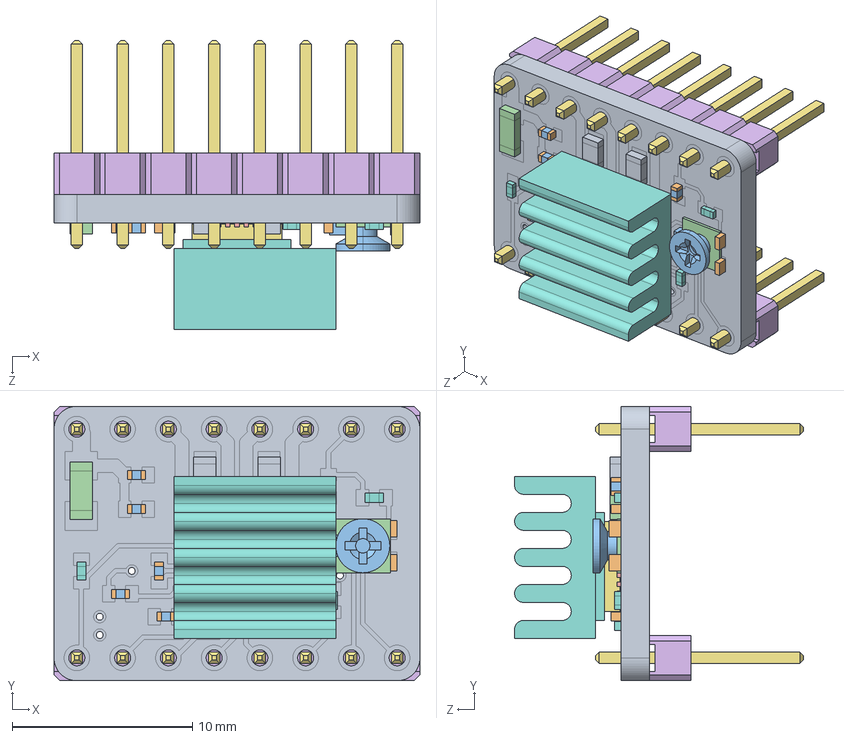
[picture p69: CAD file, 2026-06-29]
C_Fabrication/V0/A_Circuit/Librairies/3D/A4988.STEP
20.3 x 15.2 x 16.0 mm
stepstick
0402CAP_CAP0402CAP x 6
1206_CAP1206
QFN28ET_A4983
0402RES_RESISTOR0402RES x 4
0805_RESISTOR x 2
TRIMPOT3MM_TRIMPOTSMD
Pin header pitch 2.54mm_08 contacts x 2
Heatsink For A4988
