Ding-Jeremy/Self-Balancing-Bot/C_Fabrication/V0/B_Mecanique/3D/Wheel.step

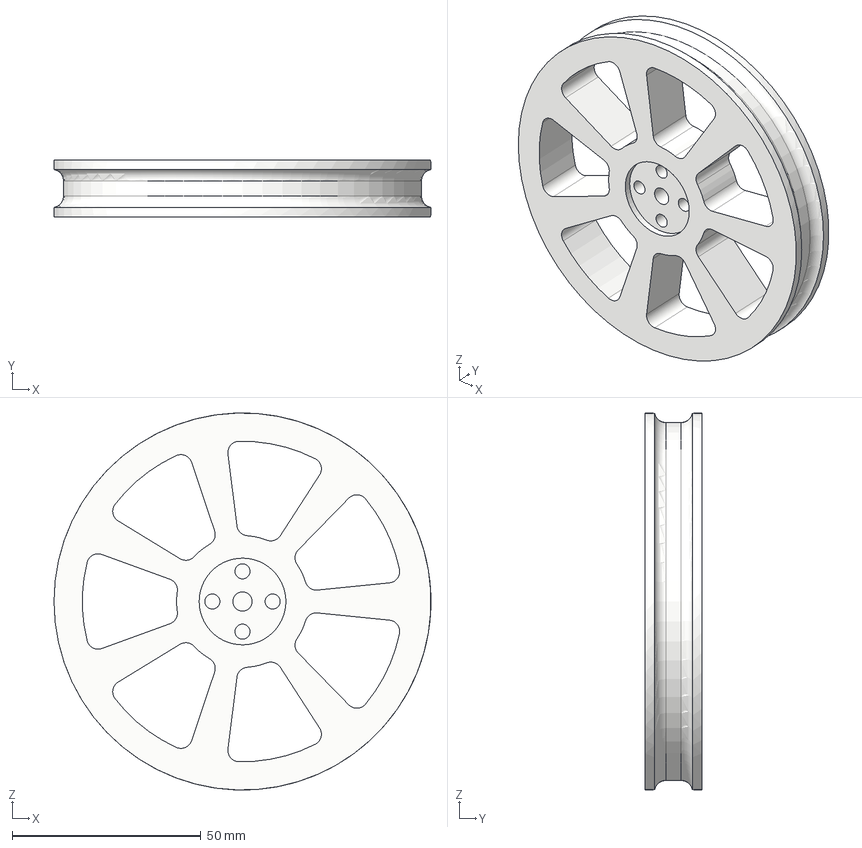
[picture p70: CAD file, 2026-06-29]
C_Fabrication/V0/B_Mecanique/3D/Wheel.step
100.0 x 15.0 x 100.0 mm
