Ding-Jeremy/Self-Balancing-Bot/C_Fabrication/V0/B_Mecanique/3D/Side_Panel.stl

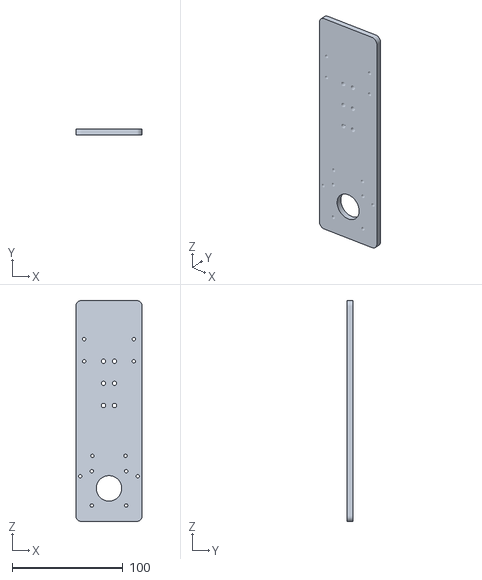
[picture p71: CAD file, 2026-06-29]
C_Fabrication/V0/B_Mecanique/3D/Side_Panel.stl
60.0 x 5.00 x 200.0
