Ding-Jeremy/Self-Balancing-Bot/C_Fabrication/V0/B_Mecanique/3D/Tyre.stl

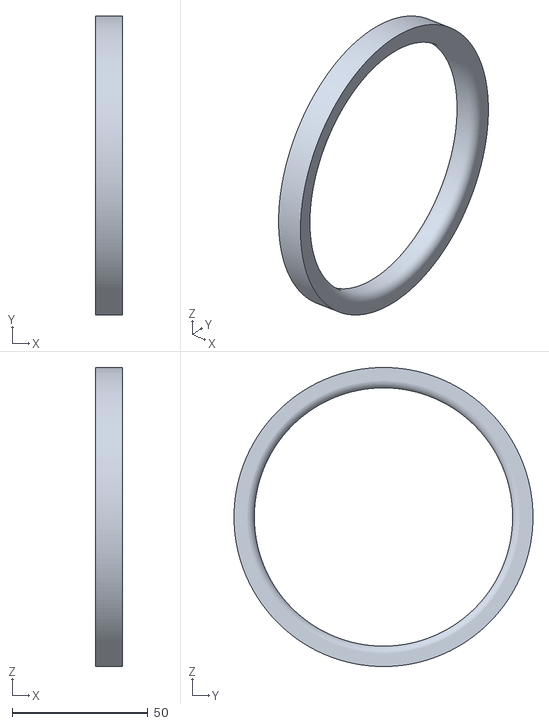
[picture p72: CAD file, 2026-06-29]
C_Fabrication/V0/B_Mecanique/3D/Tyre.stl
10.0 x 110.0 x 110.0
