Ding-Jeremy/Self-Balancing-Bot/(list of files, cad)

Other CAD files:
C_Fabrication/V0/B_Mecanique/3D/Side_Panel.f3d
C_Fabrication/V0/B_Mecanique/3D/Wheel.stl
