Ding-Jeremy/Self-Balancing-Bot/E_Simulations/Matlab/results/hold_negative_speed.pdf

Velocity; dxmes dx; target,mes
