Ding-Jeremy/Self-Balancing-Bot/E_Simulations/Matlab/results/max_speed.pdf

Max Velocity; Min = -0.864 m/s; dxmes data1
