Ding-Jeremy/Self-Balancing-Bot/E_Simulations/Matlab/results/hold_positive_speed.pdf

Velo; cit
