Ding-Jeremy/Self-Balancing-Bot/E_Simulations/Matlab/results/reg_all_torque.pdf

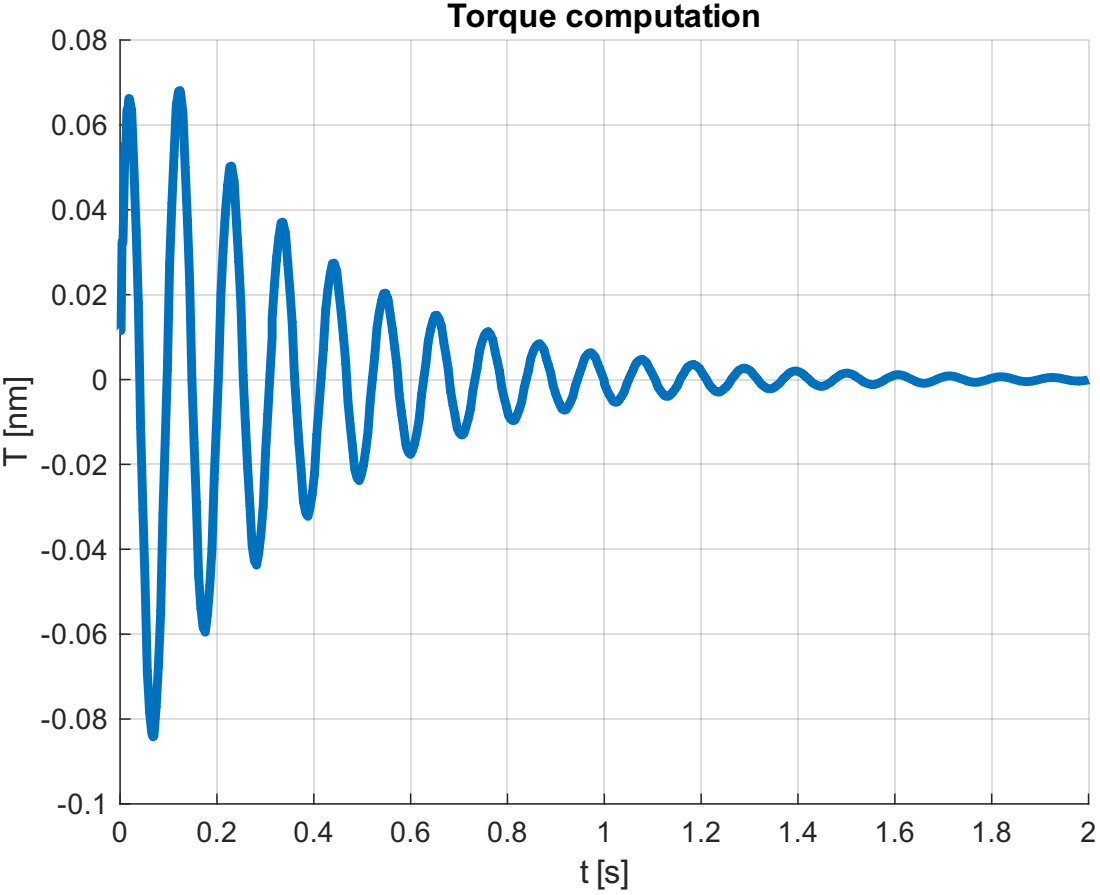
[picture p73: page 1]
Torque computation
