Ding-Jeremy/Self-Balancing-Bot/E_Simulations/Matlab/results/reg_ALL_velocity.pdf

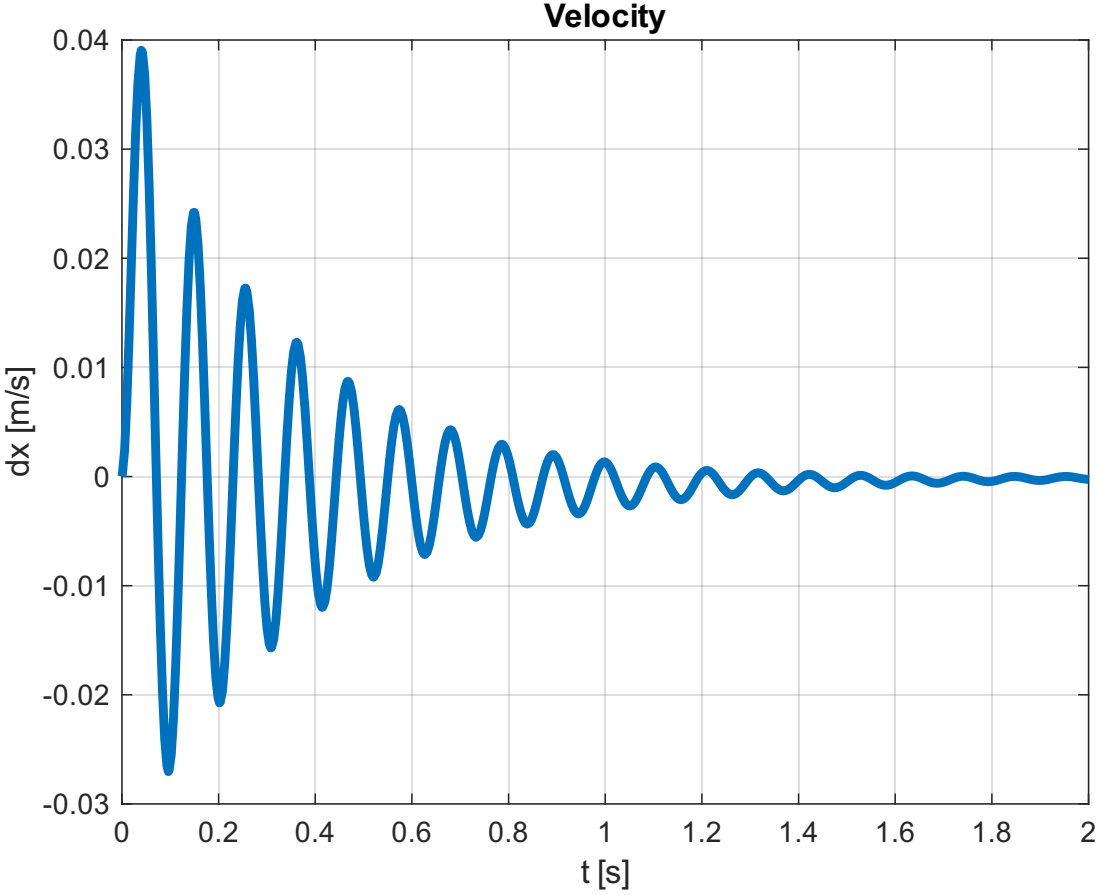
[picture p74: page 1]
Velocity
