Ding-Jeremy/Self-Balancing-Bot/E_Simulations/Matlab/results/velocity_misalign_com.pdf

Velocity
