Ding-Jeremy/Self-Balancing-Bot/E_Simulations/Matlab/results/trapez_move_velocity_avg.pdf

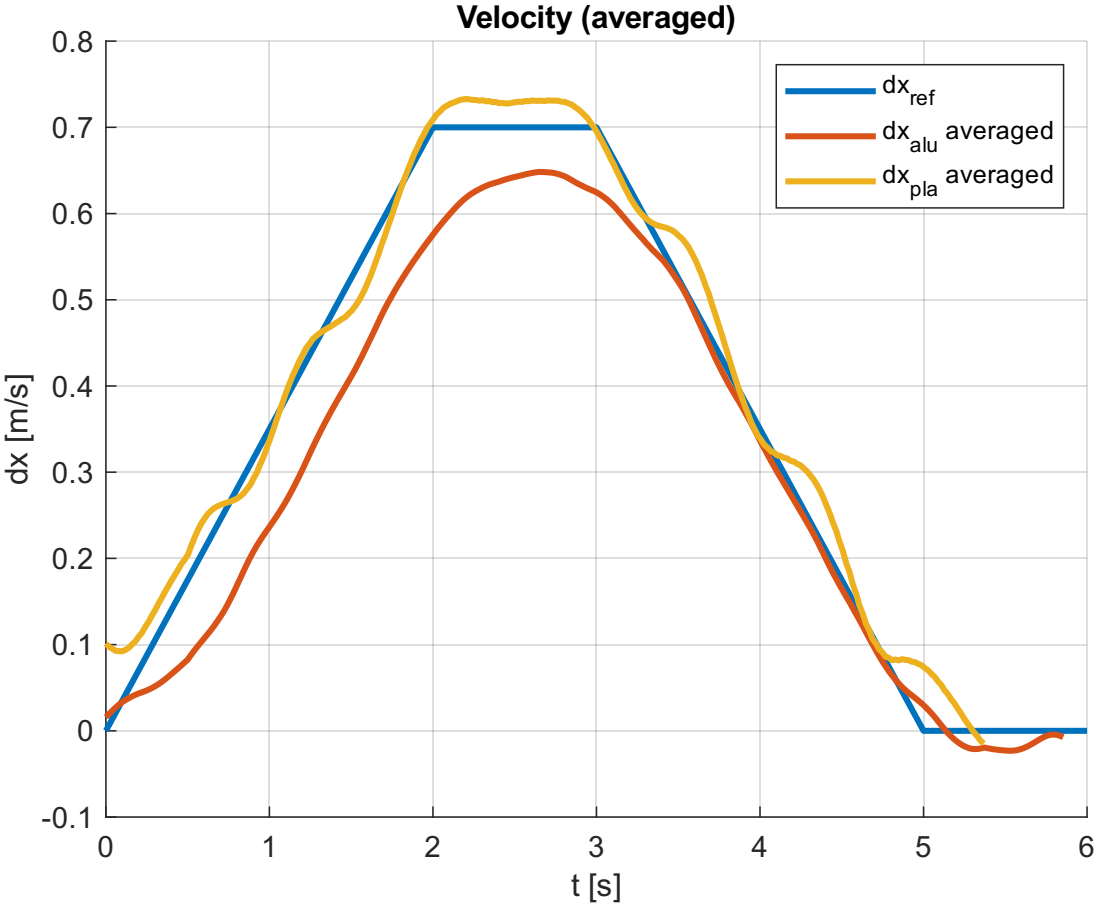
[picture p75: page 1]
Velocity (averaged)

dx ref dx | averaged

alu dx pla | averaged
