Ding-Jeremy/Self-Balancing-Bot/E_Simulations/Matlab/results/reg_P_velocity.pdf

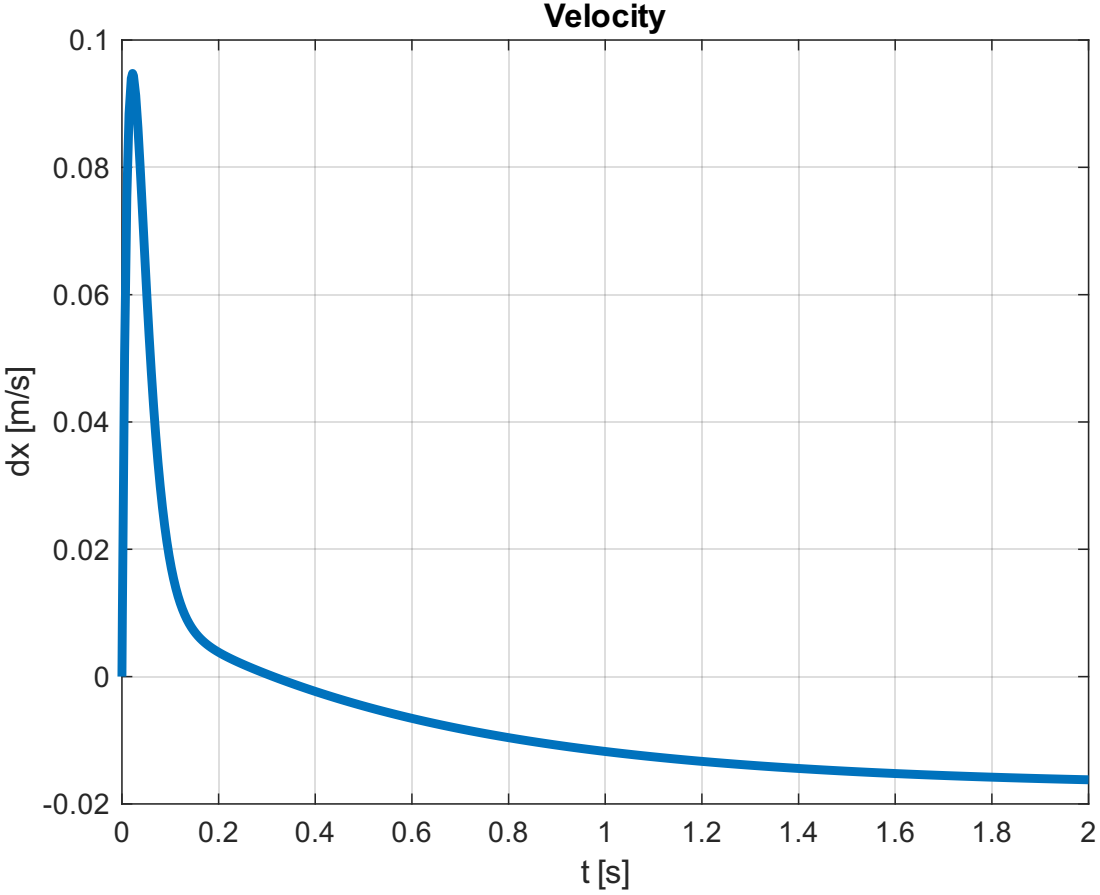
[picture p76: page 1]
Velocity
