Ding-Jeremy/Self-Balancing-Bot/E_Simulations/Matlab/results/reg_PD_velocity.pdf

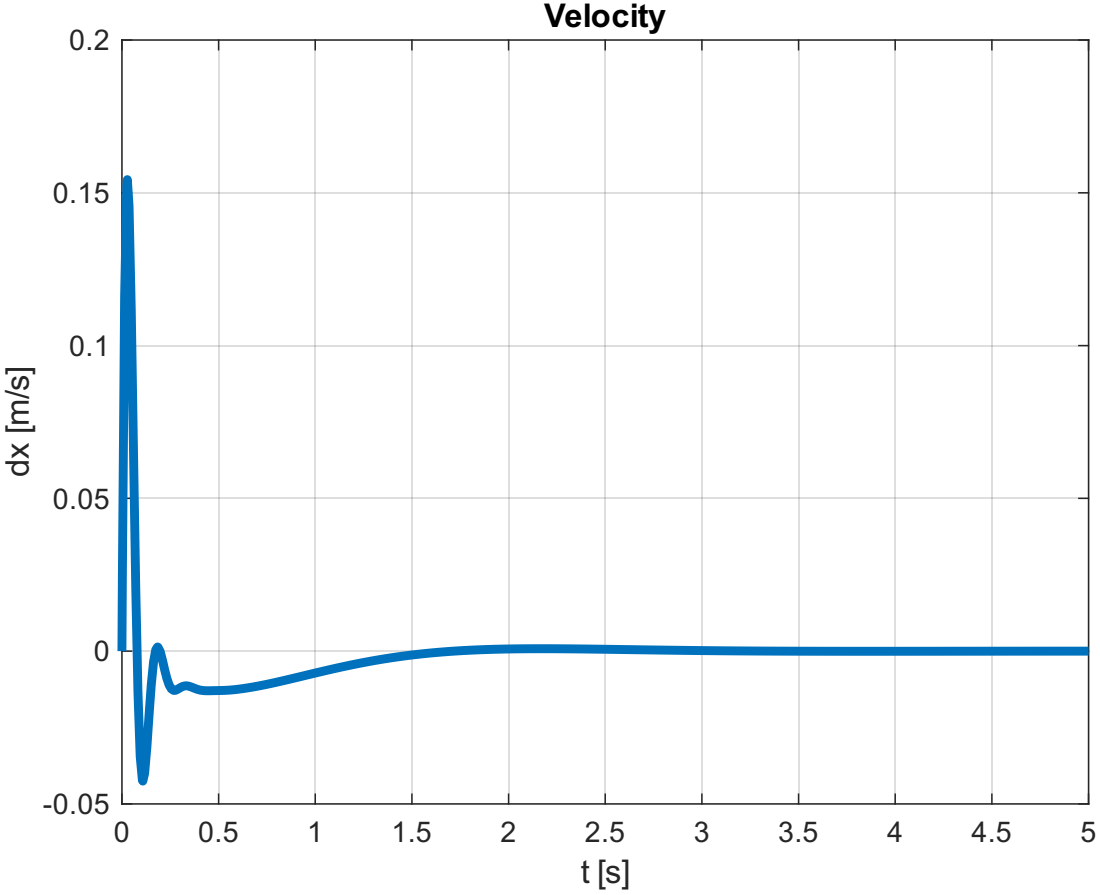
[picture p77: page 1]
Velocity
