Ding-Jeremy/Self-Balancing-Bot/A_Documentation/Rapport/assets/annexes/Self_Balancing_Bot_V0.pdf

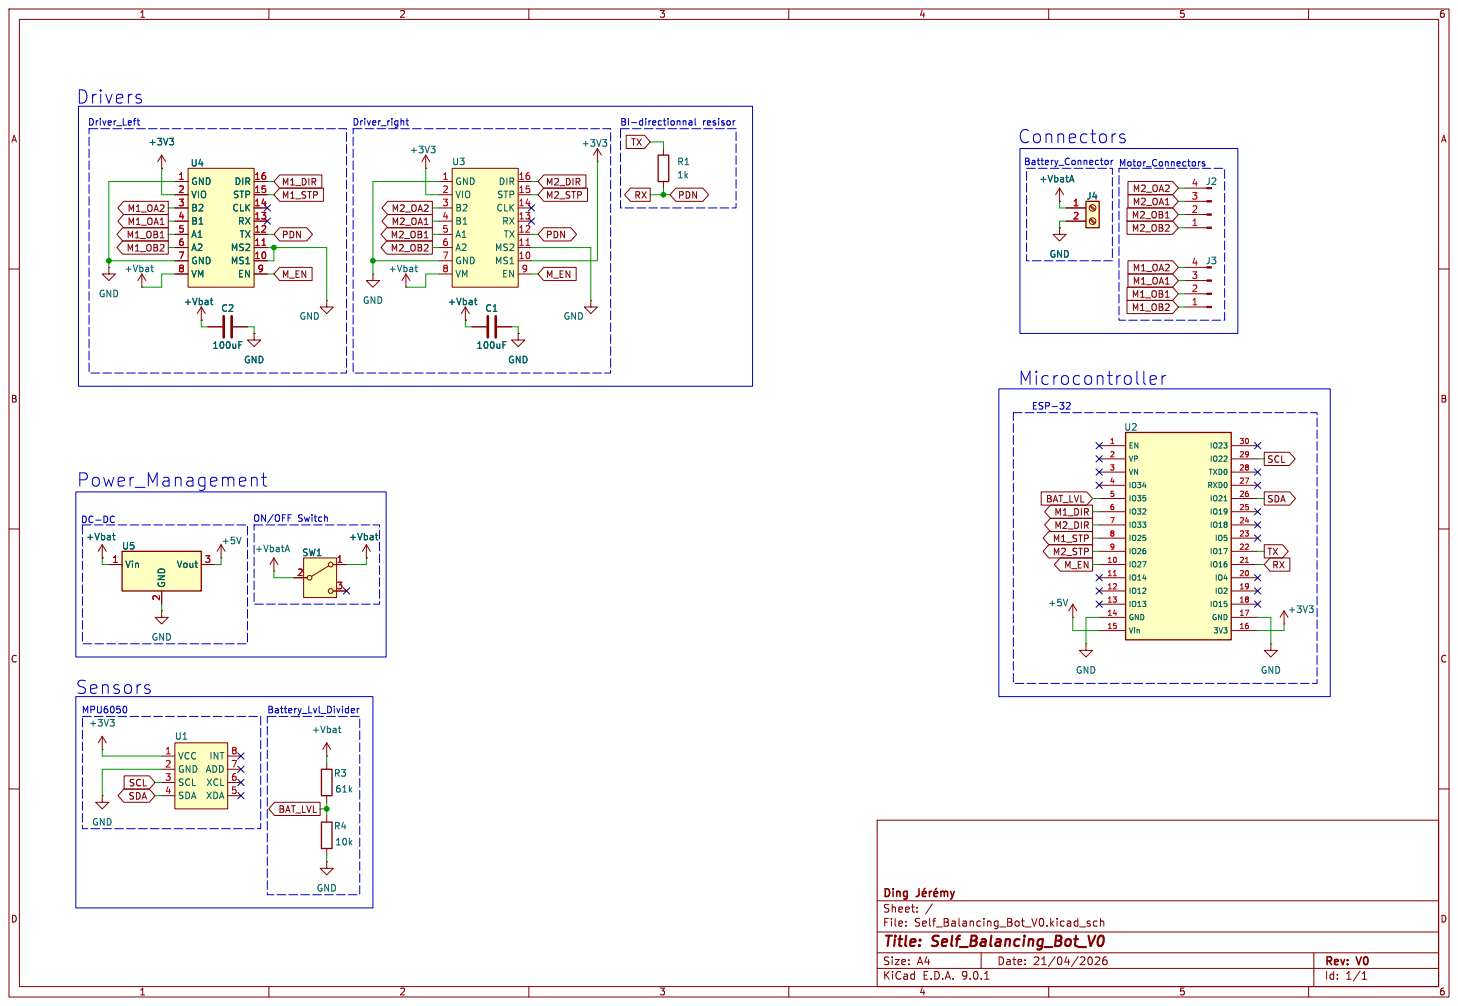
[picture p78: page 1]

File: Self_Balancing_Bot_V0.kicad_sch Sheet: / Ding þÿJérémy
