Ding-Jeremy/Self-Balancing-Bot/A_Documentation/Rapport/assets/figures/graphs/reg_all_torque.pdf

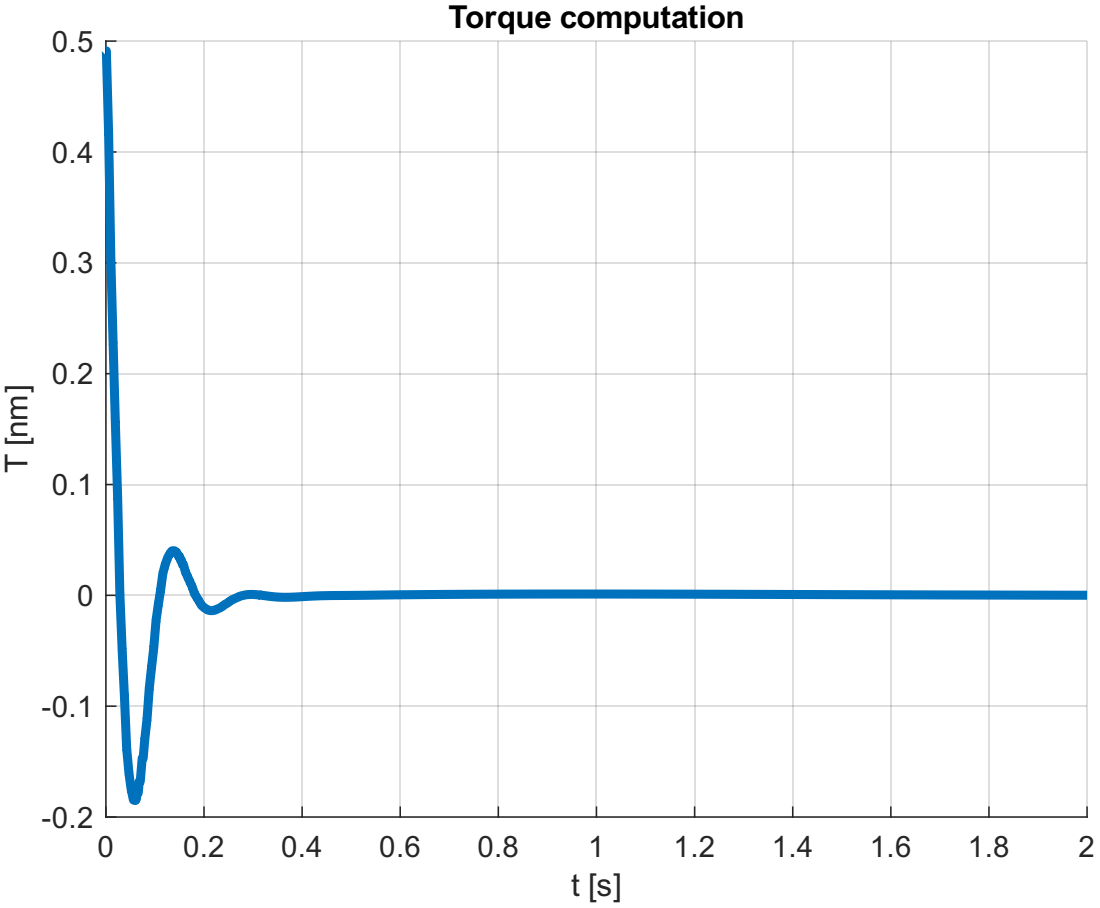
[picture p79: page 1]
Torque computation
