Ding-Jeremy/Self-Balancing-Bot/A_Documentation/Rapport/assets/figures/graphs/reg_ALL_velocity.pdf

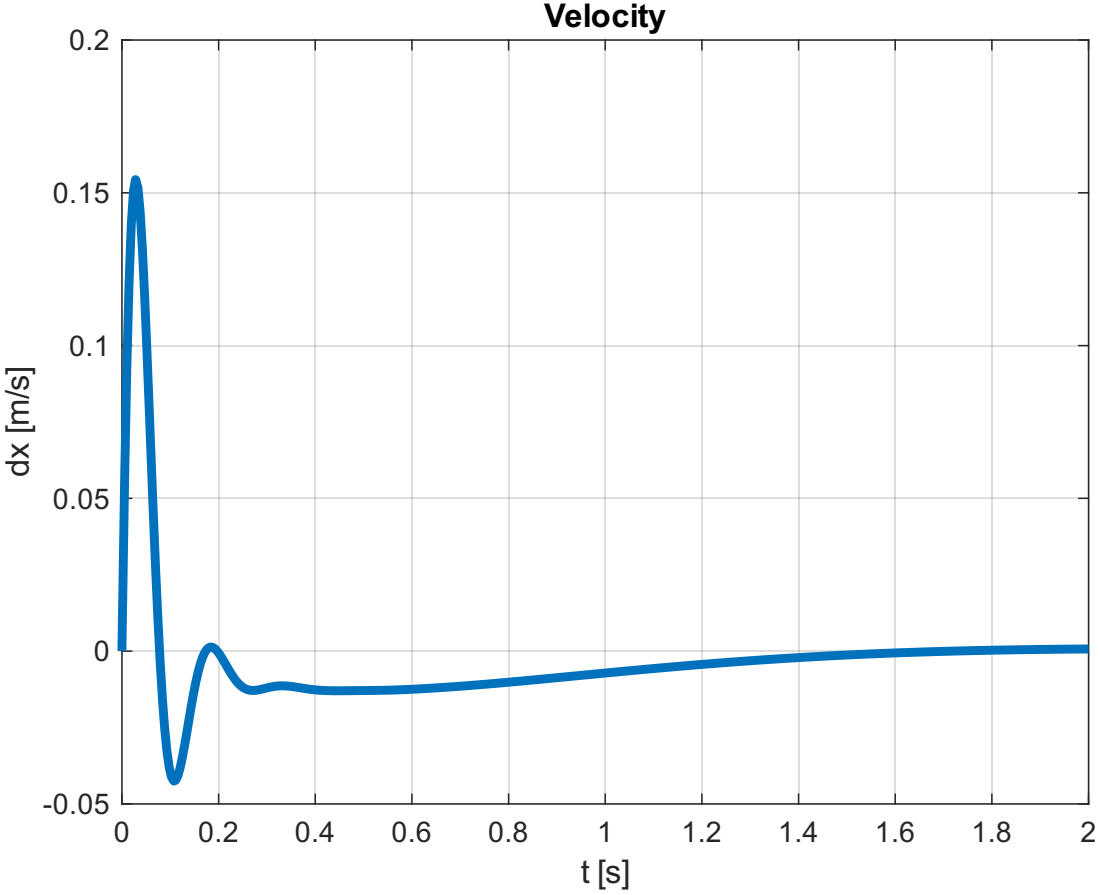
[picture p80: page 1]
Velocity
