Ding-Jeremy/Self-Balancing-Bot/A_Documentation/Rapport/assets/figures/graphs/reg_P_velocity.pdf

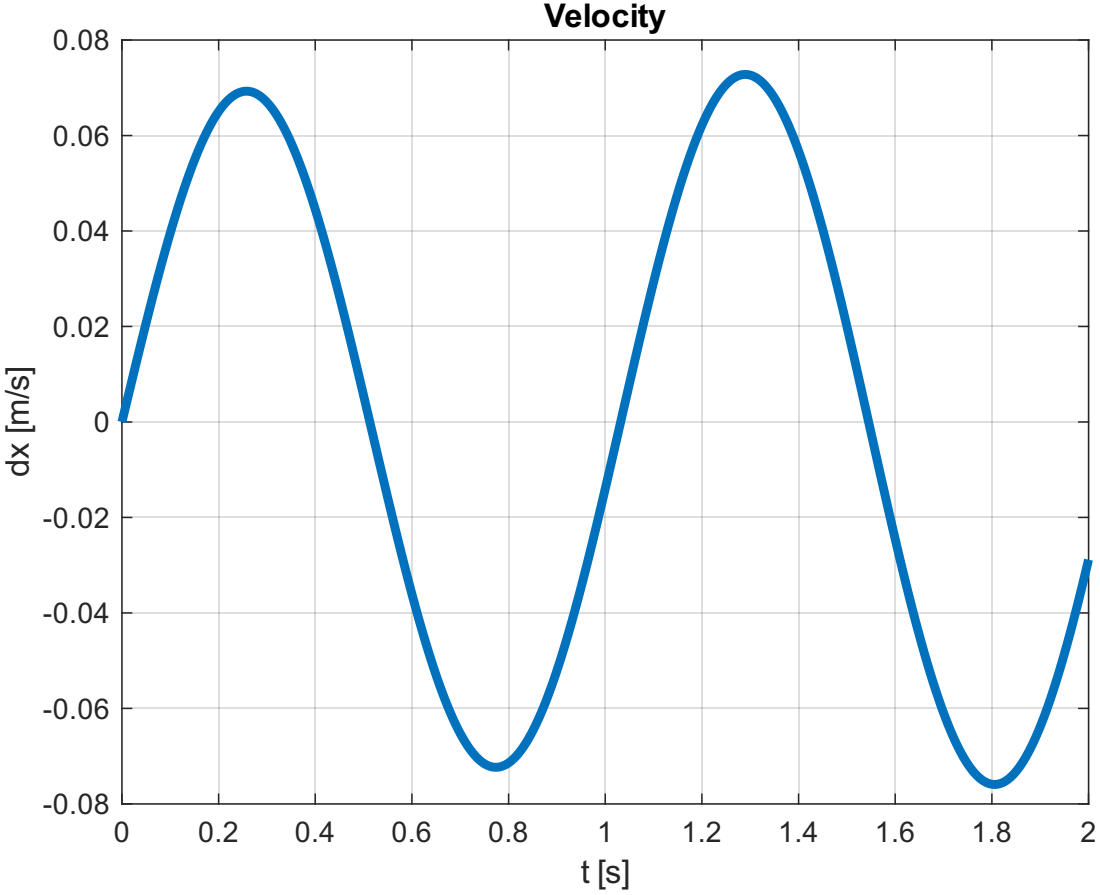
[picture p81: page 1]
Velocity
