Ding-Jeremy/Self-Balancing-Bot/E_Simulations/Matlab/results/acceleration_misalign_com.pdf

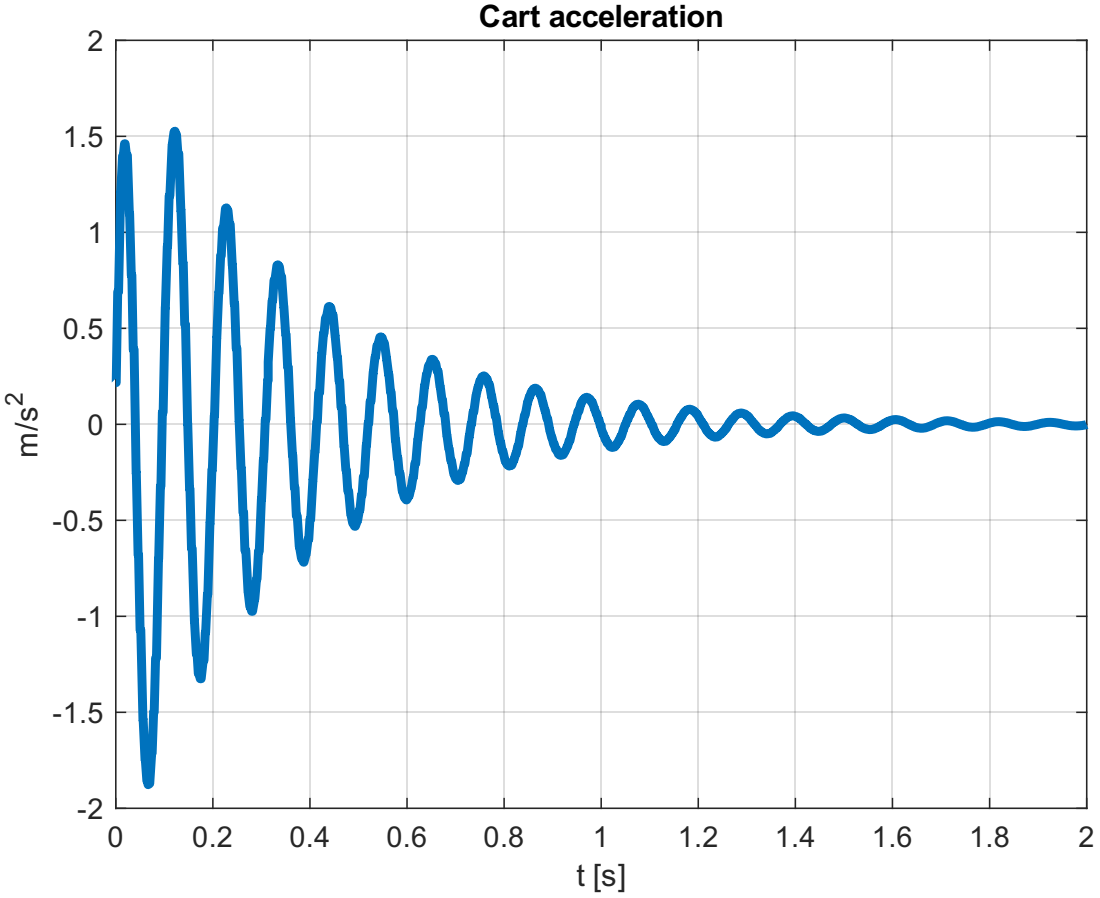
[picture p82: page 1]
Cart acceleration
