Ding-Jeremy/Self-Balancing-Bot/E_Simulations/Matlab/results/reg_ALL_acccel.pdf

Cart acceleration
