Ding-Jeremy/Self-Balancing-Bot/E_Simulations/Matlab/results/reg_ALL_angles.pdf

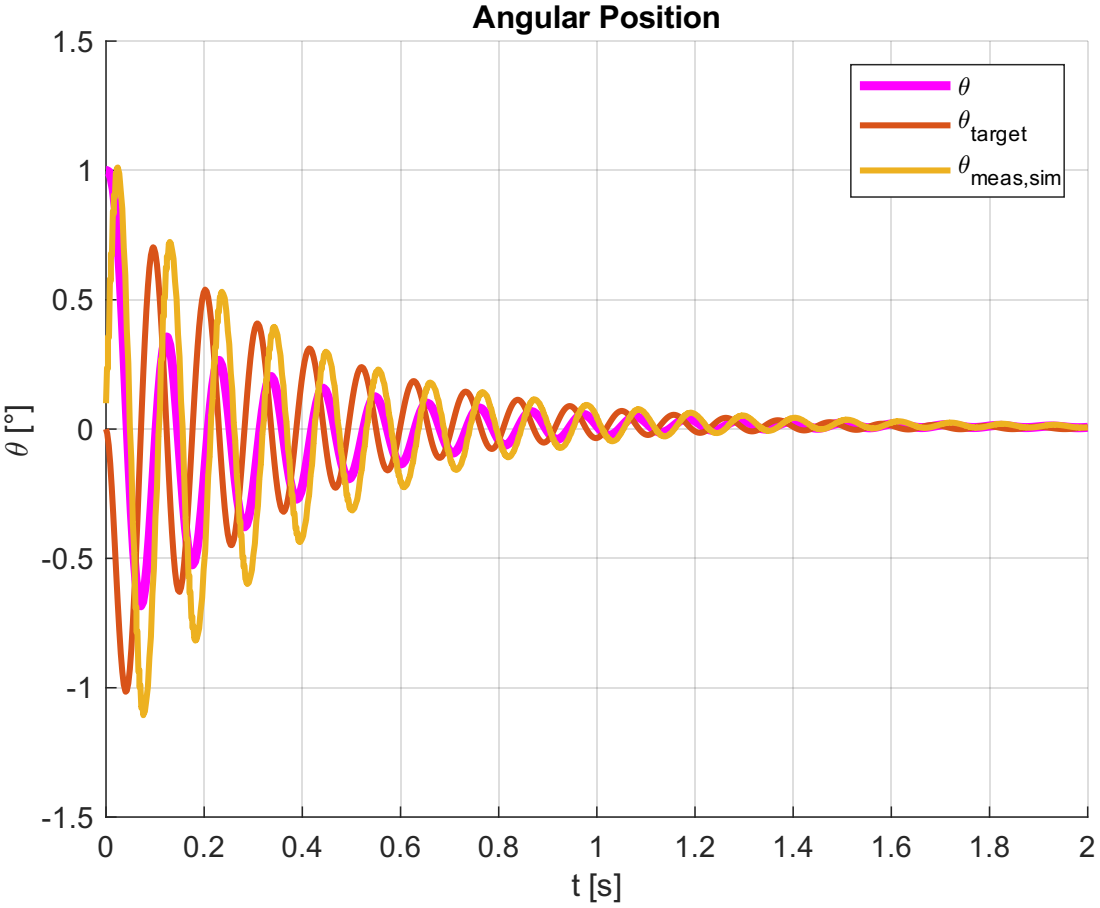
[picture p83: page 1]
Angular Position; target 3meas,sim
