Ding-Jeremy/Self-Balancing-Bot/E_Simulations/Matlab/results/trapez_move_position.pdf

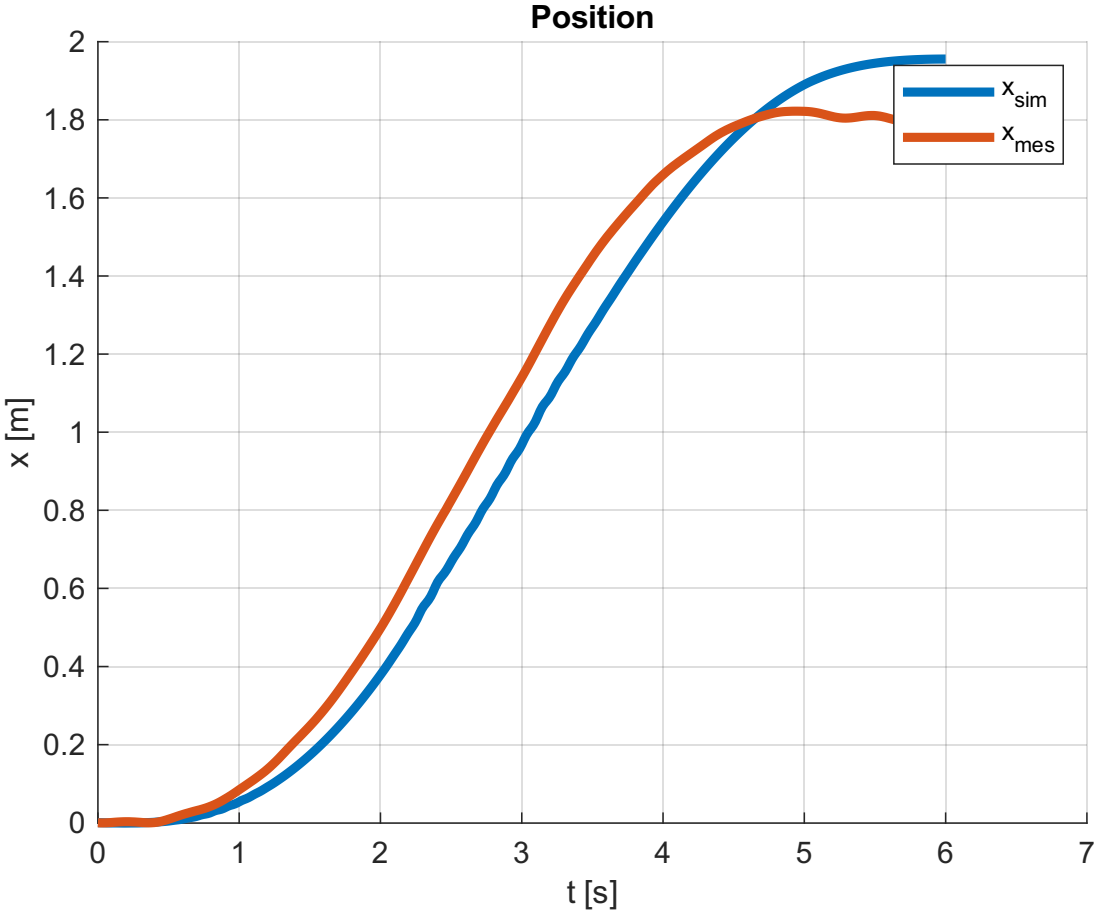
[picture p84: page 1]
sitio

x sim
x m e s
