Ding-Jeremy/Self-Balancing-Bot/E_Simulations/Matlab/results/trapez_move_theta.pdf

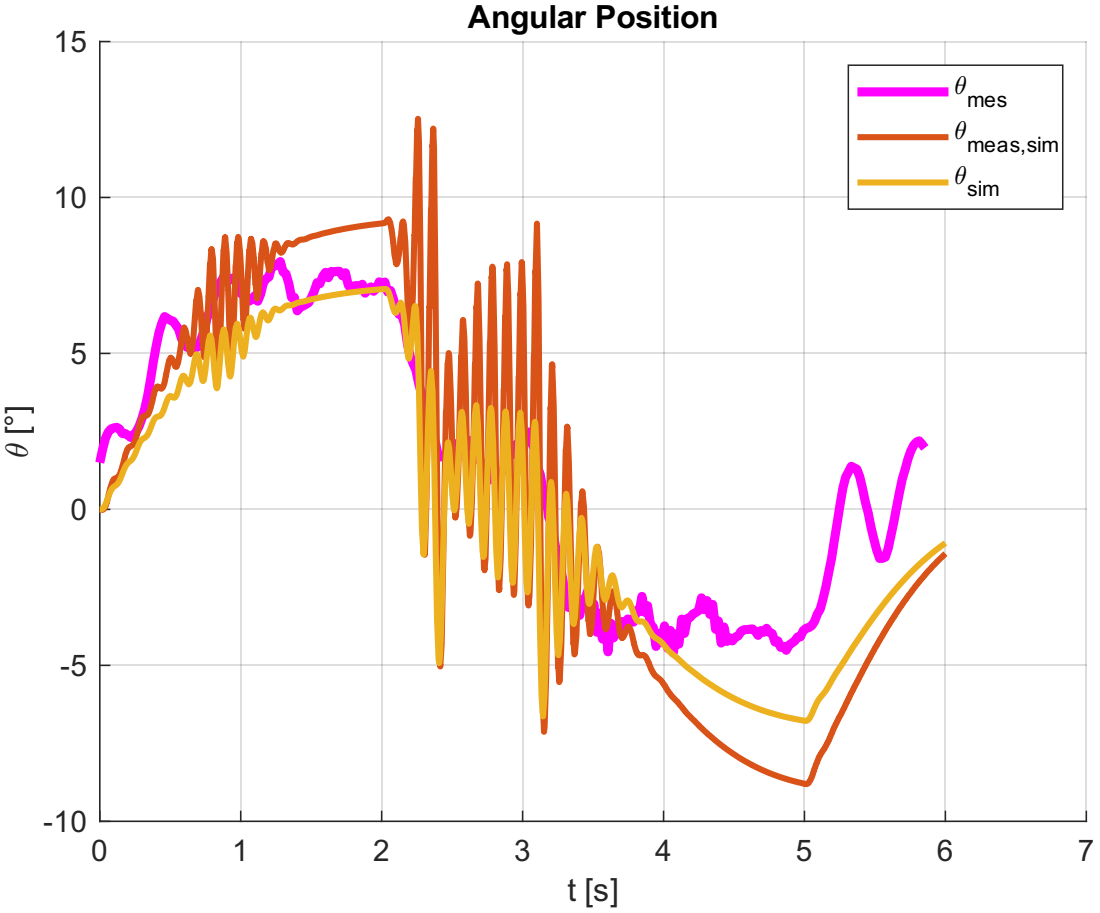
[picture p85: page 1]
Angular Position; 3mes; 3meas,sim; sim
