Ding-Jeremy/Self-Balancing-Bot/E_Simulations/Matlab/results/trapez_move_velocity.pdf

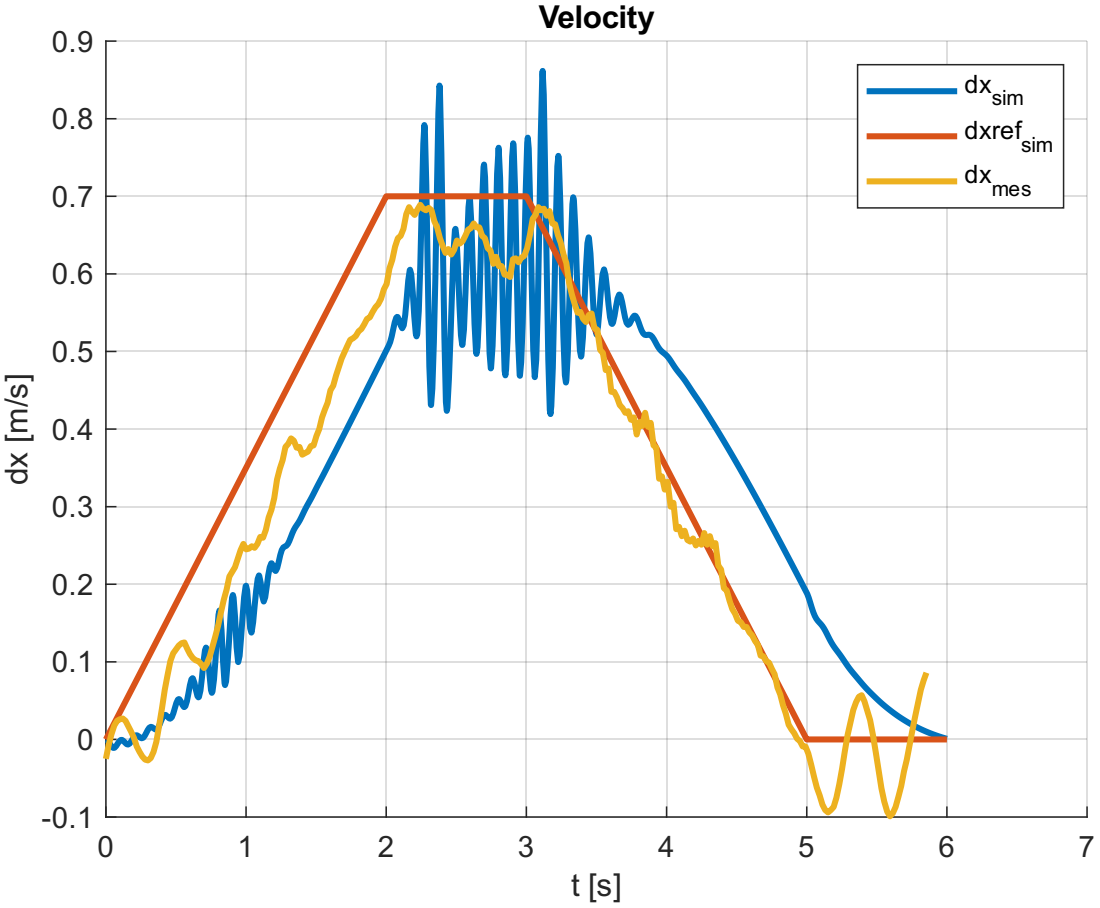
[picture p86: page 1]
Velo; cit

d x sim
d x r e fsim d x m e s
