Ding-Jeremy/Self-Balancing-Bot/E_Simulations/Matlab/results/hold_negative_angle.pdf

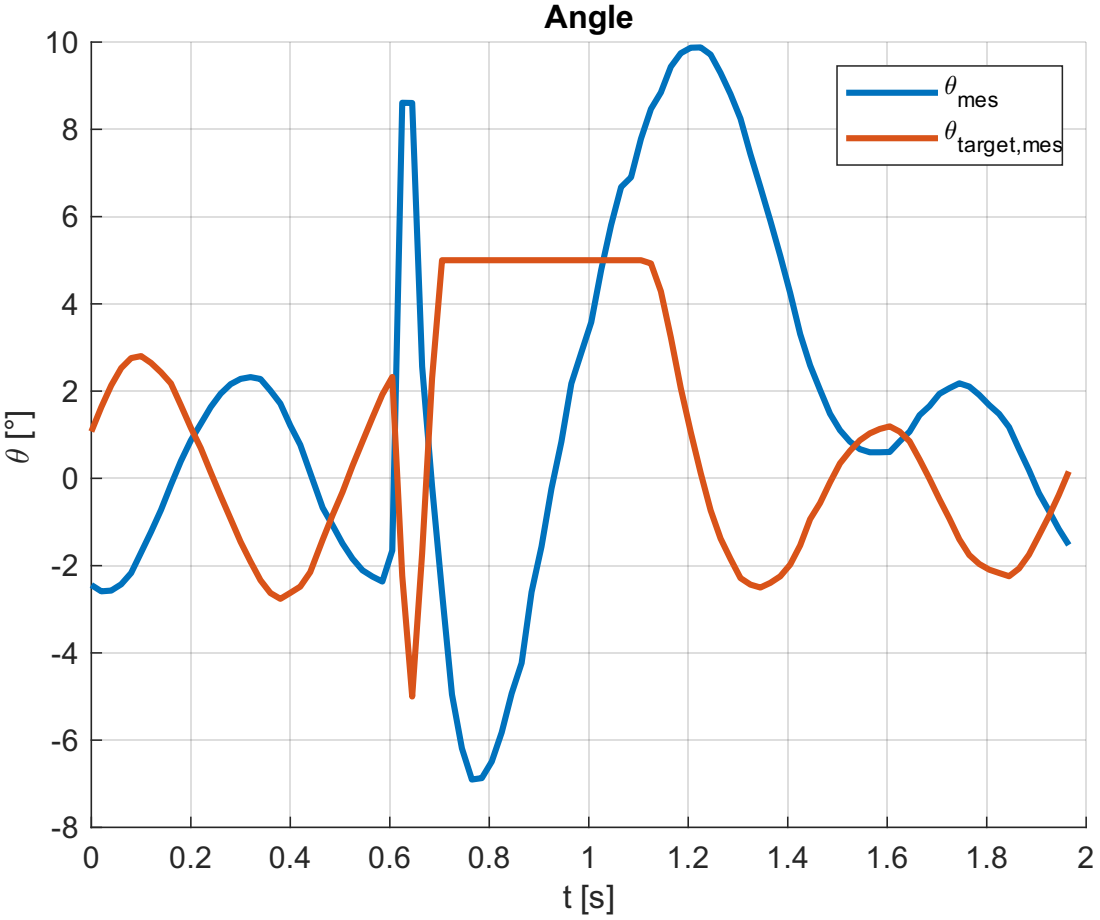
[picture p87: page 1]
Angle

3mes
3 target,mes
