Ding-Jeremy/Self-Balancing-Bot/E_Simulations/Matlab/results/hold_positive_angle.pdf

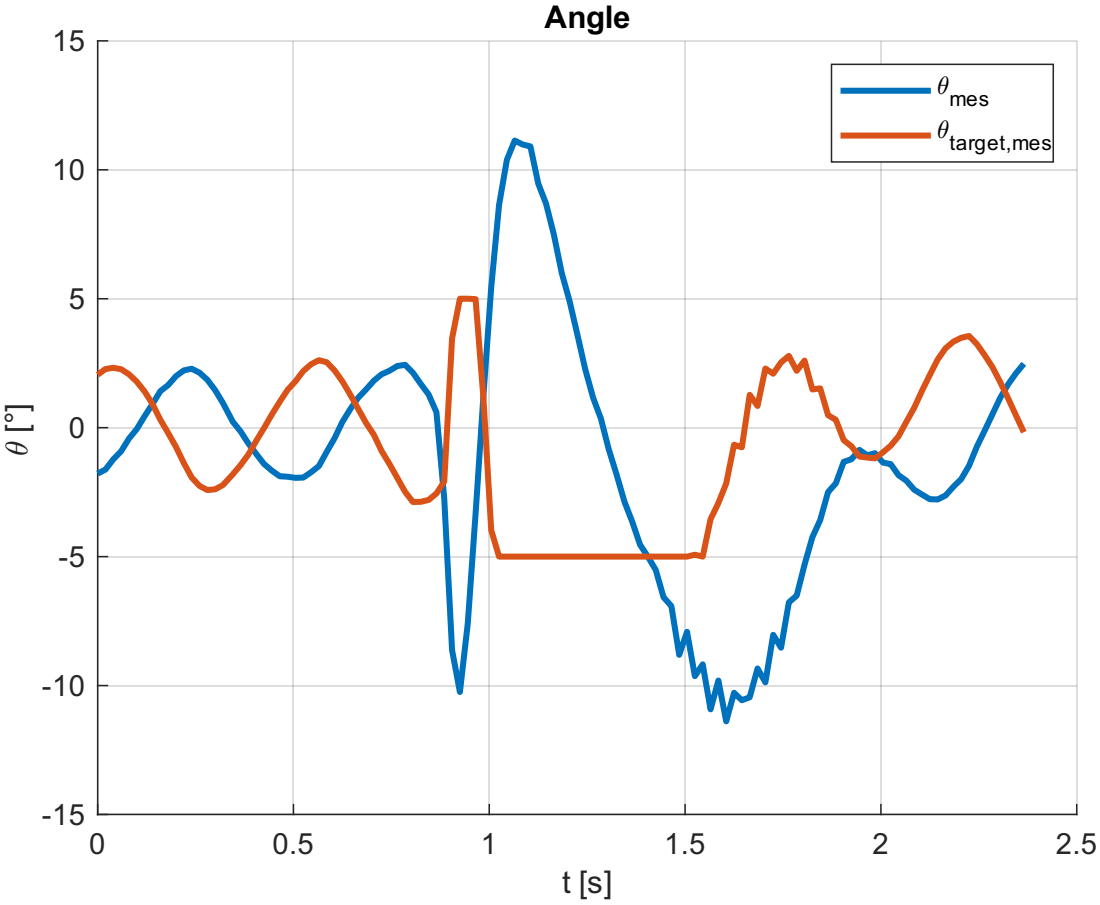
[picture p88: page 1]
gle
