Ding-Jeremy/Self-Balancing-Bot/E_Simulations/Matlab/results/max_angle.pdf

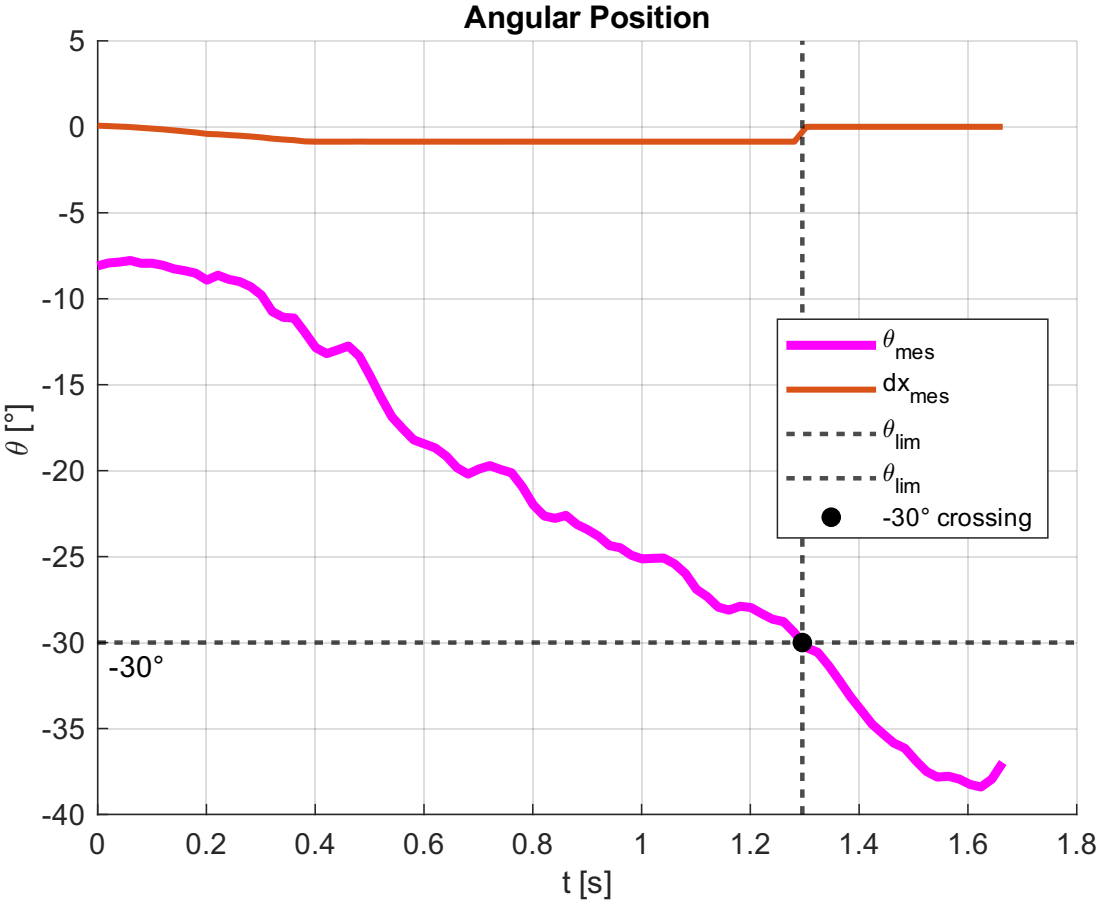
[picture p89: page 1]
Angular Position

3mes dxmes

3 lim
3 lim -30° crossing
