Ding-Jeremy/Self-Balancing-Bot/E_Simulations/Matlab/results/trapez_alu_pla_sim.pdf

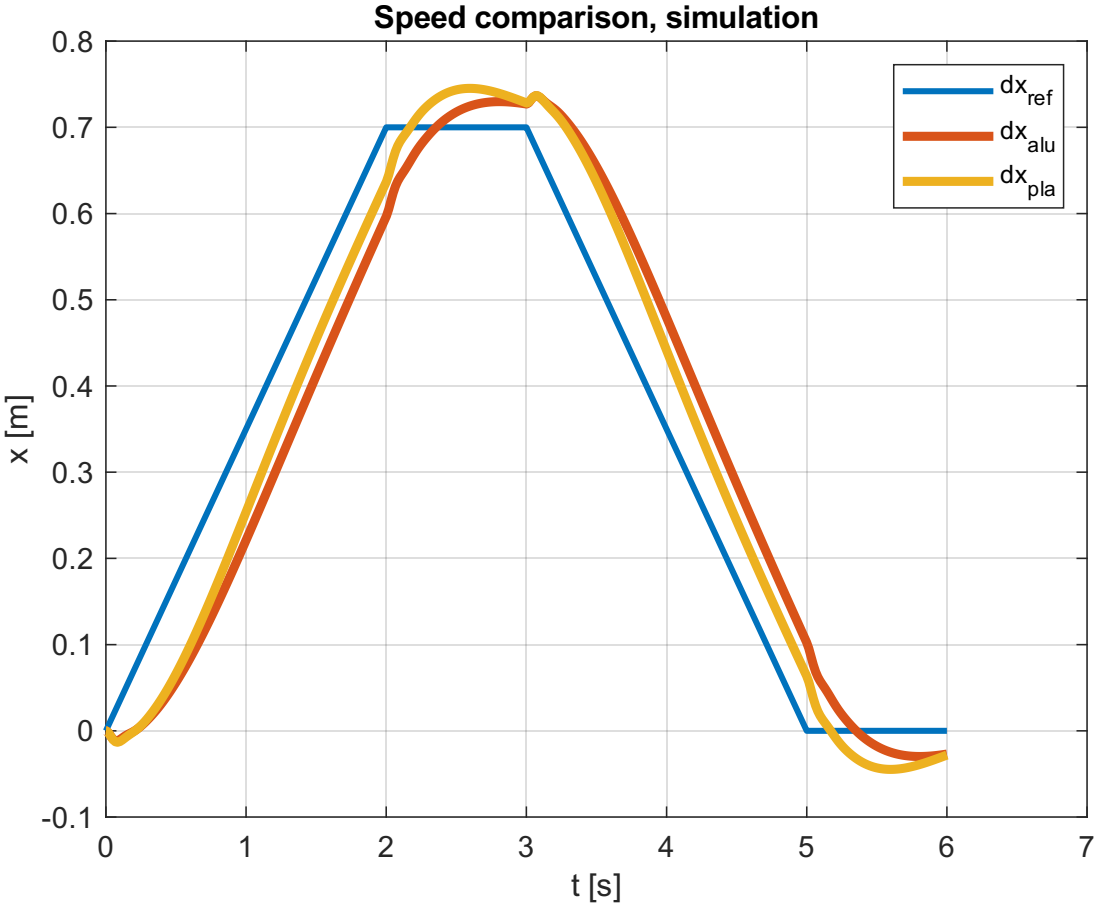
[picture p90: page 1]

Speed comparison, simulation

dx ref dx

alu dx pla
