Ding-Jeremy/Self-Balancing-Bot/E_Simulations/Matlab/results/trapez_mes_alu_pla.pdf

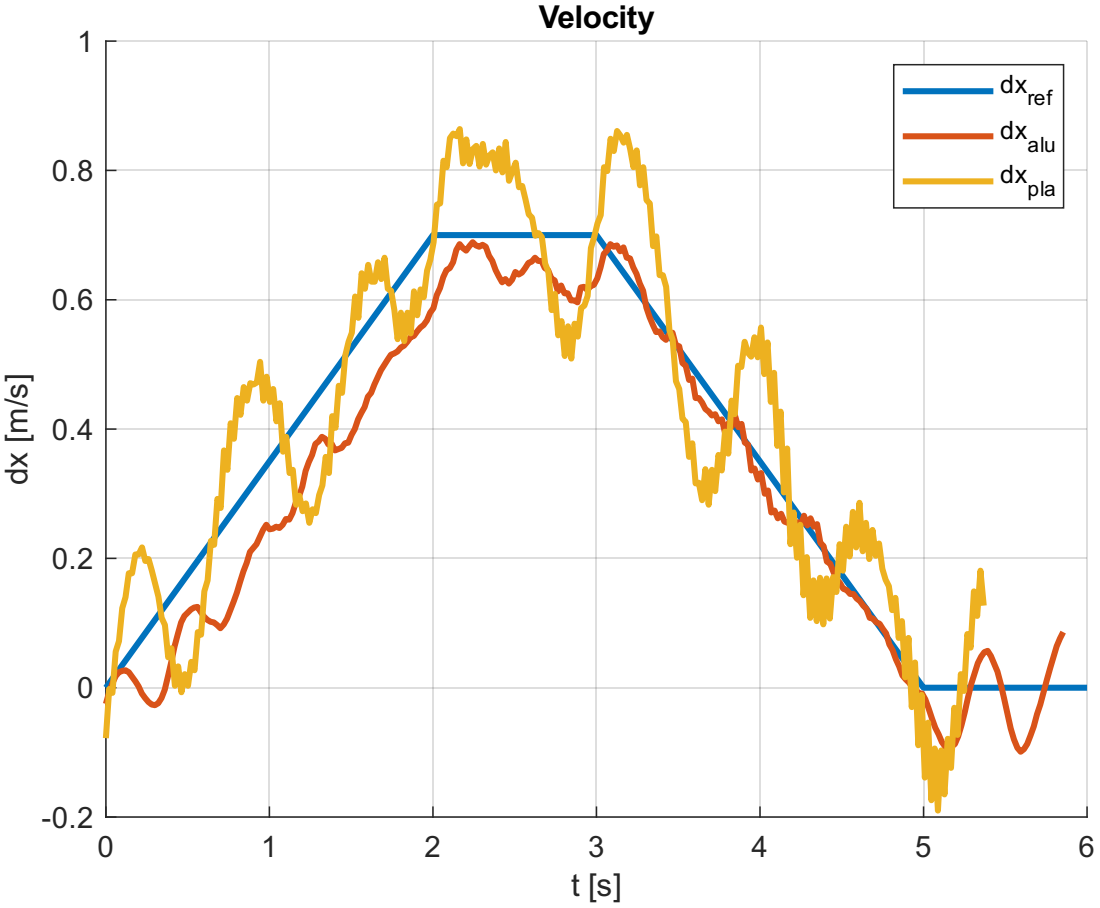
[picture p91: page 1]
Velo; cit

d x re f d x alu

d x pla
