Ding-Jeremy/Self-Balancing-Bot/E_Simulations/Matlab/results/trapez_mes_avg_alu_pla.pdf

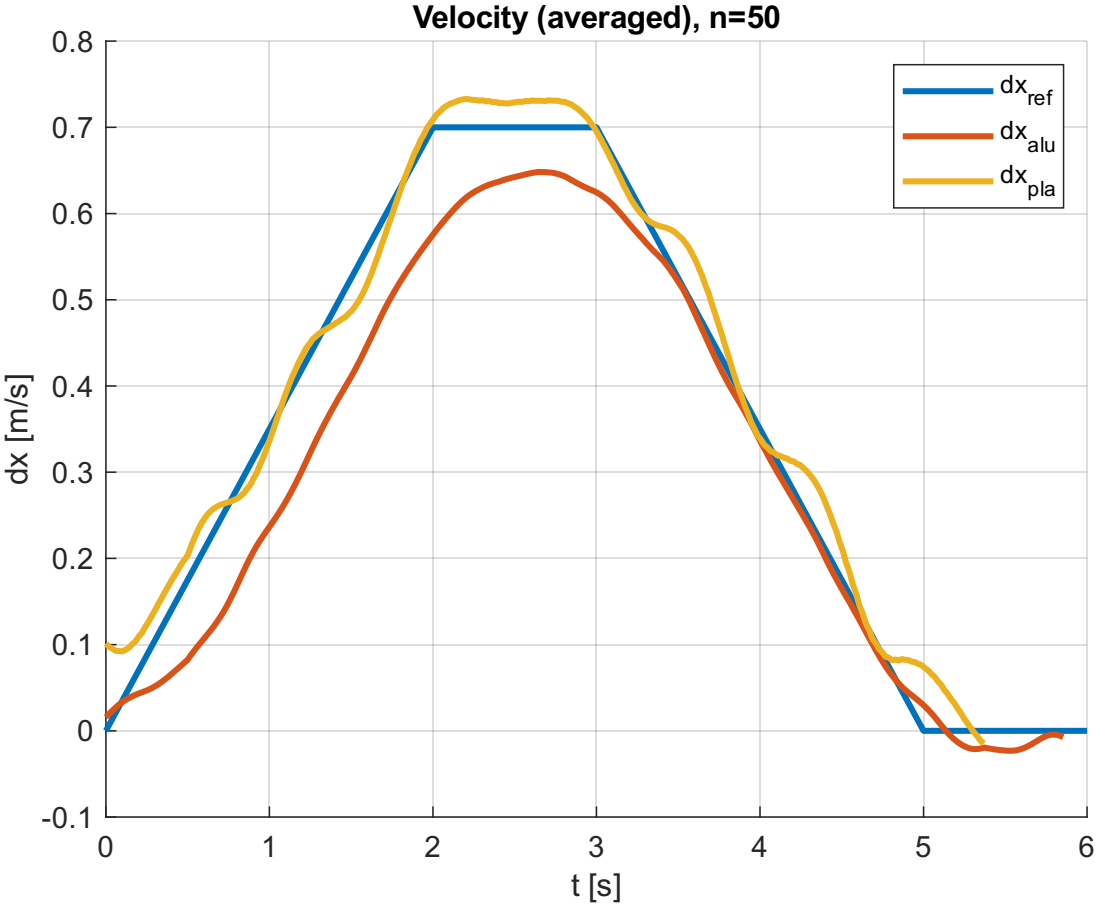
[picture p92: page 1]
Velo; cit

alu d x pla
