Ding-Jeremy/Self-Balancing-Bot/E_Simulations/Matlab/results/imu_position_effect.pdf

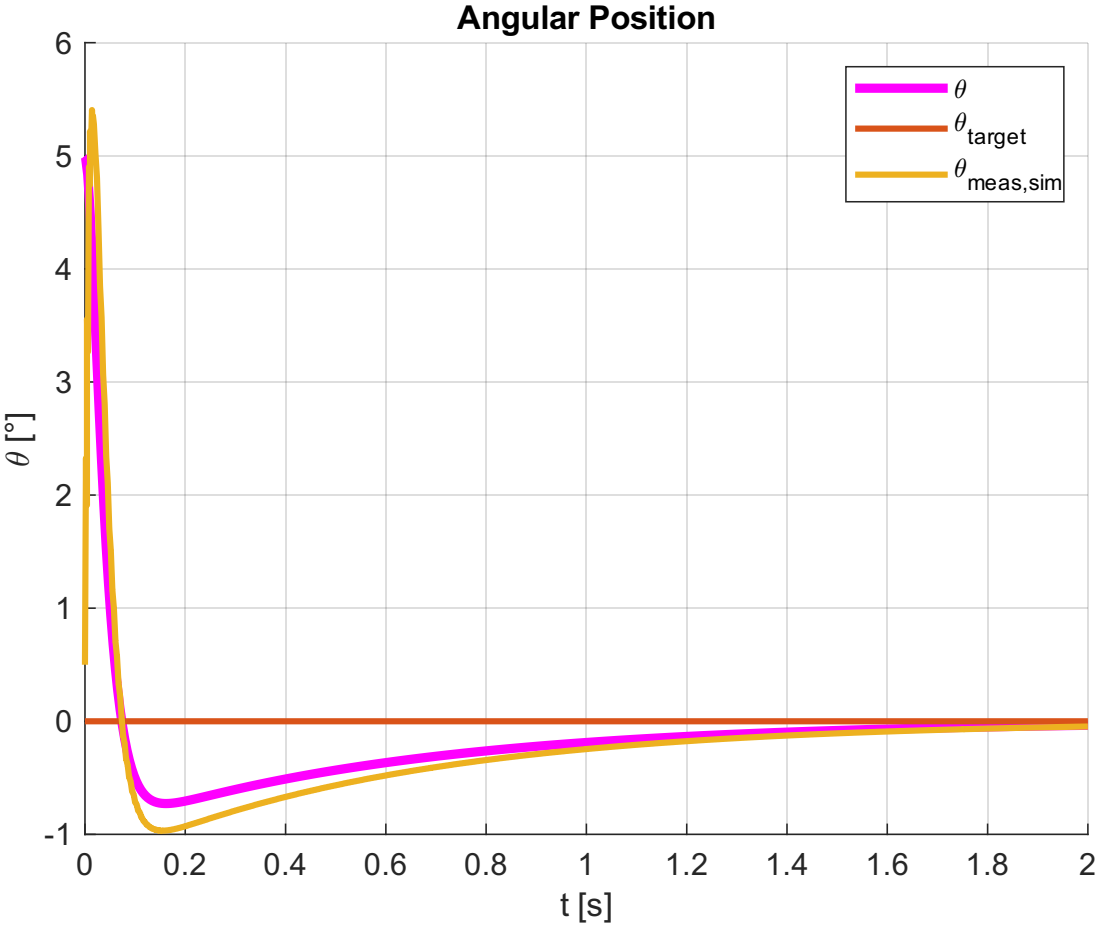
[picture p93: page 1]
Angular Position

3 3 target

3meas,sim
