Ding-Jeremy/Self-Balancing-Bot/E_Simulations/Matlab/results/reg_P_acccel.pdf

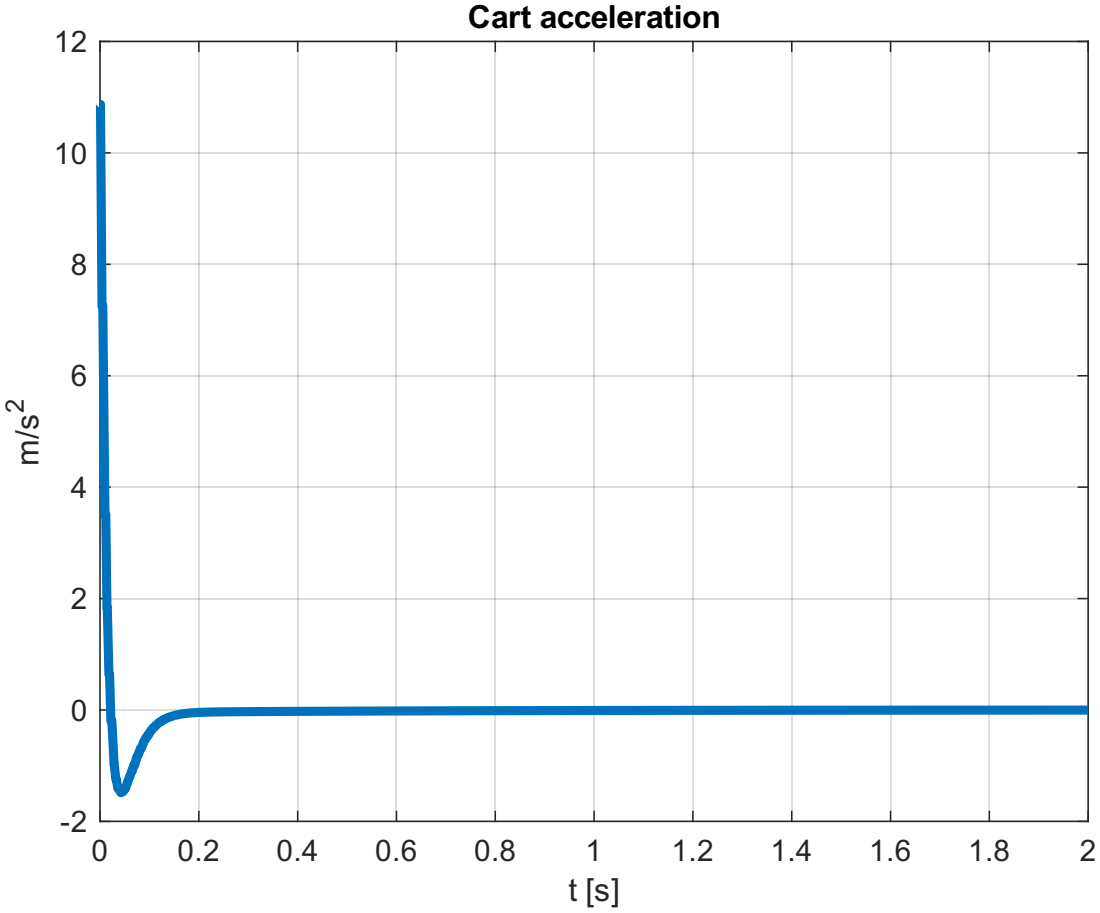
[picture p94: page 1]
Cart acceleration
