Ding-Jeremy/Self-Balancing-Bot/E_Simulations/Matlab/results/reg_P_angles.pdf

Angular Position

3 3 target

3meas,sim
