Ding-Jeremy/Self-Balancing-Bot/E_Simulations/Matlab/results/reg_PD_acccel.pdf

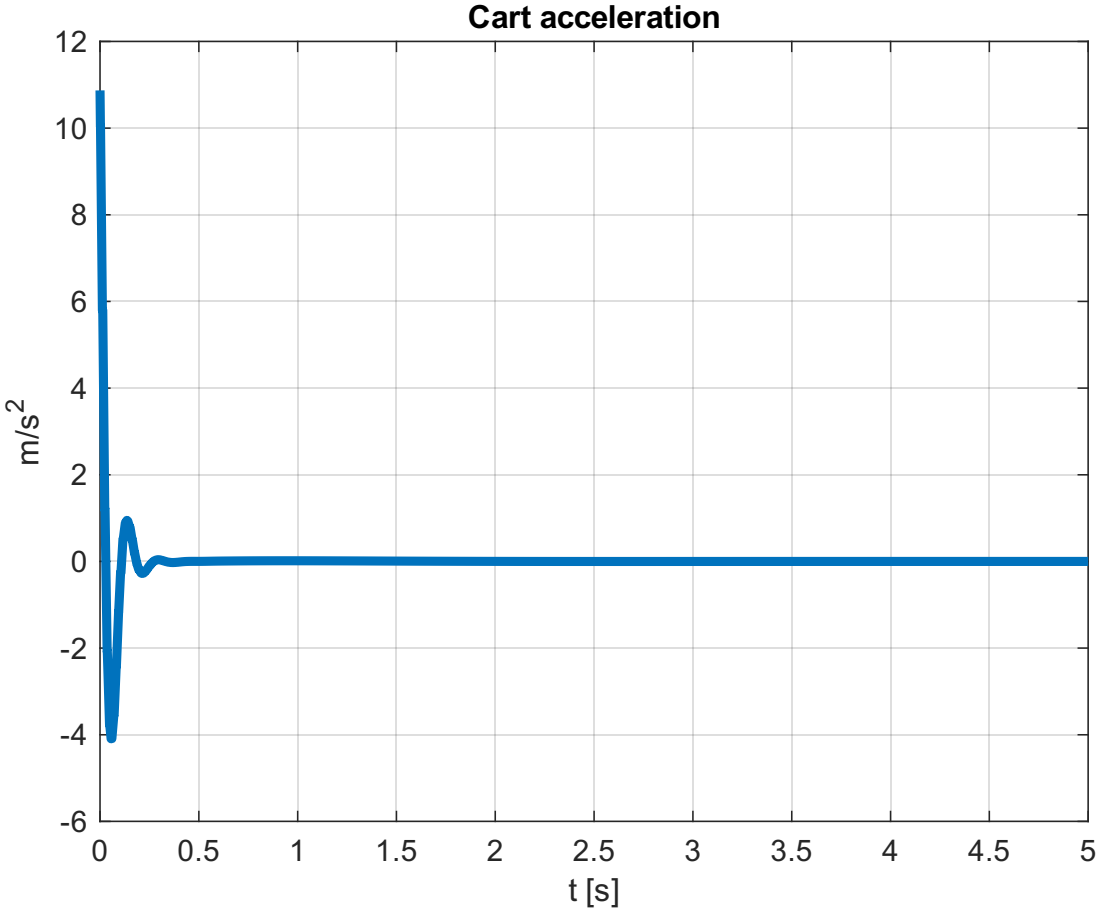
[picture p95: page 1]
Cart acceleration
