Ding-Jeremy/Self-Balancing-Bot/E_Simulations/Matlab/results/reg_PD_angles.pdf

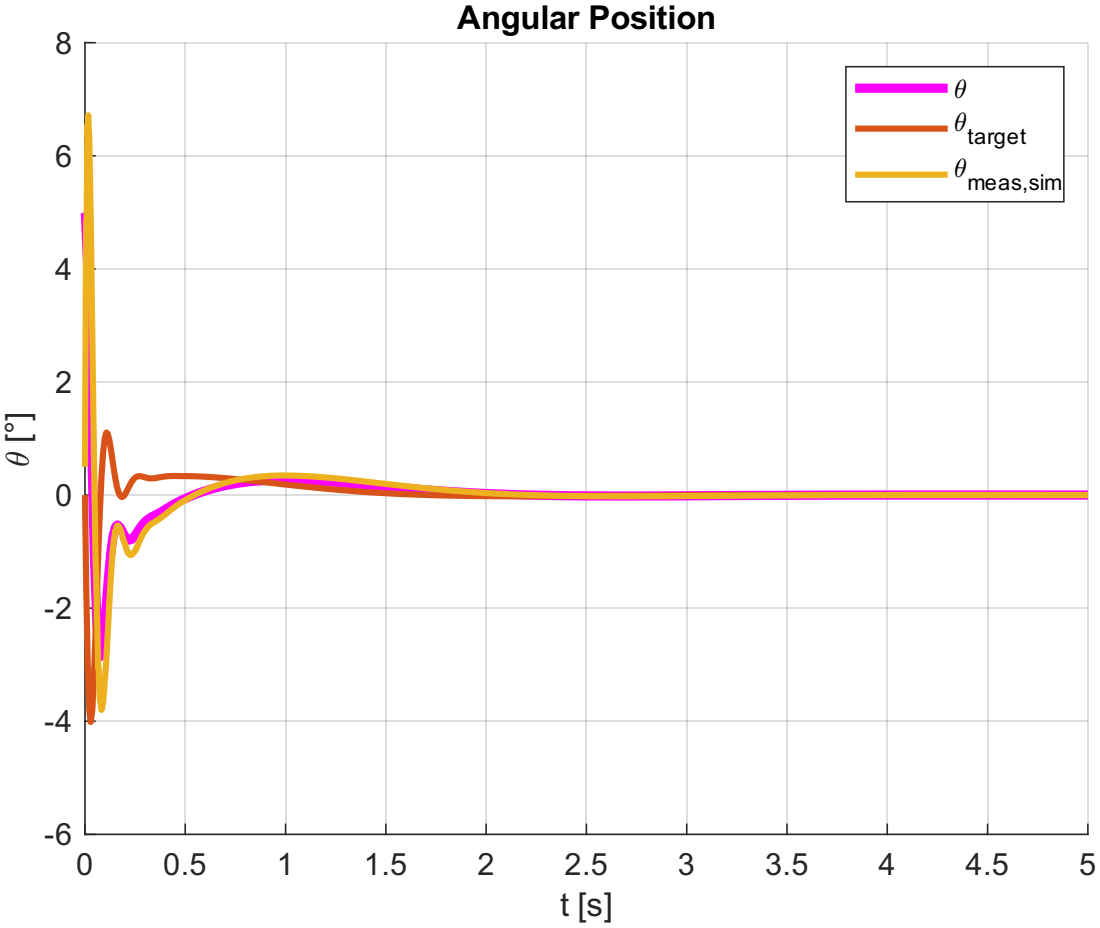
[picture p96: page 1]
Angular Position

3 3 target

3meas,sim
