Ding-Jeremy/Self-Balancing-Bot/E_Simulations/Matlab/results/free_fall_negative.pdf

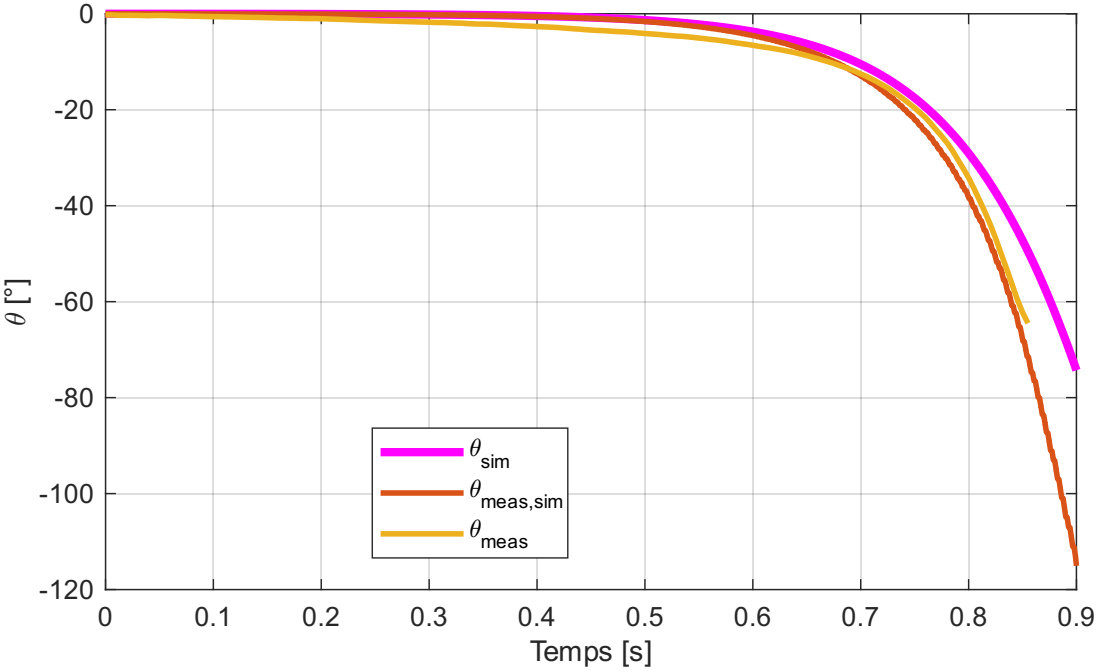
[picture p97: page 1]
Temps [s]

3 sim 3meas,sim

3meas
