Ding-Jeremy/Self-Balancing-Bot/E_Simulations/Matlab/results/free_fall_positive.pdf

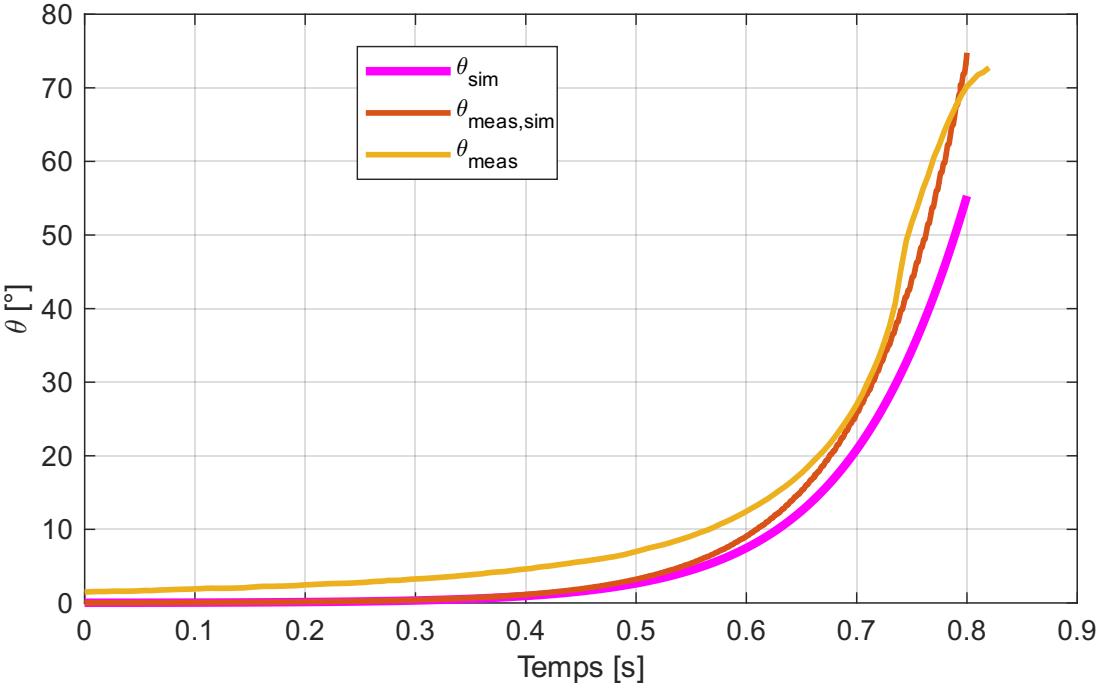
[picture p98: page 1]

3 sim
3 m e a s,sim 3 m e a s
