Ding-Jeremy/Self-Balancing-Bot/A_Documentation/Rapport/assets/figures/signature.pdf

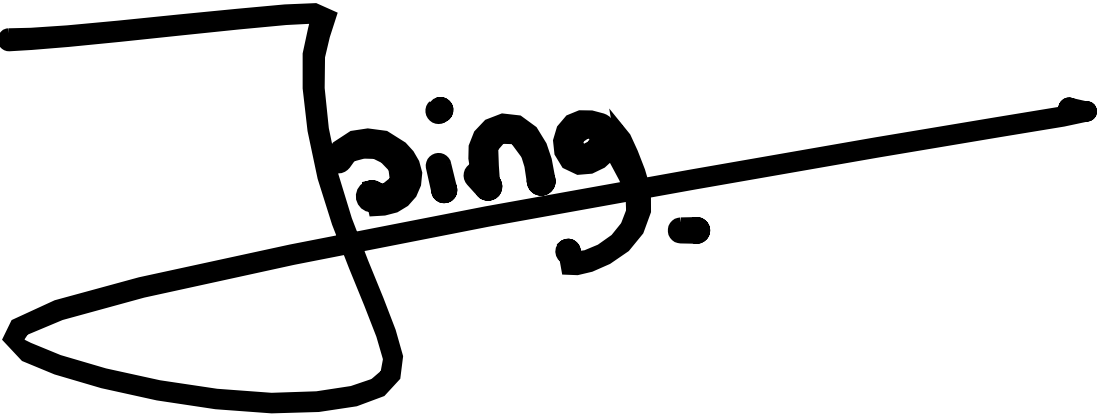
[picture p99: page 1]
