Ding-Jeremy/Self-Balancing-Bot/A_Documentation/Rapport/assets/annexes/kicad_pcb_bcu.pdf

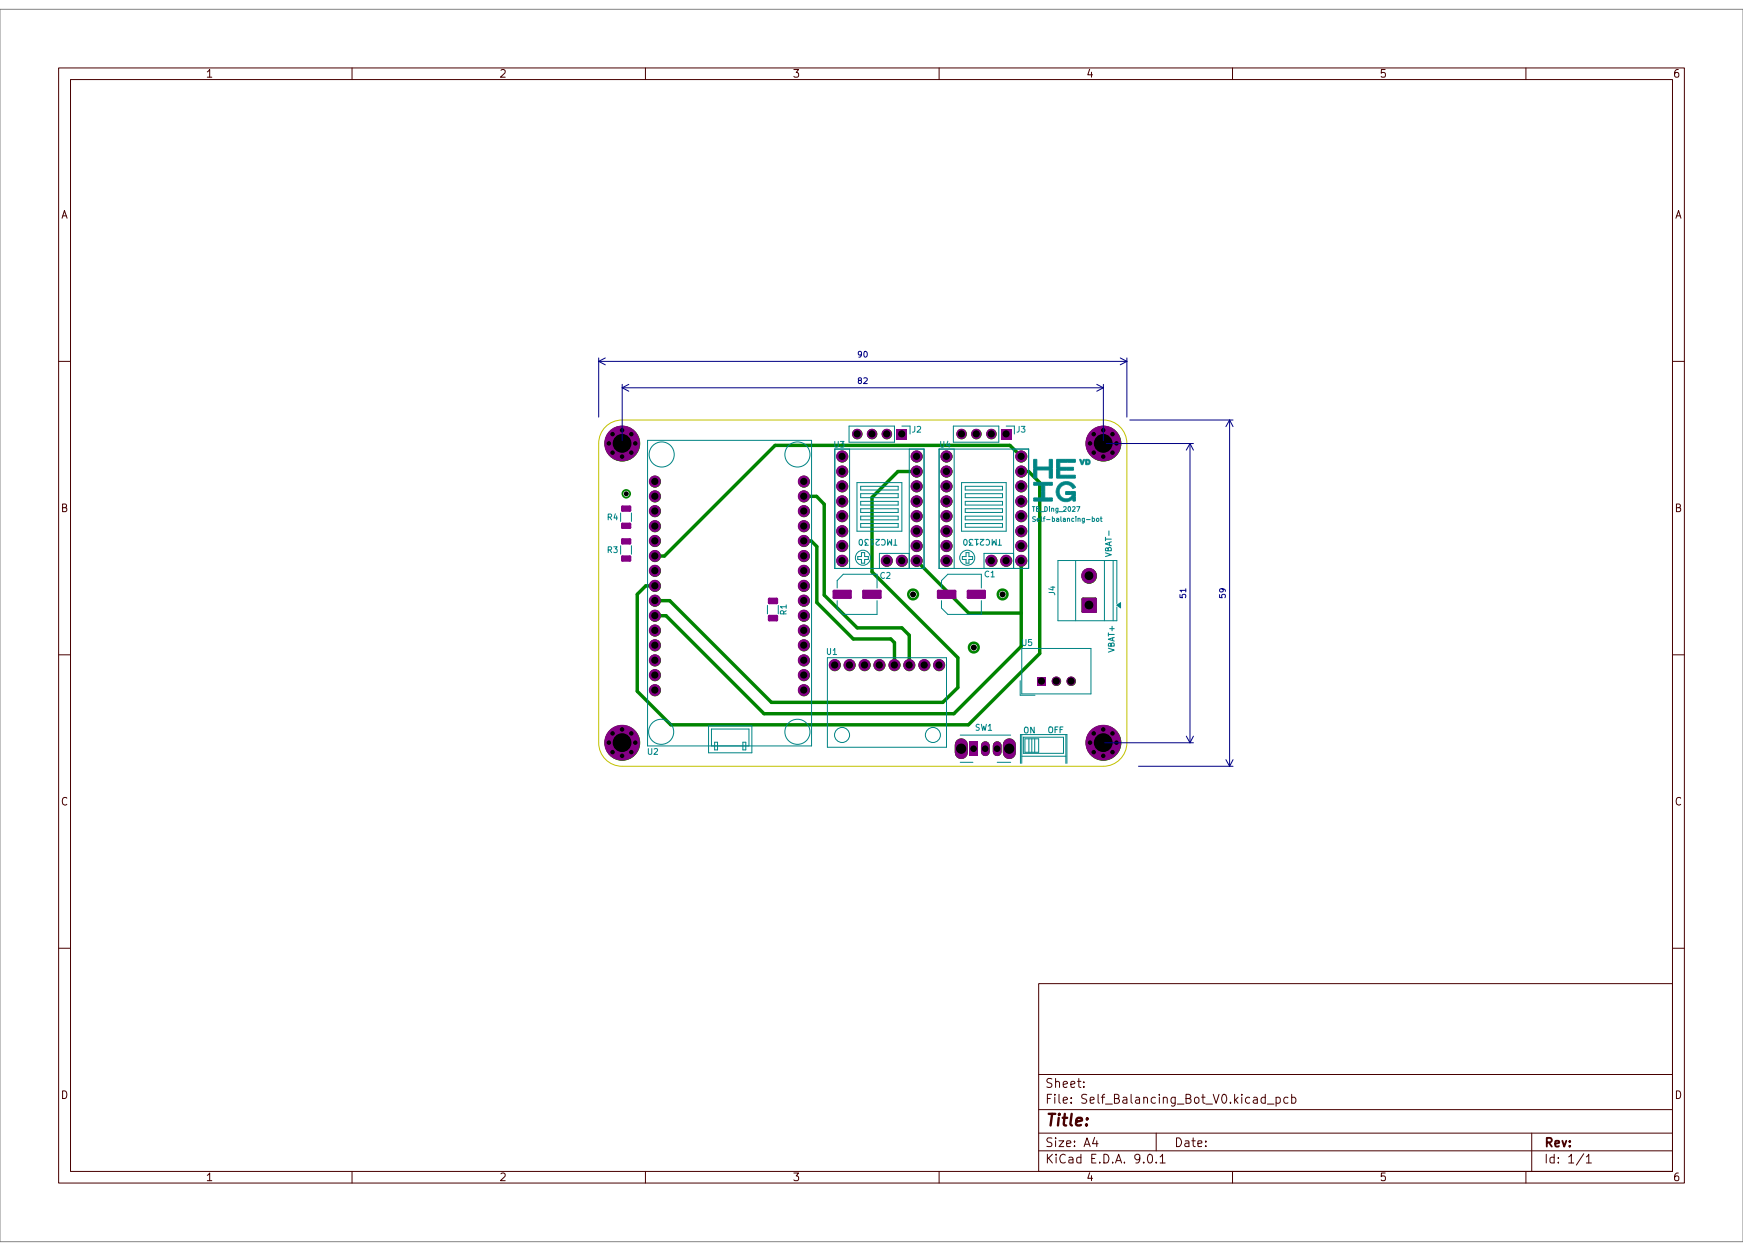
[picture p100: page 1]
