Ding-Jeremy/Self-Balancing-Bot/A_Documentation/Rapport/assets/annexes/kicad_pcb_fcu.pdf

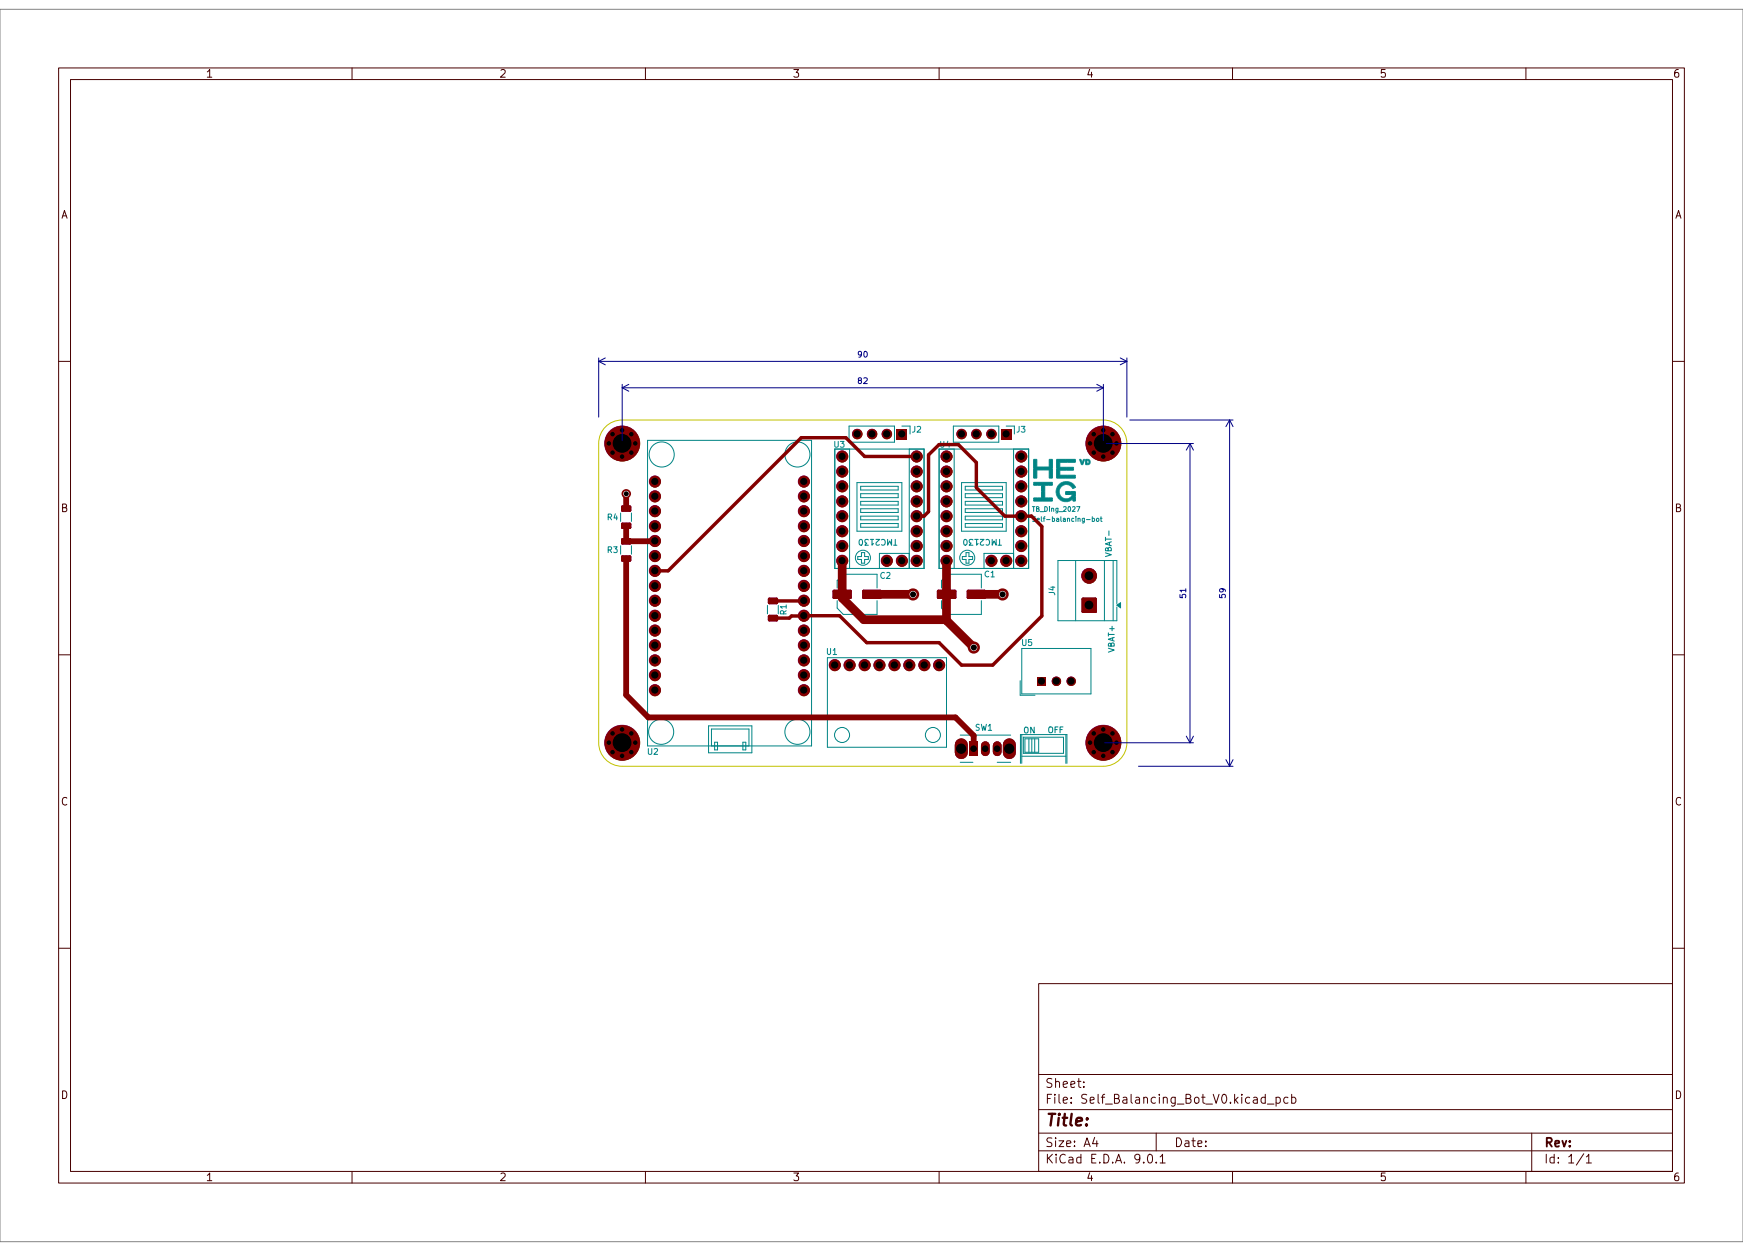
[picture p101: page 1]
