Ding-Jeremy/Self-Balancing-Bot/A_Documentation/Rapport/assets/annexes/kicad_pcb_in1cu.pdf

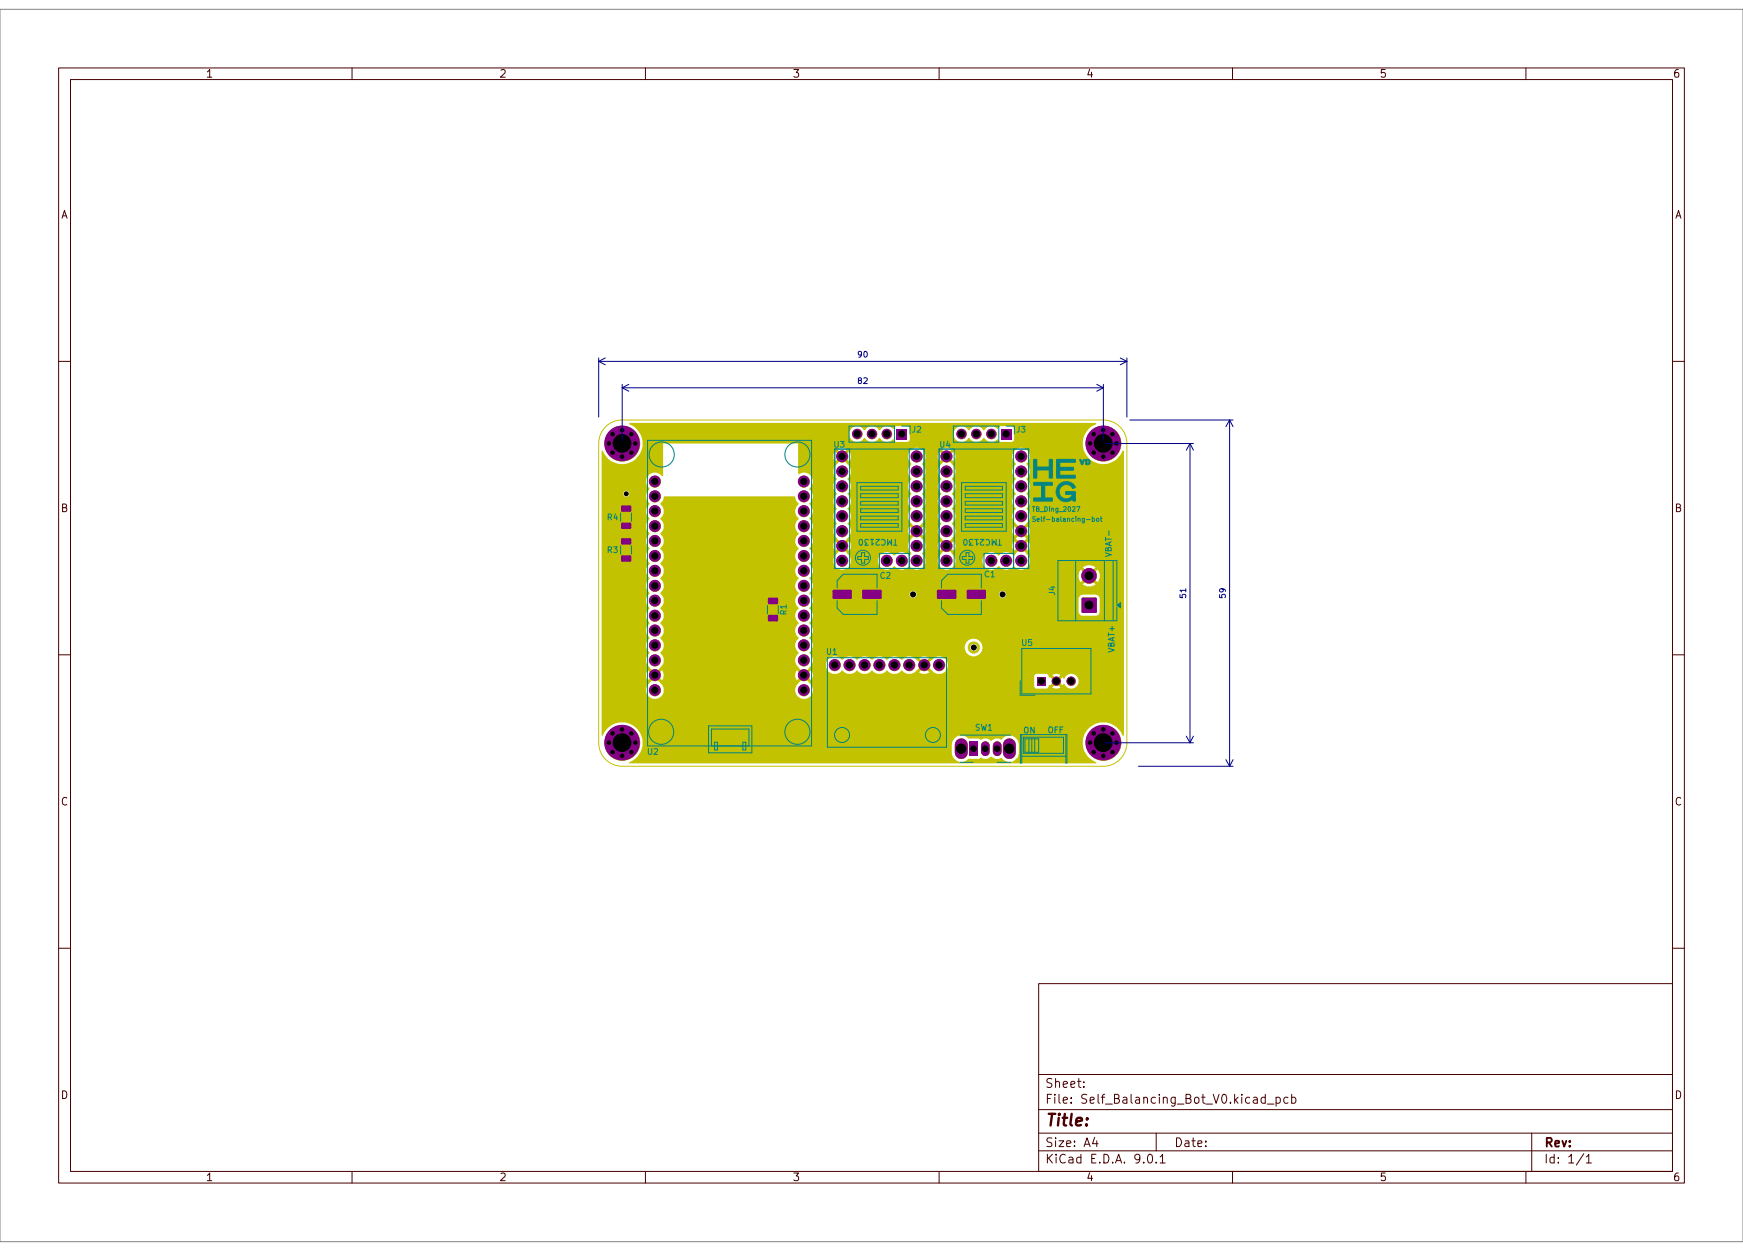
[picture p102: page 1]
