Ding-Jeremy/Self-Balancing-Bot/A_Documentation/Rapport/assets/annexes/kicad_pcb_in2cu.pdf

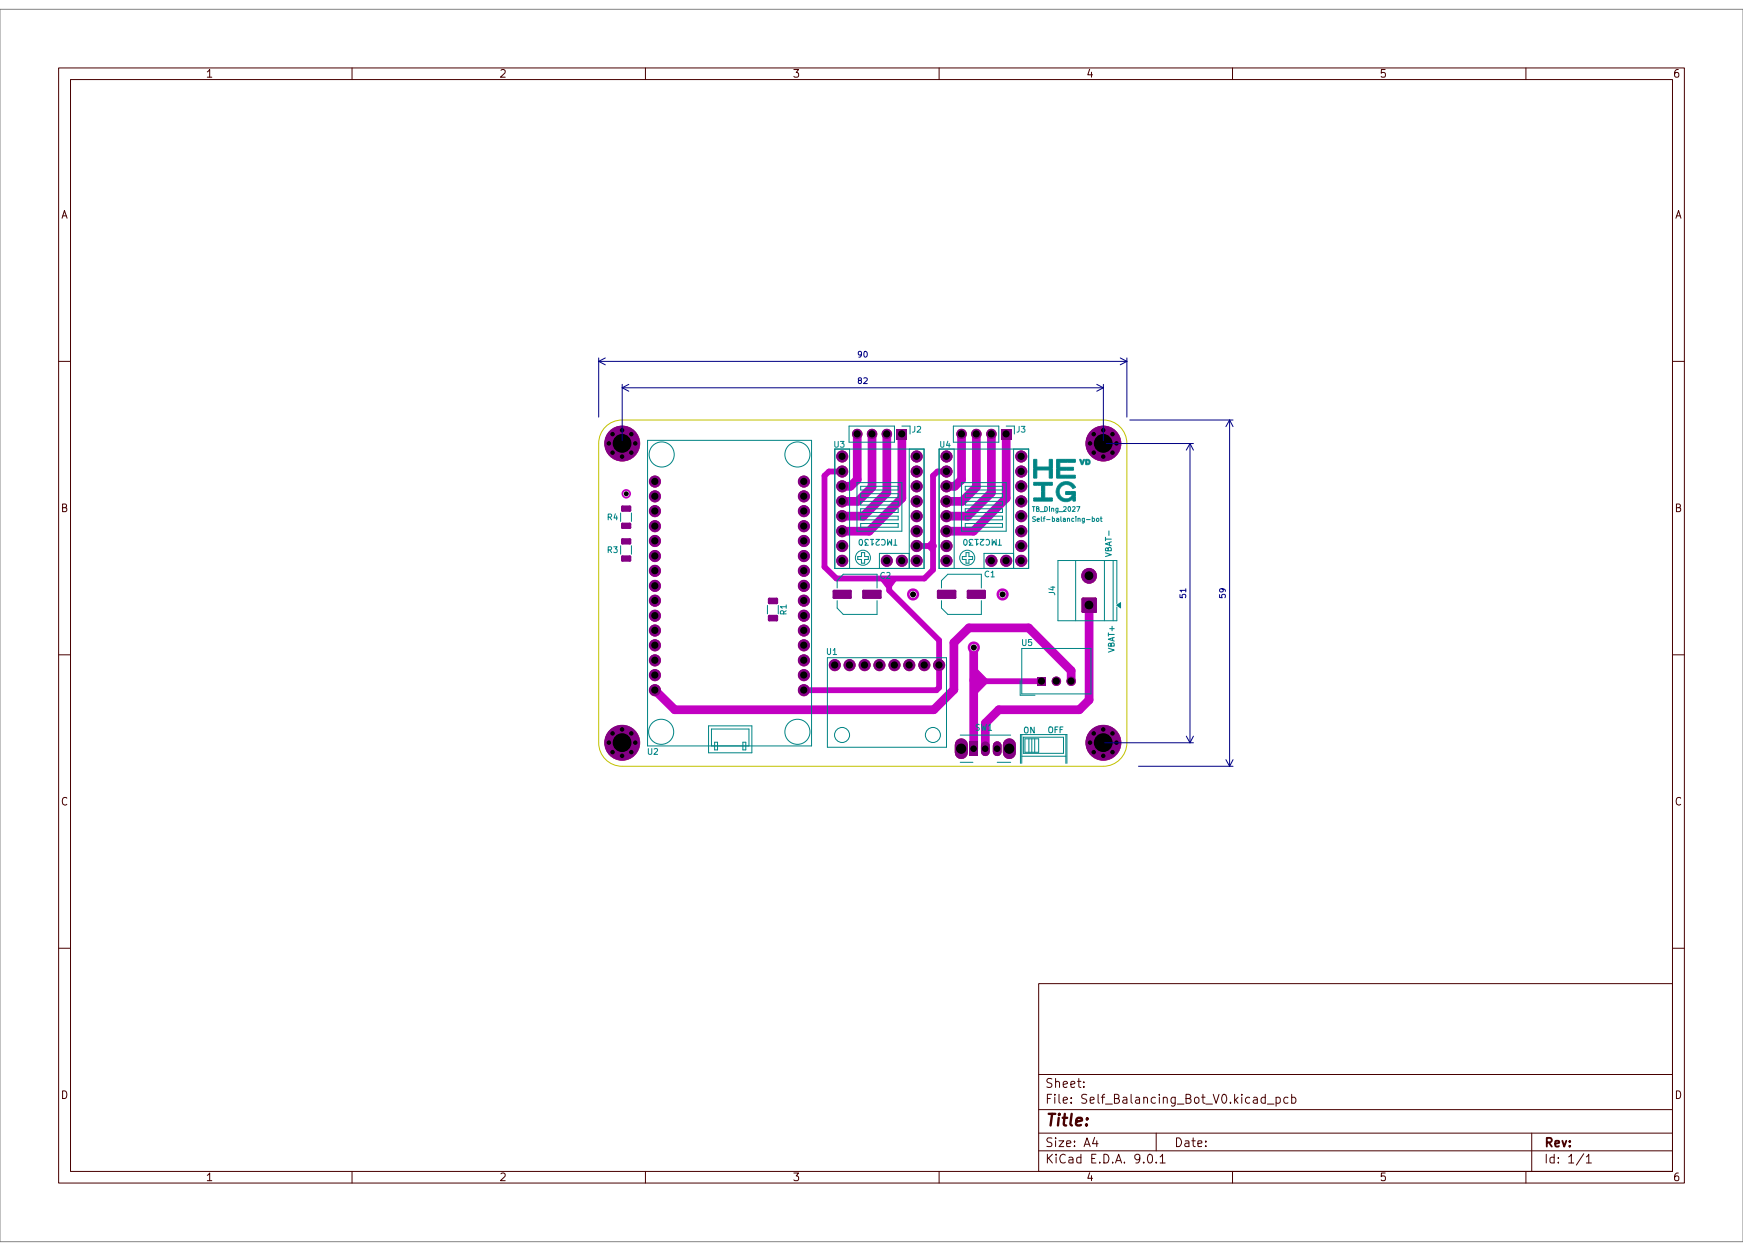
[picture p103: page 1]
