Ding-Jeremy/Self-Balancing-Bot/A_Documentation/Rapport/assets/annexes/kicad_schematic.pdf

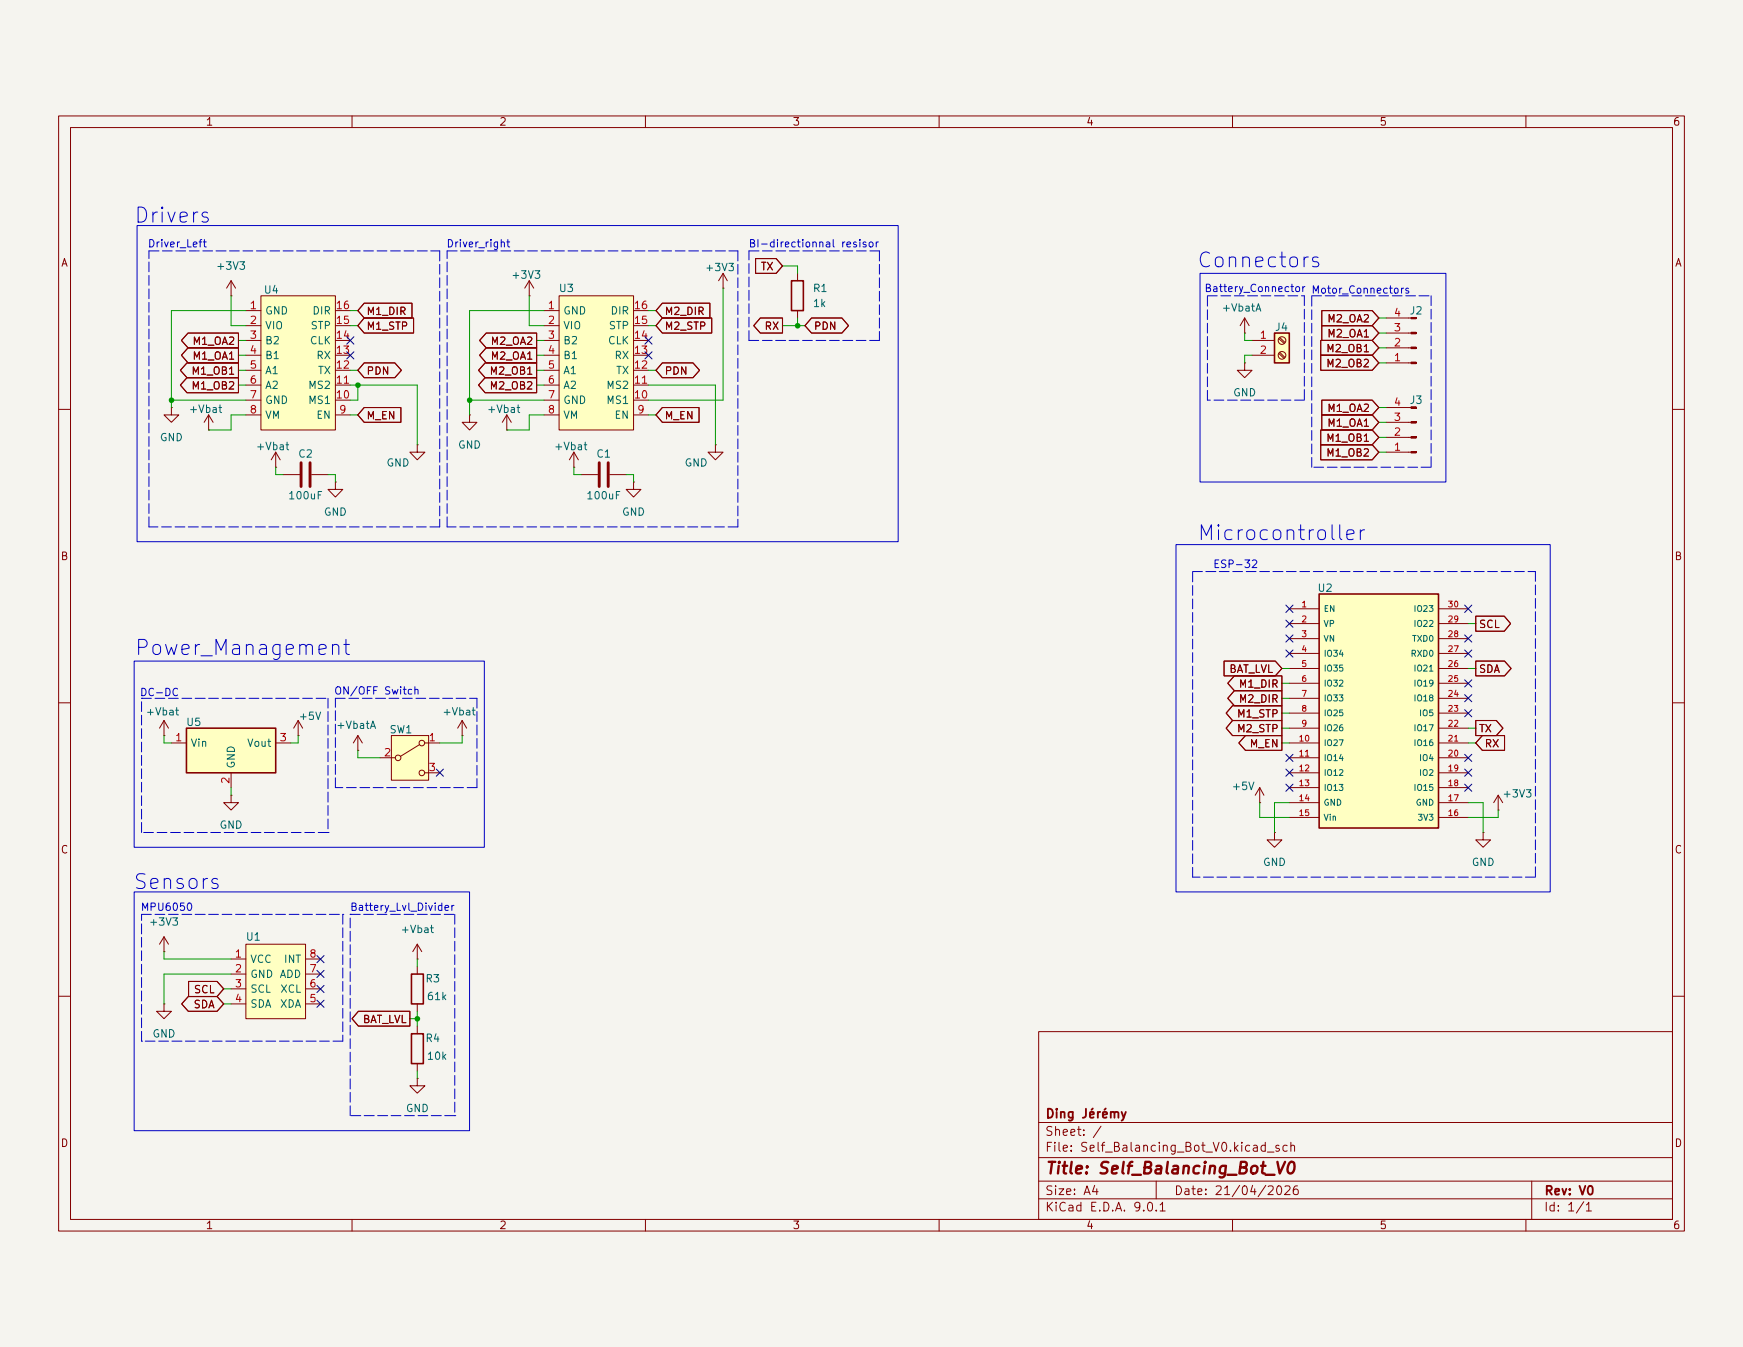
[picture p104: page 1]
