Ding-Jeremy/Self-Balancing-Bot/A_Documentation/Rapport/assets/figures/graphs/acceleration_misalign_com.pdf

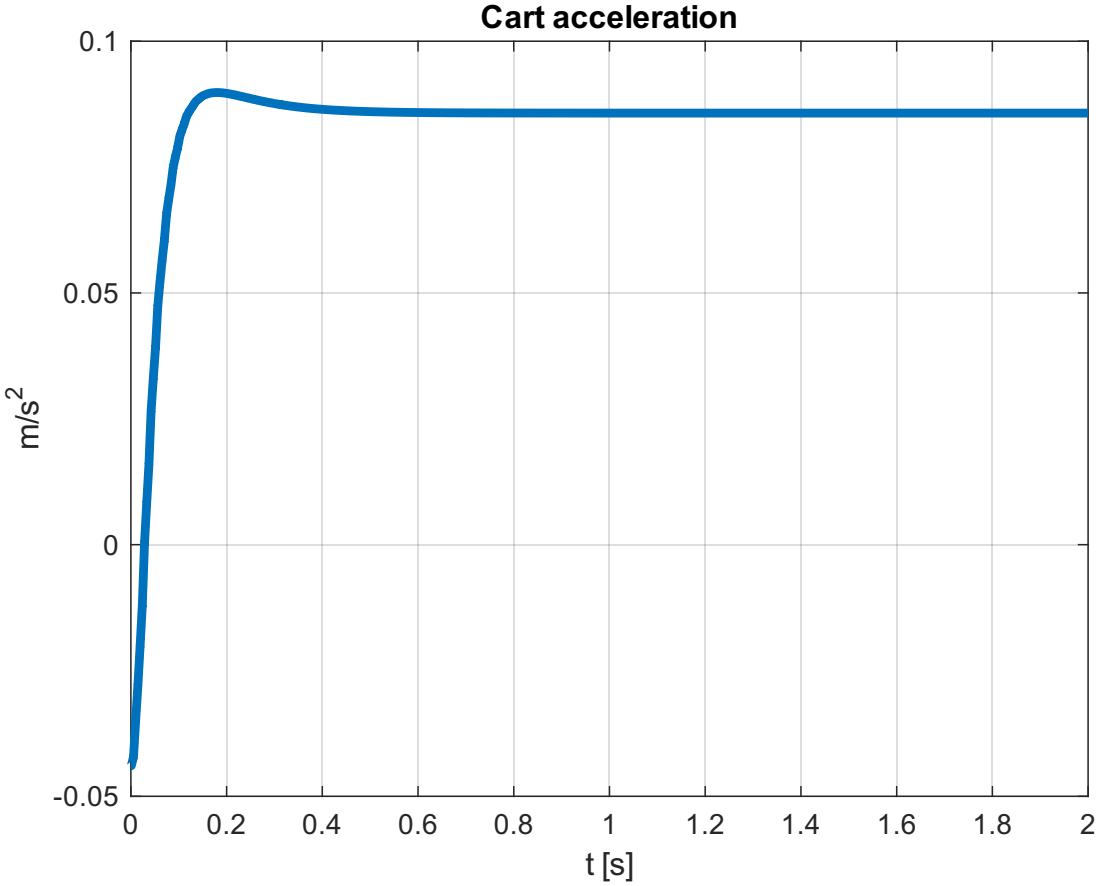
[picture p105: page 1]
Cart acceleration
