Ding-Jeremy/Self-Balancing-Bot/A_Documentation/Rapport/assets/figures/graphs/position_misalign_com.pdf

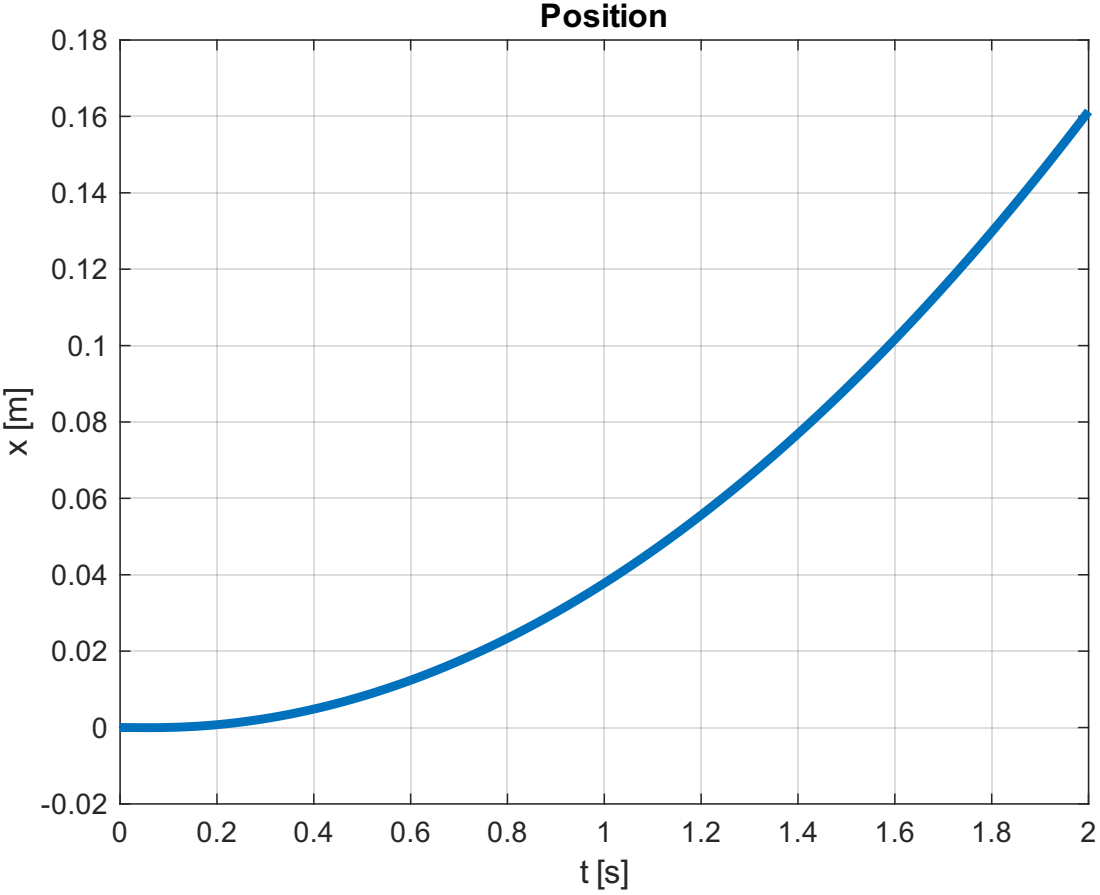
[picture p106: page 1]
Position
