Ding-Jeremy/Self-Balancing-Bot/A_Documentation/Rapport/assets/figures/graphs/reg_ALL_acccel.pdf

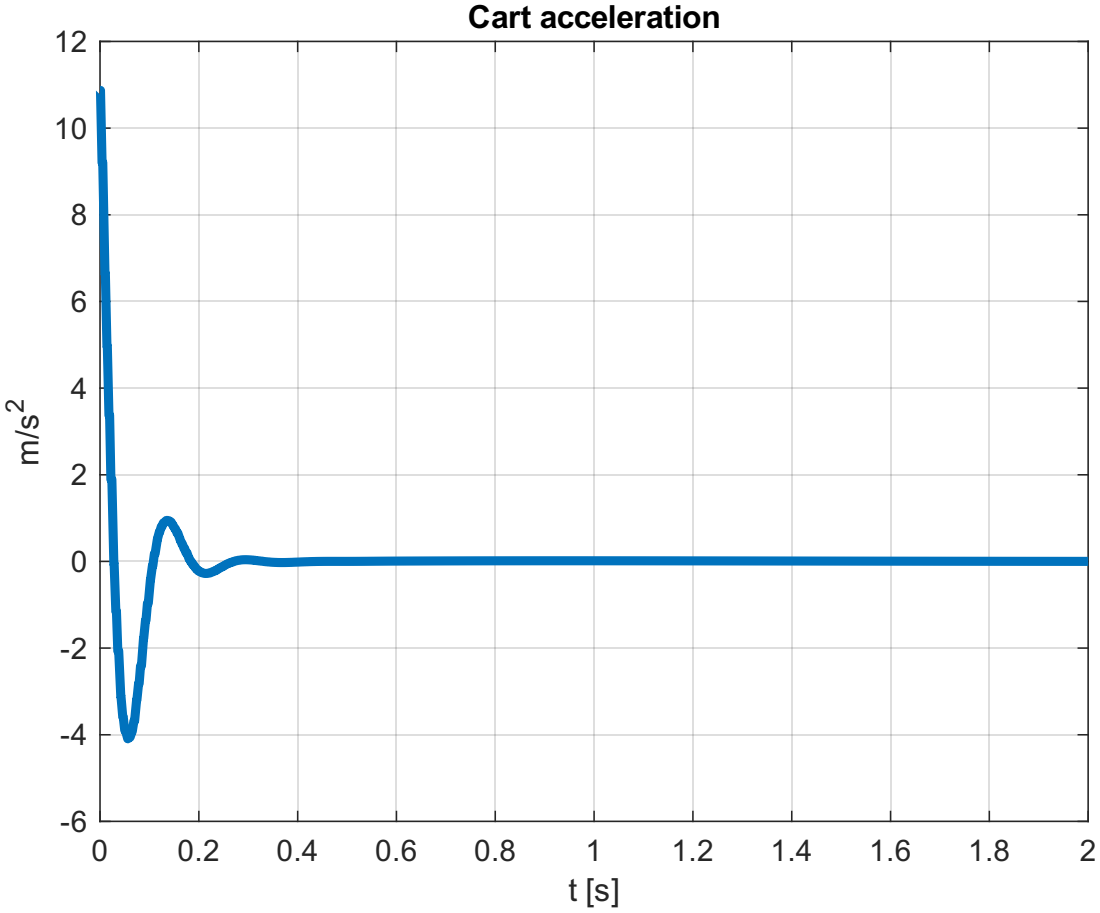
[picture p107: page 1]
Cart acceleration
