Ding-Jeremy/Self-Balancing-Bot/A_Documentation/Rapport/assets/figures/graphs/reg_ALL_angles.pdf

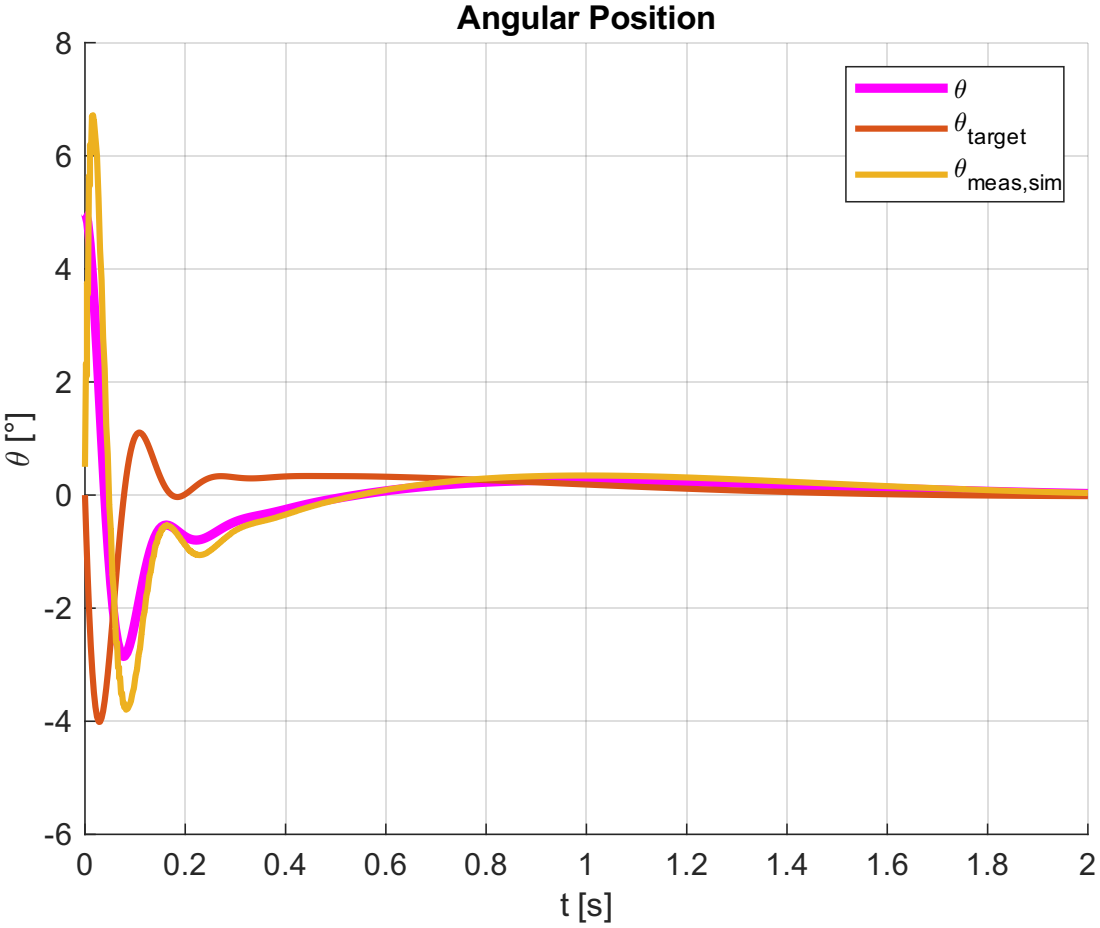
[picture p108: page 1]
Angular Position

3 3 target

3meas,sim
