Ding-Jeremy/Self-Balancing-Bot/A_Documentation/Rapport/assets/figures/graphs/reg_P_acccel.pdf

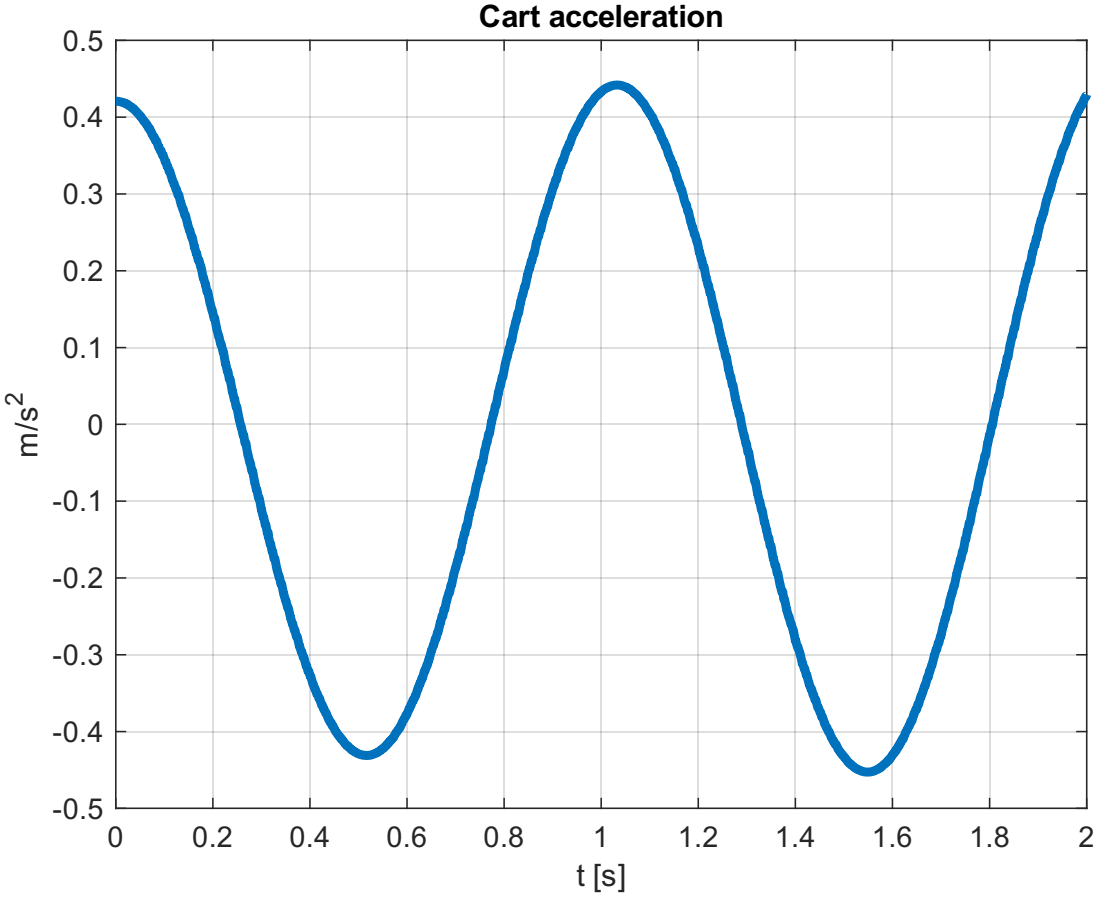
[picture p109: page 1]
Cart acceleration
