Ding-Jeremy/Self-Balancing-Bot/A_Documentation/Rapport/assets/figures/graphs/reg_P_angles.pdf

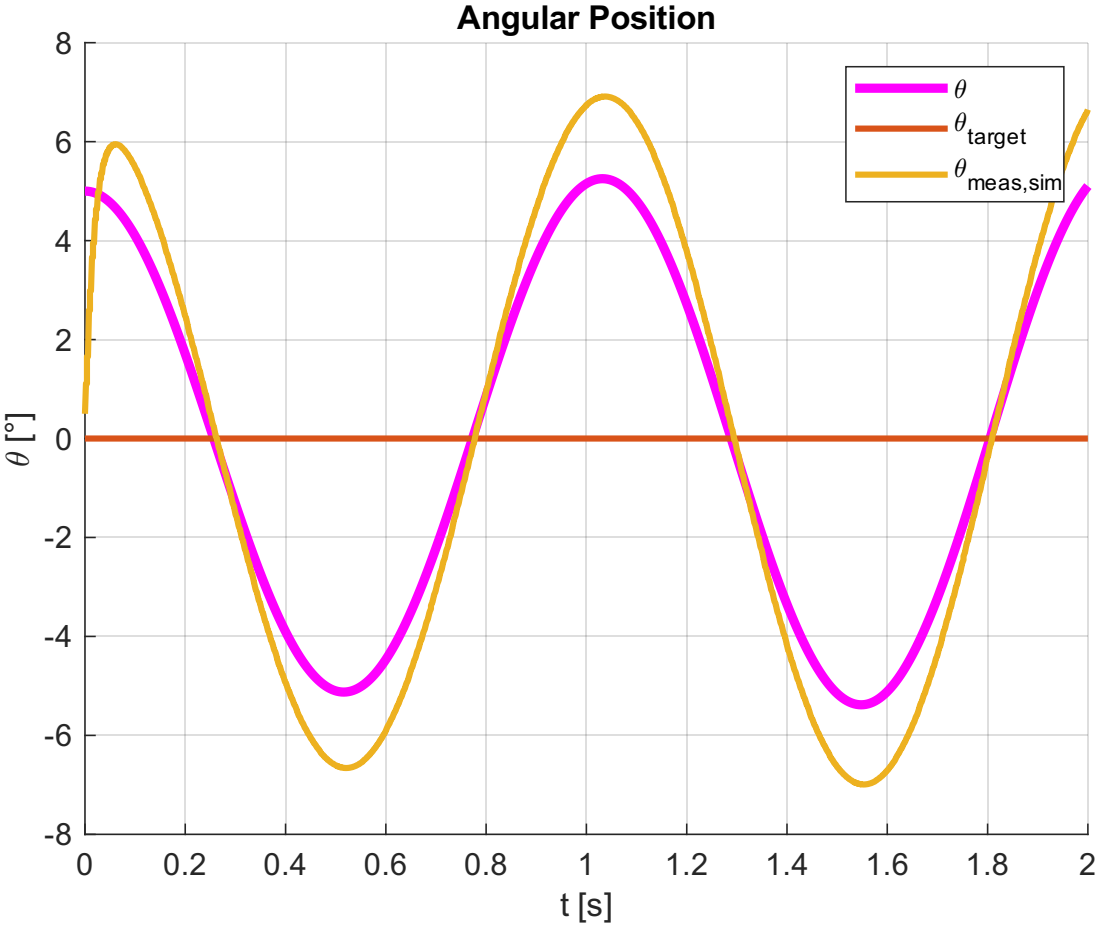
[picture p110: page 1]
Angular Position

3 3 target

3meas,sim
