Ding-Jeremy/Self-Balancing-Bot/A_Documentation/Rapport/assets/figures/graphs/reg_PD_angles.pdf

Angular Position

3 3 target

3meas,sim
