Ding-Jeremy/Self-Balancing-Bot/A_Documentation/Rapport/assets/figures/graphs/velocity_misalign_com.pdf

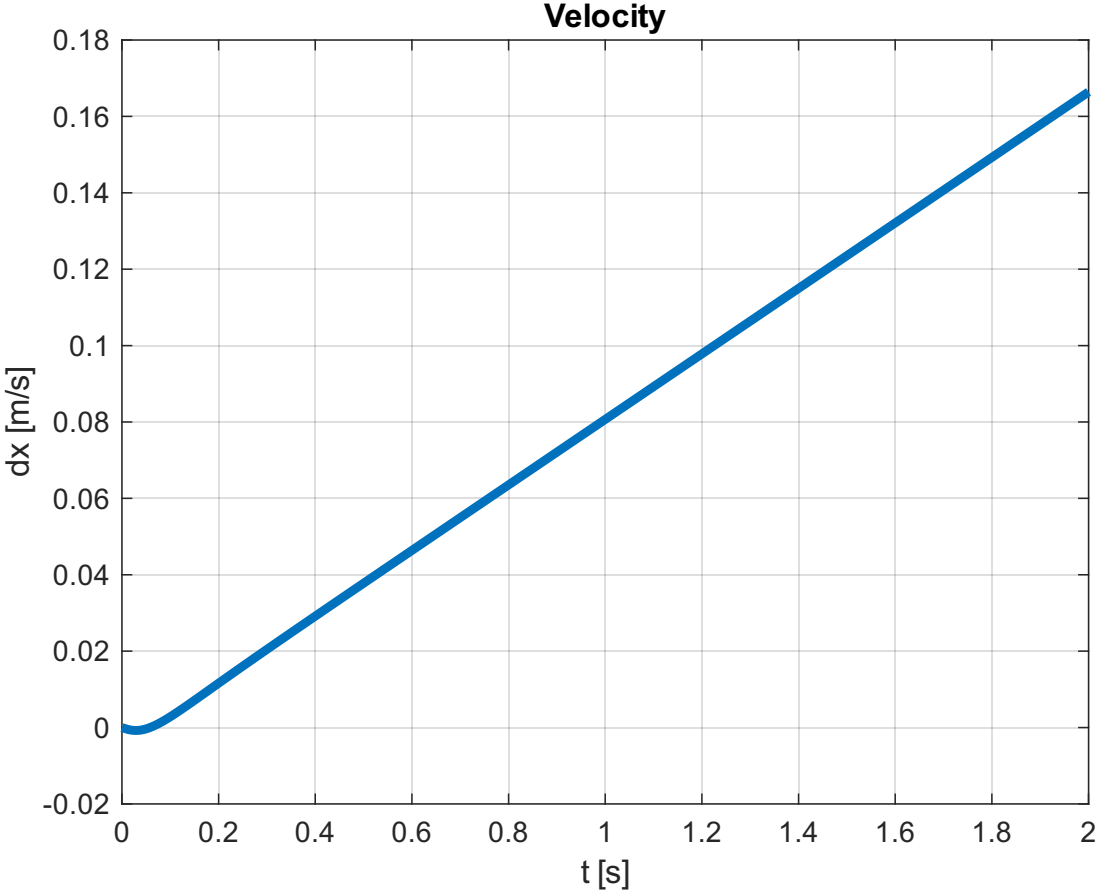
[picture p111: page 1]
Velo; city
