Ding-Jeremy/Self-Balancing-Bot/A_Documentation/Rapport/assets/figures/graphs/hold_negative_angle.pdf

Angle

3mes
3 target,mes
