Ding-Jeremy/Self-Balancing-Bot/A_Documentation/Rapport/assets/figures/graphs/imu_position_effect.pdf

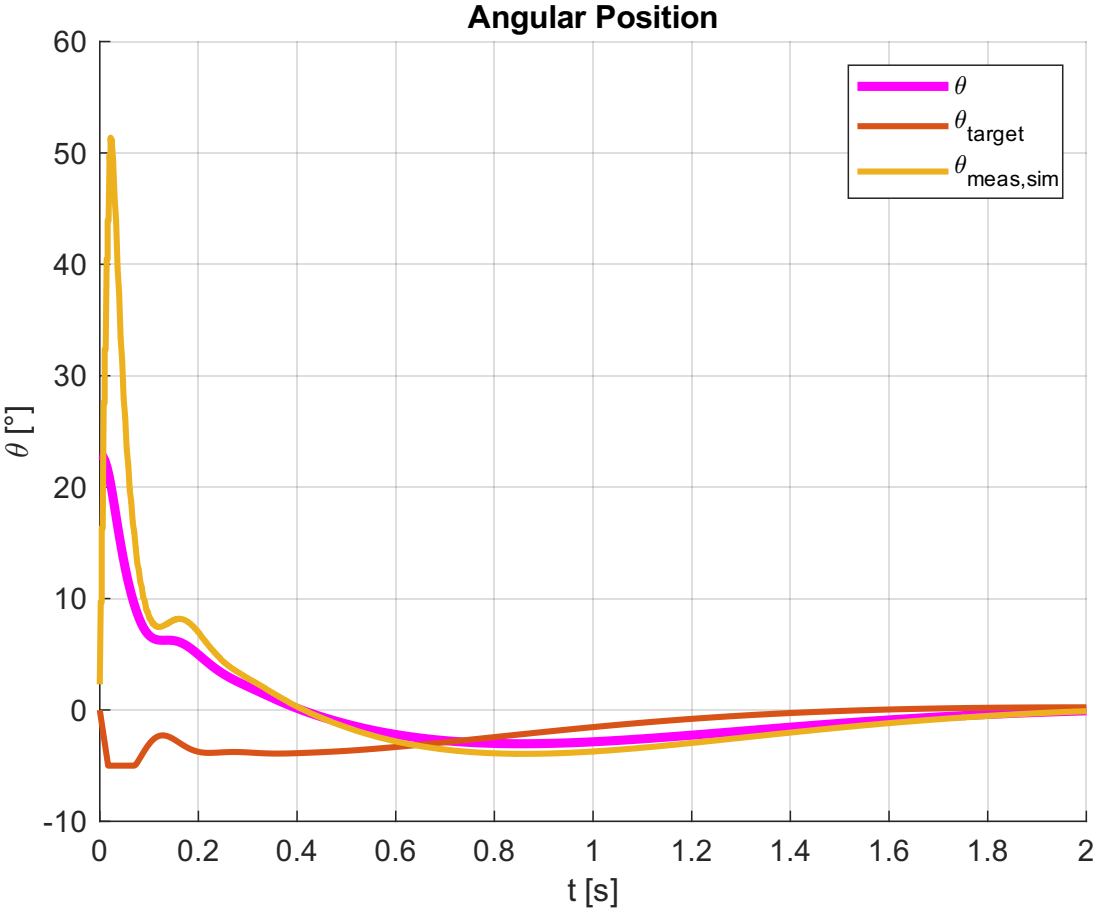
[picture p112: page 1]
Angular Position

3 3 target

3meas,sim
