Ding-Jeremy/Self-Balancing-Bot/A_Documentation/Rapport/assets/figures/graphs/max_angle.pdf

Angular Position

3mes dxmes

3 lim
3 lim -30° crossing
