Ding-Jeremy/Self-Balancing-Bot/A_Documentation/Rapport/assets/figures/graphs/trapez_move_position.pdf

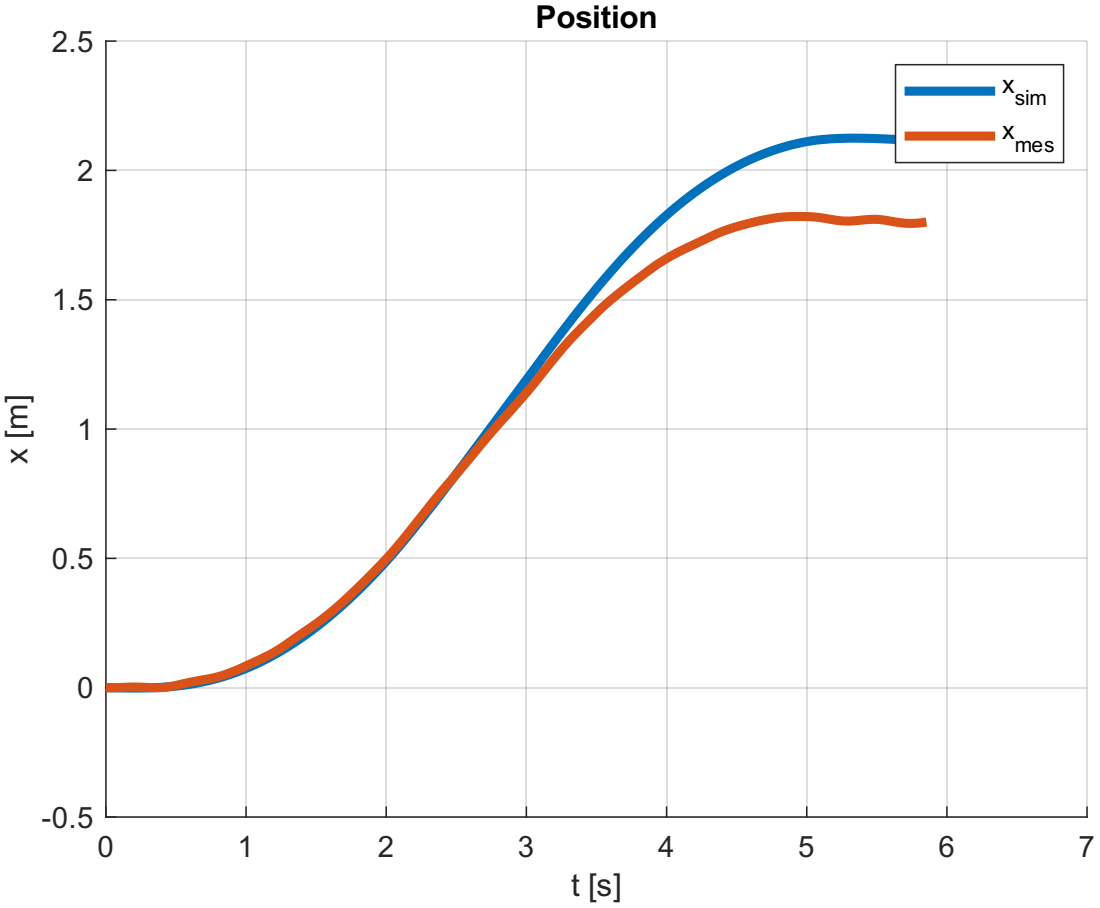
[picture p113: page 1]
sitio; sim
