Ding-Jeremy/Self-Balancing-Bot/A_Documentation/Rapport/assets/figures/graphs/trapez_move_theta.pdf

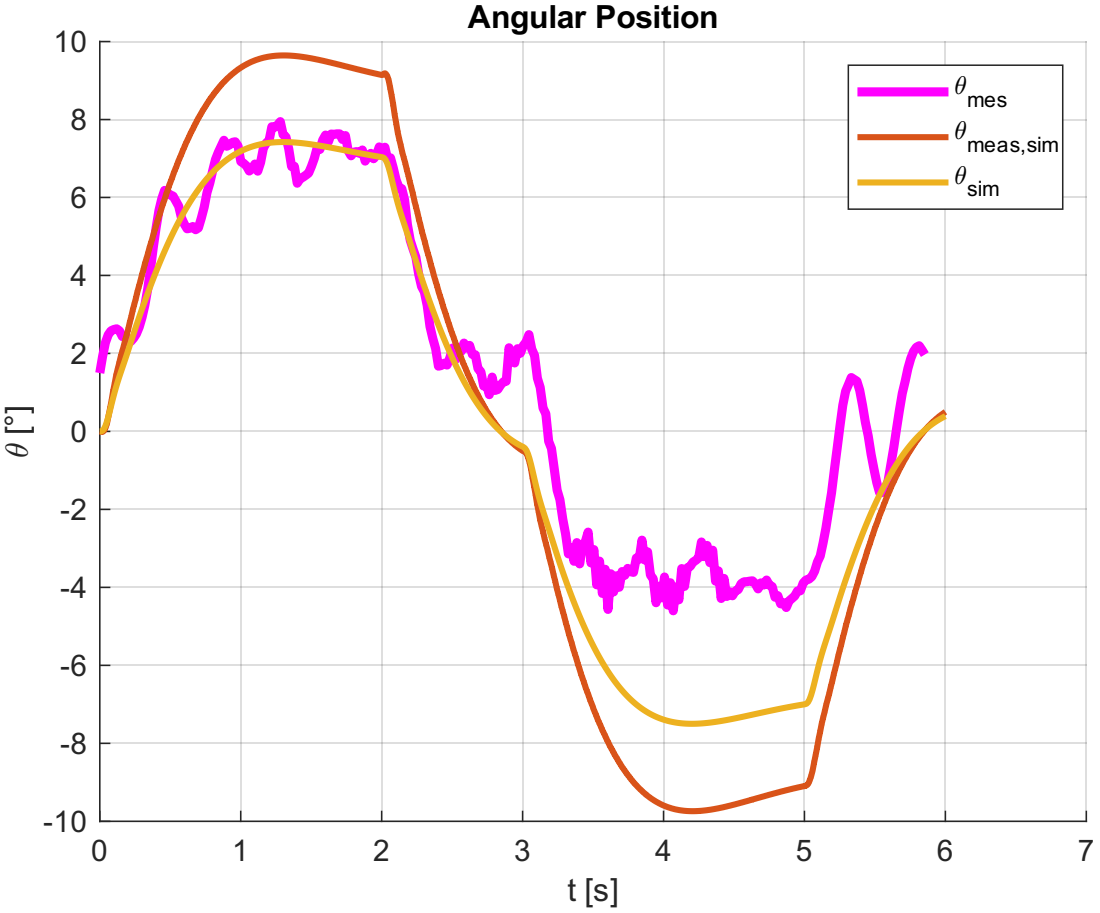
[picture p114: page 1]
ula; sitio

3 m e s
3 m e a s,sim 3 sim
