Ding-Jeremy/Self-Balancing-Bot/A_Documentation/Rapport/assets/figures/graphs/trapez_move_velocity.pdf

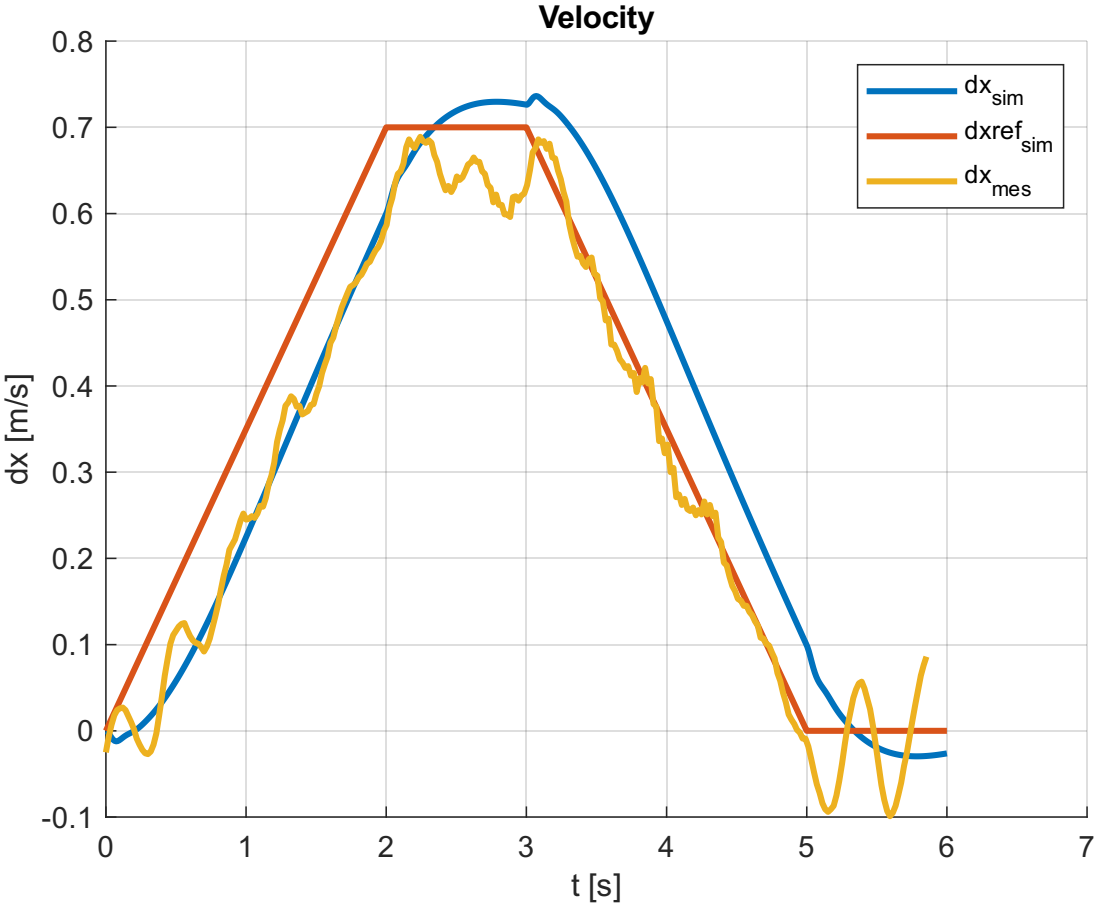
[picture p115: page 1]
Velo; cit

d x sim d x r e

fsim d x m e s
