Ding-Jeremy/Self-Balancing-Bot/E_Simulations/Matlab/theta.pdf

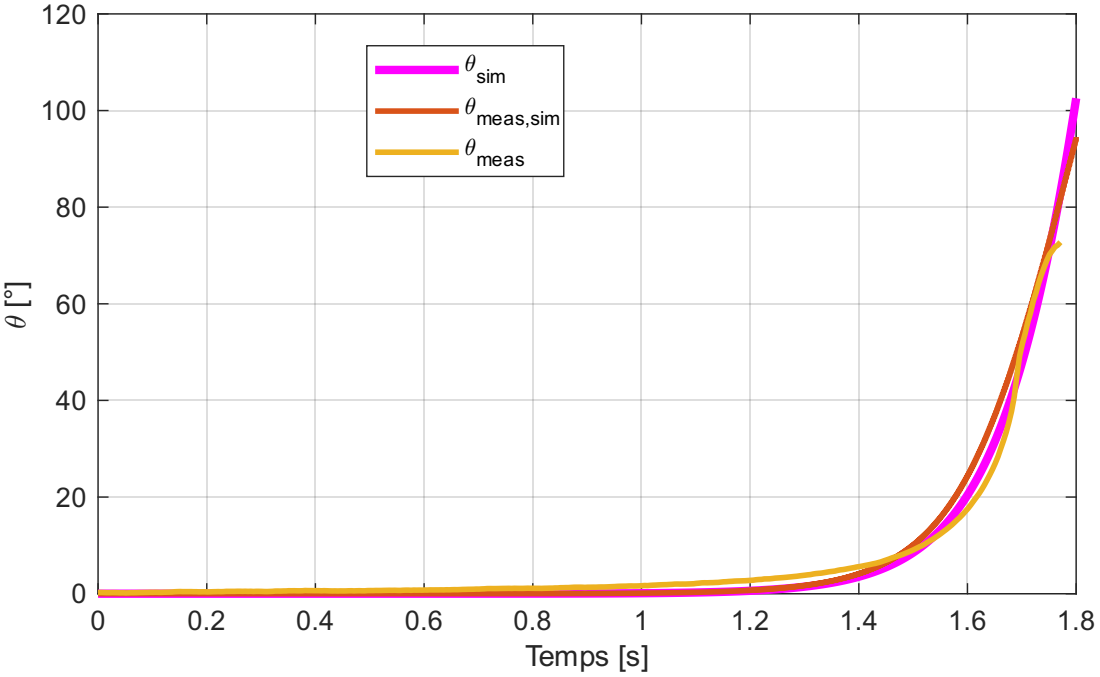
[picture p116: page 1]

3 sim 3

m e a s,sim 3 m e a s
