Ding-Jeremy/Self-Balancing-Bot/C_Fabrication/V0/A_Circuit/A_Kicad/Self_Balancing_Bot_V0/Self_Balancing_Bot_V0.kicad_pcb

## KiCad design C_Fabrication/V0/A_Circuit/A_Kicad/Self_Balancing_Bot_V0/Self_Balancing_Bot_V0.kicad_pcb (2026-07-06)

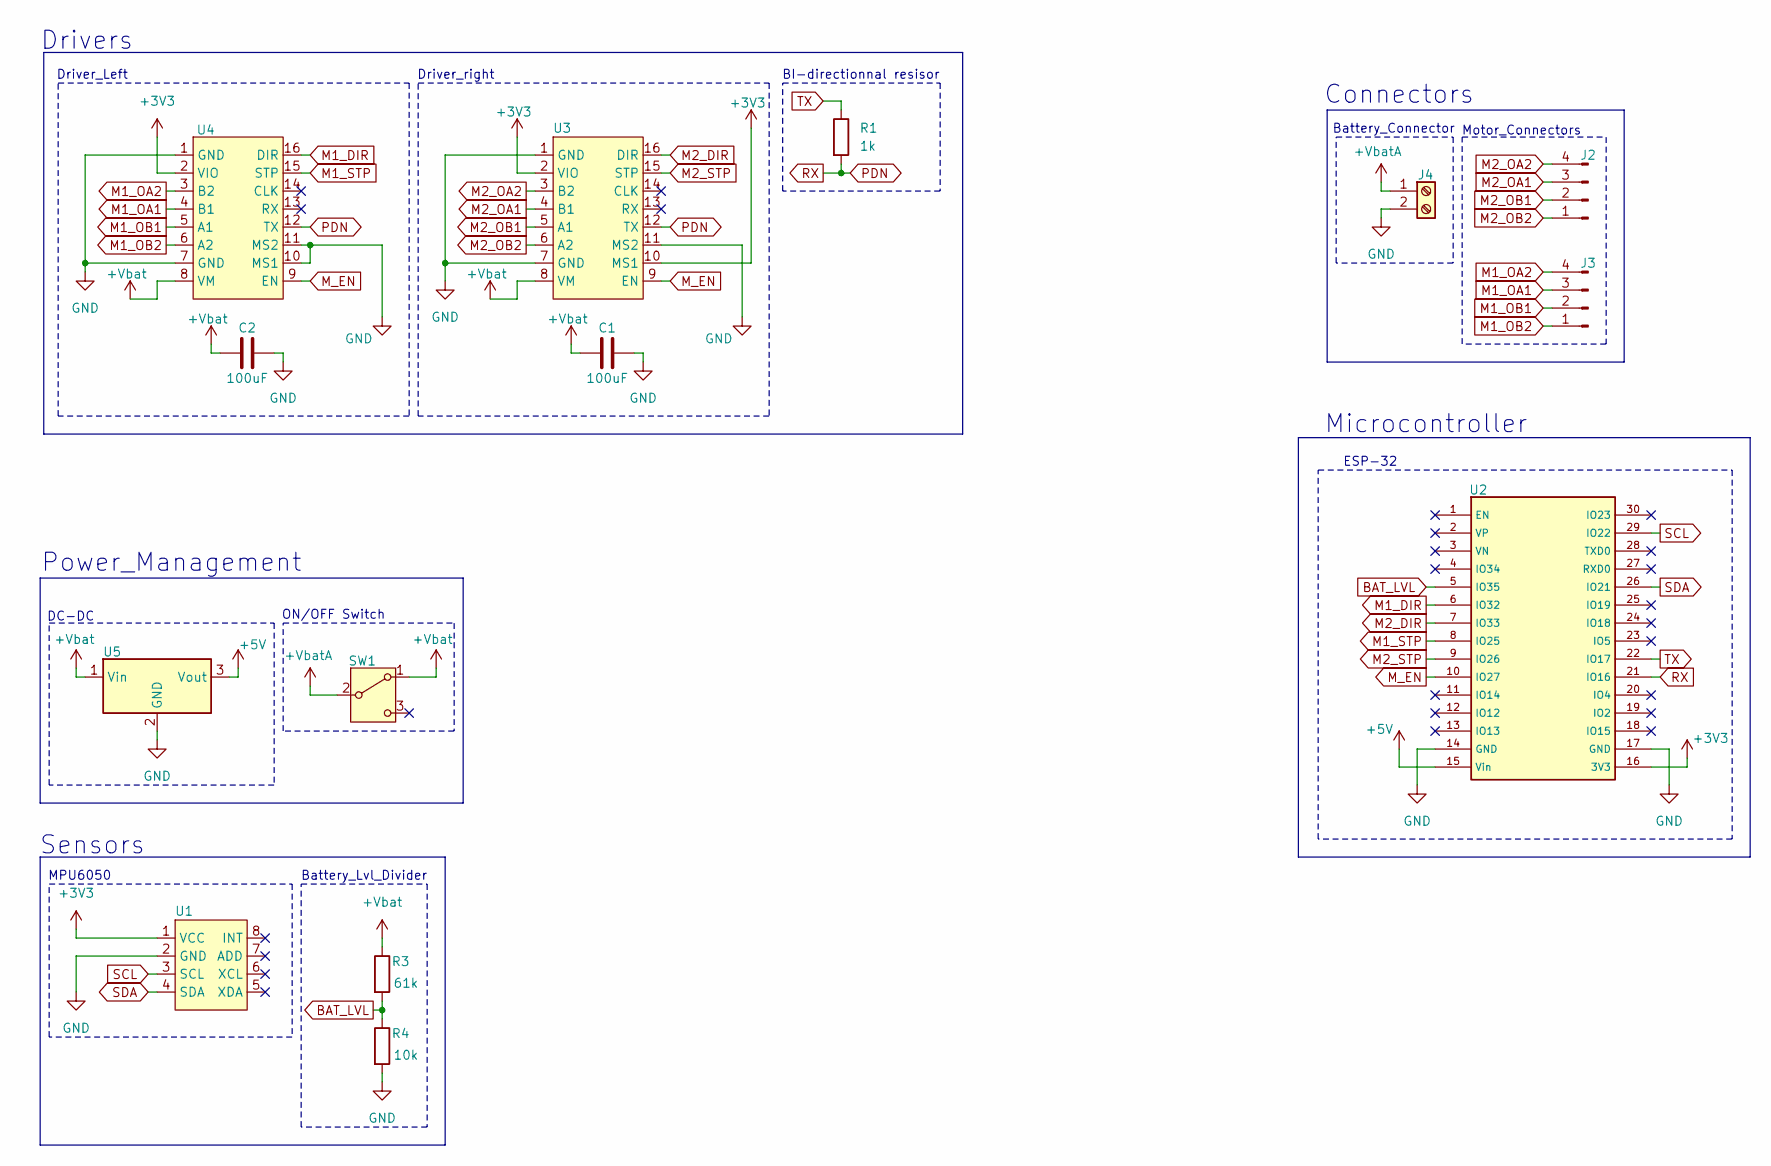
[picture p117: schematic Self_Balancing_Bot_V0.kicad_sch]

Parts:
C1, C2: 100uF; C_Elec_6.3x5.8
J2, J3: Conn_01x04_Pin; PinHeader_1x04_P2.54mm_Vertical
J4: Screw_Terminal_01x02; TerminalBlock_Phoenix_MKDS-1,5-2_1x02_P5.00mm_Horizontal
R1: 1k; R_1206_3216Metric
R3: 61k; R_1206_3216Metric
R4: 10k; R_1206_3216Metric
SW1: SW_SPDT; SW_Slide_SPDT_Angled_CK_OS102011MA1Q
U1: MPU6050
U2: ESP32_DEVKITC_30P
U3, U4: TMC2130
U5: TSR1-2450E; Converter_DCDC_TRACO_TSR1-xxxxE_THT

Connections:
+3V3: U1.1 (VCC), U2.16 (3V3), U3.2 (VIO), U3.10 (MS1), U4.2 (VIO)
+5V: U2.15 (Vin), U5.3 (Vout)
+Vbat: C1.1, C2.1, R3.1, SW1.1 (A), U3.8 (VM), U4.8 (VM), U5.1 (Vin)
+VbatA: J4.1, SW1.2 (B)
BAT_LVL: R3.2, R4.1, U2.5 (IO35)
GND: C1.2, C2.2, J4.2, R4.2, U1.2 (GND), U2.14 (GND), U2.17 (GND), U3.1 (GND), U3.7 (GND), U3.11 (MS2), U4.1 (GND), U4.7 (GND), U4.10 (MS1), U4.11 (MS2), U5.2 (GND)
M1_DIR: U2.6 (IO32), U4.16 (DIR)
M1_OA1: J3.3, U4.4 (B1)
M1_OA2: J3.4, U4.3 (B2)
M1_OB1: J3.2, U4.5 (A1)
M1_OB2: J3.1, U4.6 (A2)
M1_STP: U2.8 (IO25), U4.15 (STP)
M2_DIR: U2.7 (IO33), U3.16 (DIR)
M2_OA1: J2.3, U3.4 (B1)
M2_OA2: J2.4, U3.3 (B2)
M2_OB1: J2.2, U3.5 (A1)
M2_OB2: J2.1, U3.6 (A2)
M2_STP: U2.9 (IO26), U3.15 (STP)
M_EN: U2.10 (IO27), U3.9 (EN), U4.9 (EN)
PDN: R1.2, U2.21 (IO16), U3.12 (TX), U4.12 (TX)
SCL: U1.3 (SCL), U2.29 (IO22)
SDA: U1.4 (SDA), U2.26 (IO21)
TX: R1.1, U2.22 (IO17)

Notes on the sheet:
Battery_Connector
ON/OFF Switch
DC-DC
Sensors
Power_Management
Driver_right
Connectors
Microcontroller
Driver_Left
Motor_Connectors
Drivers
ESP-32
MPU6050
BI-directionnal resisor
Battery_Lvl_Divider

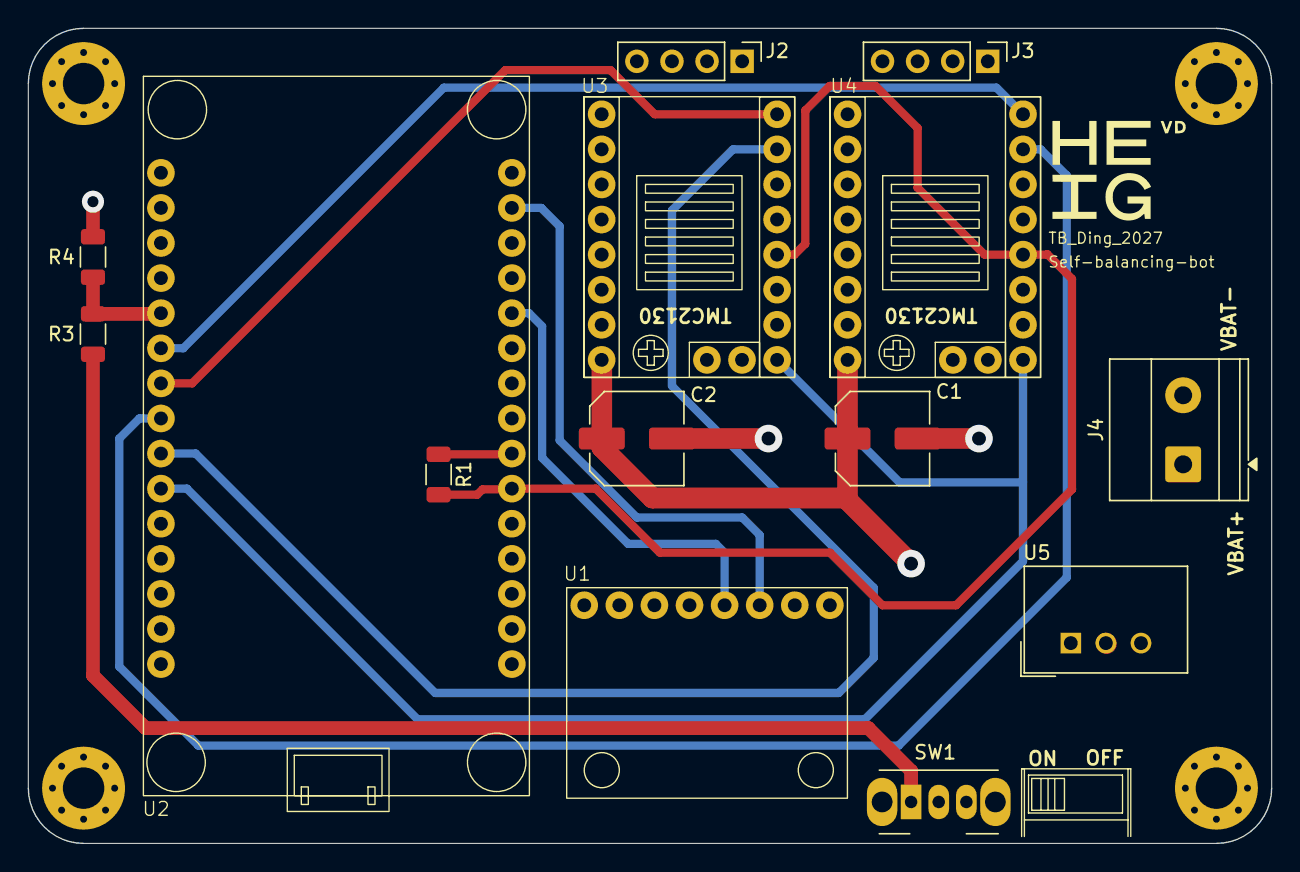
[picture p118: board Self_Balancing_Bot_V0.kicad_pcb from above]

Board: 4 copper layers, 90.0 x 59.0 mm, 14 parts (0 on the bottom side), 23 nets.
