Ding-Jeremy/Self-Balancing-Bot/(commit log)

2026-05-28 Added ESP32 project, firmware
2026-05-31 Add step pin
2026-06-01 implement mpu sensor
2026-06-02 Added PID regulator, rm functions in TMC2226
2026-06-03 modified regulator parameters
2026-06-03 upgrade PID, added functions on web app
2026-06-03 upgraded website, added PID tuner
2026-06-04 Upgraded website, modified PID dimensions
2026-06-04 modified PID (position)
2026-06-18 Added record function, re-implemented speed (PID)
2026-06-23 Added battery function
2026-06-24 Added planning, modified PID, (back to acceleration)
    [Planning.xlsx]
2026-06-24 Modified Resisors Ratio, Max wheel acceleration, Motors off mode
2026-06-25 Update Electronic design redaction, stepper current
2026-06-29 Added Matlab files, Component's bills, DrawIO schematics, KiCad Files
    [A4988.STEP, Adafruit_BNO055_AP214.STEP, BOM.xlsx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]
2026-06-30 updated planning, update component's choice, electronics design
    [Planning.xlsx]
2026-07-01 Modified Battery support (Added groove), Modified fall protection, TPU
    [Battery_Support.stl, Fall_Protectoin.stl, Planning.xlsx]
2026-07-01 Added motors current explanation
2026-07-06 Electronic design redaction, Annexes
    [Planning.xlsx, Self_Balancing_Bot_V0.kicad_pcb, Self_Balancing_Bot_V0.kicad_sch]
2026-07-07 Electronic design, BOM
    [BOM.csv, Self_Balancing_Bot_V0.csv]
2026-07-07 End of electronic design's rapport
    [BOM.xlsx, Planning.xlsx, Self_Balancing_Bot_V0.kicad_sch]
2026-07-07 Beginning of programming redaction
    [BOM.csv, BOM.xlsx]
2026-07-08 Redaction of Embedded system programmation, Modified HTML title, refactor TMC2226.cpp
    [Planning.xlsx]
2026-07-10 updated redaction of mechanical design, modelisation
    [Planning.xlsx]
2026-07-14 Matlab modifications, modelisation redaction
    [Planning.xlsx, free_fall_negative.csv, free_fall_positive.csv]
2026-07-15 Modified limit values, updated IMU simulation
    [maintient.csv, maintient_choc.csv, side_hit_neg.csv, time_theta.csv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]
2026-07-16 Fixed integer error (motor_speed), more simulation
    [hit_neg_nofilt.csv, hit_pos_nofilt.csv, hold_nofilt.csv, maintient.csv, maintient_choc.csv, side_hit_neg.csv, time_theta.csv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]
2026-07-20 New measurements, analysis, redaction
    [free_fall_negative.csv, free_fall_positive.csv, hold_neg.csv, max_speed_max_angle.csv, pulse_negative.csv, pulse_positive.csv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]
2026-07-21 redaction, corrected mistake in report
    [main.cpp]
2026-07-22 Finished analysis, conclusion started
    [Planning.xlsx]
2026-07-22 Measurement of PLA wheels, updated planning, BOM, redaction of conclusion
    [BOM.xlsx, Planning.xlsx, pla_wheel.csv, trapezoidal_move_pla.csv]
2026-07-22 Refactored code, fixed bugs
    [TMC2226.cpp, TMC2226.h, main.cpp]
2026-07-23 Project clean up, finished
    [free_fall_negative.csv, free_fall_positive.csv, hold_neg.csv, max_speed_max_angle.csv, pla_wheel.csv, pulse_negative.csv, pulse_positive.csv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]
2026-07-23 Added user guide, updated planning
    [Planning.xlsx]
2026-08-28 Added defense powerpoint and poster
